77-GGG/CyberArm/mechanical/打印/README_打印前必读.md

# RevC 打印文件

2026-09-14 状态更新：当前先进行上位机/模拟控制器测试，测试通过并完成打印准备审查后再使用打印件。模型尚可修改，本目录是现有 RevC 的候选资产；若几何更新，必须换成对应的新版本 STL，不能直接沿用旧件。进入制作阶段后仍先接口试装，再整机打印。

整理日期：2026-09-08。适用：拓竹 P1S、PLA Basic。此目录是当前 RevC STL 的分类副本，没有修改模型、孔径或缩放；没有混入旧版、舵机、原厂舵盘或金属五金模型。

## 三个文件夹怎么用

| 文件夹 | 内容 | 用法 |
|---|---|---|
| `01_所有完整打印件` | 12 种完整零件，整套需要 16 件 | 完整件总清单；文件名已标出数量 |
| `02_先打印的接口试装片` | S01–S06 共 6 个局部接口试片 | 先验证实物舵盘孔距、检修孔、螺丝和螺母叠厚；不是整机零件 |
| `03_不单独打印试片的零件` | 7 种没有专用舵盘接口试片的完整件 | 从 01 中单独分类的副本；打印完整件后仍需检查装配 |

**不要把三个目录全部导入并一起打印：03 与 01 部分重复。** 01 是整套零件的唯一计数依据；文件名“打印 4 件”表示切片软件里要设置 4 个实例，不是 STL 已经包含 4 个。试片另外计数，不计入整机 16 件。

03 的含义仅是“不额外打印独立接口试片”，不是“无需试装”或“已经验证能用”。尤其底座、小臂的舵机安装位，以及夹爪销轴和连杆配合，仍需用实物完整试装。

## 完整件数量与分类

| 编号 | 零件 | 每台数量 | 对应独立试片 |
|---|---|---:|---|
| 01 | 底座壳 Base | 1 | 无；需检查舵机安装耳、支承和底座固定 |
| 02 | 支脚 Pata_de_Soporte | 4 | 无；需检查底座连接及接地 |
| 03 | 回转盘与肩部支架 Waist | 1 | S01 |
| 04 | 大臂 Arm_01 | 1 | S02、S03 |
| 05 | 小臂 Arm_02_v3 | 1 | 无；需检查舵机安装位和腕部避让 |
| 06 | 腕部支架 Arm_03 | 1 | S04 |
| 07 | 夹爪底板 Gripper_base | 1 | S05 |
| 08 | 从动齿轮连杆 gear1 | 1 | 无；需检查啮合和销轴配合 |
| 09 | 夹爪短连杆 grip_link_1 | 2 | 无；需检查两侧销轴配合 |
| 10 | 左夹爪 Gripper_1 | 1 | 无；需检查销轴及夹爪联动 |
| 11 | 主动齿轮连杆 gear2 | 1 | S06 |
| 12 | 右夹爪 Gripper_1_1 | 1 | 无；需检查销轴及夹爪联动 |

试片通过后再打印对应完整零件；试片不能代替整件，也不能验证相邻固定支架、舵机全部安装空间或强度。

## 先打印哪些试片

| 试片 | 接口 | 要使用的实物舵盘 |
|---|---|---|
| S01 | 底座回转 | MG996R 圆盘，选孔中心距 14 mm |
| S02 | 肩关节 | MG996R 圆盘，选孔中心距 14 mm |
| S03 | 肘关节 | MG996R 圆盘，选孔中心距 14 mm |
| S04 | 腕旋转 | MG90S 双臂，选孔中心距 12 mm |
| S05 | 腕俯仰 | MG90S 十字的长臂，选孔中心距 12 mm |
| S06 | 夹爪驱动 | MG90S 单臂，同侧距轴心 6 / 11 mm 两孔，孔距 5 mm |

每个试片先打印 1 件。S02、S03 的接口设计相同，可以先试其中一个，两个文件均保留用于对应位置核对。孔距来自当前模型，仍须和你的实物舵盘比对，不代表已完成实测。

本方案舵盘与打印件使用 M2 通栓、垫片和螺母连接，原厂中心短螺丝只用于舵盘锁紧。原厂舵盘的选定孔需在确认孔距后离机加工至 Ø2.2；打印件对应通孔为 Ø2.4。不能强拉螺丝对孔，也不要打印舵盘花键来替代原厂件。完整方法见 [RevC 连接与试装说明](E:/CyberArm/mechanical/arduino_reference_revC/ASSEMBLY_RevC_zh.md) 和 [连接图册](E:/CyberArm/mechanical/arduino_reference_revC/connections.html)。

## 切片与未完成事项

- STL 按毫米导出；导入 Bambu Studio 时保持 100% 尺寸。支脚、连杆复制数量按清单设置。不要整体缩放来修正孔径。
- 所有单件包围盒均小于 167 mm，但本目录尚未做多件排板、支撑优化或生成 3MF / G-code；壁数、填充和摆放方向需要切片时确认。
- 大臂 Arm_01 沿用源模型的主臂和小钩附件两个相交网格壳。它们原样保留；检查切片层预览是否形成连续实体，不要误删附件或忽略重叠壳问题。
- 当前是接口试装版，所有完整件的 `final_print_release` 仍为 `false`。底座固定、关节支承、全行程干涉、实际重量和持续承载尚未完成实物验证；不要把这里的分类当成整机打印放行。
- 先完成接口验证和完整件干装，再按 [结构、载荷与电流复核](E:/CyberArm/mechanical/arduino_reference_revC/audit_20260907/结构载荷与电流复核_20260907.md) 处理支承/固定问题并测试。当前未确认额定夹取质量。

`打印数量清单.csv` 可用表格软件打开；`文件来源与校验.json` 记录原始位置、分类副本、数量、尺寸和 SHA256。此次只复制和分类，不改变原 RevC 文件及 Blender 装配。
