77-GGG/CyberArm/mechanical/arduino_reference_revC/audit_20260907/结构载荷与电流复核_20260907.md

# RevC 结构、夹取质量与电流复核

日期：2026-09-07。对象：`Arduino_Replica_RevC_Connections.blend` 中的 `Arduino_Original_Replica` 装配场景。

用户已确认：PLA Basic，所有舵机均为 5 V 供电。电源额定安培数、打印切片重量、实物舵机批次性能尚未提供。

## 结论

**当前版本不具备“全行程、可持续夹取某个最大质量”的定版依据，不能把 100 g 写成额定载荷。**

- 主要限制是肩关节自重力矩、腕俯仰 MG90S、底座抗倾覆和关节支承；不能靠加粗大臂或增大供电电流解决全部问题。
- 原结构没有外置底座止推/径向轴承，也没有完成肩部双侧支承。舵机输出轴、塑料舵盘和安装耳承担了转矩以外的负荷，厂商未给出这里需要的外部弯矩/轴向载荷额定值。
- 支脚只有可靠锁紧、共同着地才扩大支承范围。无可靠支脚支承时，较大伸展姿态可能空载倾覆。
- **6 台舵机的电源选型暂按 10.5 A 峰值预算，建议舵机独立使用稳压 5 V / 15 A（75 W）电源。** 这是工程预算，不是本批实物已经测出的最大电流，不是允许持续堵转。主控、视觉板等用电另算。
- 尚未确定可认证的最大夹取质量。固定底座、确认装配和限位后，只能先做无载及 5 g、10 g 的短时低速验证；这些是试验台阶，不是额定载荷。

本次只做读取、计算与报告，没有修改装配、STL、既有说明书或固件，也没有保存/覆盖 Blender 窗口中未保存的状态。

## 1. 核算依据和边界

### 几何与质量

使用现有 16 个打印件实例：12 种零件，其中支脚 4 个、短连杆 2 个。以闭合三角网格四面体积分计算实体体积和质心，不用包围盒体积代替实体体积。

PLA Basic 密度取 1.24 g/cm³，来源于 [Bambu Lab 技术数据表](https://store.bblcdn.com/s7/default/b189de92249a4b9ebed28b8ea1f080f0/Bambu_PLA_Basic_Technical_Data_Sheet.pdf)。

| 质量项 | 本次代理值 |
|---|---:|
| 所有打印件按几何实体完全填满 | 460.5 g |
| MG996R ×3，55 g/个 | 165.0 g |
| MG90S ×3，13.4 g/个 | 40.2 g |
| 已建金属螺钉、螺母、垫圈和夹爪销轴，按钢密度 | 16.0 g |
| 六片原厂塑料舵盘质量占位 | 6.3 g |
| 未建模的安装五金及末端线缆余量 | 28.0 g |
| 合计，不含负载、控制板、相机、额外配重 | 716.0 g |

舵机质量和力矩来源：[TowerPro MG996R](https://towerpro.com.tw/product/mg996r/)、[TowerPro MG90S](https://towerpro.com.tw/product/mg90s-3/)。舵机内部质心用壳体内近似点；金属件材质、线材余量和舵盘质量均未实称。

**460.5 g 不是切片预测重量。** 同时计算打印塑料为实心质量 75%、50% 的敏感性工况。这里的 75%、50% 是“实际零件重量/几何实心重量”，不是切片填充率；壁厚、顶底层、打印方向和内部壳体都会改变这个比例。

减轻大臂、小臂通常减少舵机负担；只减轻底座却会减小抗倾覆余量。因此不能把全实心质量情形当成所有失效模式的最坏情况。

### 力矩方法

本机为 5 V；采用厂商 4.8 V 的力矩作为保守参考，不把 6 V 的性能套用到 5 V：

- MG996R：堵转 9.4 kgf·cm = 0.9218 N·m。
- MG90S：堵转 1.8 kgf·cm = 0.1765 N·m。

各关节静力矩按 `Σ 关节轴方向 · [(质心位置−轴心) × 重力]` 计算；逐个分配对应下游零件、舵机、五金和线材，不把所有电机错误地加到腕部。

负载作用点取夹爪末端的对称参考位置。实际物体重心若更远、偏侧或夹持位置不同，应重新计算。

表中的“50% 堵转筛选”表示暂留约 2 倍静态力矩余量，**是工程筛选假设，不是厂商连续转矩额定值**。厂商没有提供本工况的连续负载/占空比/温升曲线，故不能据此宣布可以长期保持或快速运动。另计算 30% 堵转情形时，所列三种质量工况的肩部都没有剩余载荷预算。

## 2. 最大夹取质量：只能给条件计算，不能给实物额定值

保存姿态夹点距底座回转轴约 265 mm。另取近水平伸展的几何参考姿态，夹点约 334 mm，大臂两关节轴距 120 mm。

334 mm 工况是运动学参考；它超过现有部分预览角度，**尚未验证实际舵机角度、全机碰撞、线缆和硬限位，不可照抄到舵机控制程序**。这不是已经确认的最大安全臂展。

### 肩关节自重静力矩

| 打印件质量假设 | 整机质量代理 | 保存姿态，无物体 | 近水平伸展，无物体 |
|---|---:|---:|---:|
| 实心质量的 100% | 716 g | 0.4166 N·m | 0.5453 N·m |
| 实心质量的 75% | 601 g | 0.3574 N·m | 0.4680 N·m |
| 实心质量的 50% | 486 g | 0.2982 N·m | 0.3908 N·m |

MG996R 的 50% 堵转筛选预算仅为 0.4609 N·m。因此在较重的两种伸展工况下，仅自重就耗尽了这一预算。最重工况空载约占参考堵转力矩 59%；加 50 g 后肩部约需 0.716 N·m，加 100 g 后约需 0.886 N·m，已经接近堵转参考值。

### 仅按关节力矩的附加负载筛选

下表取肩、肘、腕旋转、腕俯仰四项限制中的最小值；**还未把真实夹持摩擦、打印强度、倾覆或动态加速度认证计入**。

| 打印件质量假设 | 265 mm 保存姿态 | 334 mm 近水平参考姿态 |
|---|---:|---:|
| 实心质量的 100% | 约 16 g | 0 g 余量 |
| 实心质量的 75% | 约 38 g | 0 g 余量 |
| 实心质量的 50% | 约 60 g | 约 21 g |

“0 g 余量”表示连空载都未满足选定的 2 倍静态力矩余量，**不是说舵机完全抬不起来**。

腕俯仰也不可忽略：较重的近水平工况，在该筛选标准下约剩 45 g 的负载预算。即使给肩部加助力，也不能自动把全机额定载荷提高到几百克。

现有预览角度内另外抽查 405 个姿态，发现肩部空载力矩最高约 0.50 N·m，也超过了 0.4609 N·m 的筛选预算。该抽样不是连续全空间最大值或无碰撞验证。

### 夹爪本身能否抓住

采用已保存的四连杆运动关系，按末端代表点的开合位移求虚功关系 `T = N × d(开口)/d(舵机角度)`。在夹爪偏转 −8° 到 +8° 的样本中，按半堵转转矩得到每侧理想法向力约 2.5～4.5 N。

举例：若摩擦系数仅 0.2、机构效率暂取 0.6，则抗滑质量估算约 62～111 g。**这两个参数都是假设，物体材质、接触法线、打印纹理、夹持位置、机构自重功和磨损没有实测，不能据此承诺夹爪额定载荷。** 光滑物体、偏心物体可能更早滑落。加防滑软垫可改善摩擦，但不会提升肩部舵机转矩。

## 3. 抗倾覆与结构稳定性

### 接地支承

底座外径约 130 mm，四脚接地凸包包络约 195 × 195 mm。模型中五个底面基本共面；实物桌面平整度、翘曲、脚垫厚度、支脚紧固和滑动均未验证。

以四脚牢固连接、共面着地、静止、不滑动为条件：

| 打印件质量假设 | 265 mm 姿态，理论刚好倾覆负载 | 334 mm 工况，理论刚好倾覆负载 | 334 mm，保留 1.5 倍抗倾覆力矩余量后的筛选负载 |
|---|---:|---:|---:|
| 100% | 约 191 g | 约 80 g | 约 20 g |
| 75% | 约 157 g | 约 63 g | 约 14 g |
| 50% | 约 122 g | 约 46 g | 约 7 g |

这些是倾覆分析，不是夹取能力。即使机械臂能抬起物体，也可能先翻倒。只减轻底座和腰部、不减轻远端的工况更差：示例计算空载就不满足 1.5 倍抗倾覆余量。

若四脚不提供有效支承，只依赖 130 mm 底座接触范围，近水平参考姿态的自重质心已越过支承边界。**优先采用可靠桌面夹持/螺栓固定，而不是再把底座外形做大。** 本次未设计或验证夹具。

橡皮筋/弹簧装在机械臂自身两个挂点之间，是内部助力：它能减轻肩部驱动力矩，但不改变整机给定姿态的重心，不能代替固定底座来防翻。

### 必须处理或验证的局部结构

1. **底座回转支承。** 最低旋转打印表面与底座最高表面的全局高度差约 0.60 mm（局部垫台影响最低点）。没有可认定为承载止推面或外置轴承的建模结构。不能把悬空外壳当作支承，更不能直接强拧中心螺丝拉到相互摩擦。应另设计匹配的止推/径向支承，并保留转动间隙。
2. **肩、肘输出端的偏载。** 舵盘传转矩不等于舵机轴可以无限承担悬臂弯矩。需要复核对侧支点/双侧支承和轴套；仅凭 MG996R 的堵转转矩无法验证外部轴负荷。轴承选型尚无明确安装尺寸，不建议先购买某一型号再硬塞。
3. **舵盘扩孔连接。** 两孔相隔 14 mm 的 MG996R 接口，若只按螺栓孔壁传力、忽略夹紧摩擦，在 0.5 N·m 时每孔约承受 35.7 N；Ø2.2、厚 2.3 mm 舵盘的名义孔壁承压约 7.1 MPa，接近参考堵转时约 13 MPa。这尚未包括相邻孔削弱、应力集中、塑料蠕变、单侧弯曲与锁紧预载。通常不能只校核金属 M2 螺钉而忽略薄塑料舵盘。
4. **夹爪活动销轴。** 当前约 Ø3.5 孔配 Ø3 的示意销，直径间隙约 0.5 mm。多处串联后会有晃动；活动处不能把普通螺母直接拧死夹住连杆。销轴、隔套、垫圈、轴向限位和防松仍需要定版。
5. **大臂挂钩网格。** Arm_01 的主臂与小挂钩是两个独立闭合壳，检测到 96 对三角面相交：不是悬空附件，但也不是已布尔合并的一体拓扑。打印前应检查切片是否合为连续材料、挂钩根部有效截面和层纹方向。不要直接给这个小钩挂强拉簧。
6. **打印方向和热稳定性。** 主臂/小臂抽查截面的名义实心弯曲应力在 0.5 N·m 参考弯矩下约 0.16～0.37 MPa，但这不覆盖关节根部、螺孔、扭转、局部屈曲、填充及层间开裂，不能作为整机强度合格结论。PLA Basic 技术表的热变形温度约 54～57℃（依载荷条件）；舵机附近不能忽视长期温升和夹紧蠕变。

## 4. 最大电流与电源

### 不同版本资料不能混作实测值

| 型号 | 当前可核对的资料 | 本次暂用选型峰值预算 |
|---|---|---:|
| MG996R ×3 | TowerPro 官网列堵转电流 1.4 A，未在该行标测试电压；另有标为 Tower-Pro 的流传数据表列 2.5 A @6 V | 2.5 A/台 ×3 = 7.5 A |
| MG90S ×3 | TowerPro 官网没有堵转电流；其他厂商同名型号资料给出约 0.75 A @4.8 V、0.86～0.9 A @6 V，不等于你的批次 | 1.0 A/台 ×3 = 3.0 A |
| 六舵机合计 | 5 V 下真实同时启动/堵转峰值仍需测量 | **10.5 A，52.5 W** |

来源：[TowerPro MG996R 官网](https://towerpro.com.tw/product/mg996r/)、[标为 Tower-Pro 的 MG996R 数据表副本](https://www.allaboutcircuits.com/uploads/articles/MG996R_Tower-Pro.pdf)、[Sky Star MG90S 厂商数据表副本](https://www.tinytronics.nl/product_files/000263_Data_Sheet_of_MG90S_Analog_Servo_Motor.pdf)、[MATRIX 自有 MG90S 产品说明](https://www.matrixrobotics.com/product/electrical-components/servo/matrix-micro-servo-with-metal-gear-box)。

2.5 A 是用较高参考值给 5 V 供电留余量，并非宣称该电机在 5 V 恰好堵转 2.5 A；1 A 同样是设计占位。型号相同不保证内部电机和控制电路相同，以上预算不能包住所有仿制批次的极值。**真正最大电流必须结合实物、电压、线损、峰值采样方式确认。** 正常运动/保持电流也不能仅从 CAD 精确求出。

六舵机 10.5 A 预算留 25% 余量为 13.125 A，故选型建议取 **稳压 5 V / 15 A**。这表示电源可提供的能力，不会强迫舵机持续吸收 15 A。

- 此建议仅用于舵机电源域。若 ESP32、K230D、摄像头、显示屏共用同一 5 V 电源，应把它们的实测峰值加上后再留余量，不能宣称 15 A 必然覆盖整套系统。
- 大电流通过合适的独立配电母线、连接器和保护件，不经过开发板 5 V 小引脚、普通杜邦线/面包板的公共电源通道。控制板与舵机采用合适的星形共地。
- 不能默认任意 PCA9685 转接板的端子和铜箔可通过 10.5 A 总电流；芯片负责 PWM，不代表转接板供电路径具备该额定电流。
- 电源/配电需要按导线与连接器能力配置限流、支路保护和可切断舵机电源的急停。PCA9685 的 OE 只关闭 PWM，不能代替物理断开电源。
- 不靠长时间卡死舵机测“最大电流”。先逐台受控、低速、小载荷测启动峰值、保持电流、舵机端电压，再验证多轴同时启动压降。出现卡死、发热、抖动、异响、变形或电压明显下跌立即卸载断电。试验时下方放软托盘、手离开夹点；断电后机械臂可能下落。

项目旧总体设计文档仍有“五路 MG90S”的电源配置描述，与当前“三路 MG996R + 三路 MG90S”不同，不能沿用旧负载预算。本次只是复核，没有擅自改写总体方案或固件。

## 5. 下一步放行条件

1. 先完成桌面固定、底座独立支承及关节防晃方案；确认安装耳、夹爪活动销轴和支脚的完整五金。
2. 用 P1S / PLA Basic 的实际壁数、顶底层、填充和打印方向切片，记录每个零件扣除支撑后的质量，替换本报告的实心比例假设。关键挂钩和连接件检查切片连续性，接口先做试片。
3. 用实物检查舵盘孔位、厚度、花键、中心锁紧螺丝和原厂安装螺丝；没有实测尺寸不能保证每批次通配。
4. 逐轴确定无碰撞机械行程和 PWM 限位；打印前后的零件联动预览不等于电气限位标定。
5. 固定底座，先空载低速短时试动，再按当时力矩余量做 5 g、10 g 阶梯试验。记录姿态、作用距离、持续时间、温升、端电压、峰值电流和末端下垂；没有余量的姿态不加重。
6. 只有上述数据合格后，才能定义“最大质量 + 工作范围 + 速度/加速度 + 连续保持时间”的联合指标。现阶段不能给出单一、可靠的全范围最大夹取质量。

## 计算记录

- `baseline_geometry.json`：各实例体积、质心、质量分配、轴心、支承凸包、网格指纹。
- `static_load_screen.json`：两类姿态和不同重量假设的静力矩、负载余量、倾覆计算。
- `preview_pose_sweep.json`：405 个预览姿态抽样，未做碰撞放行。
- `kinematic_crosscheck.json`：独立矩阵前向计算与 Blender 驱动器交叉比对，通过，最大矩阵分量误差约 2.2e−5。
- `beam_sections.json`：局部截面几何积分，不是 FEA。
- `hook_attachment_check.json`：挂钩与主臂独立壳相交检查。
- `gripper_virtual_work.json`：夹爪代表点虚功估算，不是实测夹紧力或接触仿真。
- 重算脚本：`E:/CyberArm/mechanical/revC_stability_audit.py`，仅在后台载入模型后运行，不保存 `.blend`。

**未完成：实物装配、真实切片质量、连续温升/负载、结构 FEA、全范围连续碰撞、打印疲劳、刚度/寿命、动态倾覆、配电实物验证。**
