77-GGG/CyberArm/slides/CyberArm_展示逐页内容方案.md

# CyberArm 展示逐页内容方案

## 总体安排

- 主版本共 9 页，适合约 7 分钟的现场介绍。
- 视觉识别本轮不展开，只说明系统预留了输入接口。
- 第 6 页集中解释正运动学、逆运动学和求解加速过程。
- 第 7 页把上位机联动与逐关节标定放在同一条链路中说明。
- 删除原方案中的串口长报文调试案例、完成度表和下一步页面。
- 最后一页直接说明机械结构、舵机和开环控制的局限。

版本口径：`CyberArm_RevL_Final.blend` 是当前最终机械 CAD；现有上位机的 `simulator/assets/revc/robot.json` 仍标记为 RevC。若演示前尚未重新导出 RevL 的关节、TCP 与碰撞资产，幻灯片应把渲染图称为“RevL 最终机械方案”，把上位机画面称为“当前控制模型”，不要宣称两者参数已经完全同步。

## 已生成的模型素材

- `renders/CyberArm_RevL_front.png`：整机正面四分之三视角，适合封面或结构说明。
- `renders/CyberArm_RevL_side.png`：舵机侧视角，适合执行器说明和局限性页面。
- `renders/CyberArm_RevL_rear.png`：后侧结构视角，适合标注 J1 至 J5 的关节链。
- 两张图片由 `mechanical/CyberArm_RevL_Final.blend` 的现有相机、材质和灯光渲染得到。

---

## 第 1 页｜封面

### 页面标题

**CyberArm**

### 副标题

桌面机械臂的建模、规划与实机控制

### 页面文字

清华大学电子系第 29 届硬件设计大赛  
马 +7 队｜祁果、许宇旋｜2026.09

### 画面建议

- 使用 `renders/CyberArm_RevL_front.png` 作为右侧主视觉。
- 标题放在左上或上方留白区，只保留项目名、副标题和队伍信息。
- 不放目录和功能列表。

### 讲述重点

CyberArm 是一套围绕桌面机械臂建立的软硬件系统，覆盖机械结构、运动学求解、三维仿真、逐轴标定和 ESP32-S3 实机执行。

---

## 第 2 页｜项目目标与当前样机

### 页面标题

项目目标与当前样机

### 页面主句

在接通实物之前验证动作，在接通实物之后完成安全标定和同步控制。

### 页面文字

**机械本体**

- 五个运动关节和一路夹爪
- 3 × MG996R，3 × MG90S
- RevL 3D 打印结构

**控制系统**

- ESP32-S3 负责轨迹执行与状态管理
- PCA9685 统一输出六路 PWM
- CyberArm Studio 负责模型、规划与调试

### 画面建议

- 右侧使用 `pics/0b8ecd9638317f569a953c7d0b11c092.jpg`，保留实体机械臂、控制板和电脑同框的部分。
- 左侧只保留主句和两组短说明。
- 照片旁用小字标出“实体样机”“上位机仿真”“ESP32-S3 + PCA9685”。

### 讲述重点

项目重点是把模型中的关节姿态可靠地传递到实体机械臂，并让每一步都能够检查、标定和停止。视觉能力后续沿用同一套规划与执行接口。

---

## 第 3 页｜机械结构与方案演化

### 页面标题

机械结构与方案演化

### 页面主句

承载、装配和调试需求推动机械臂从开题构型演化到 RevL。

### 页面文字

| 开题阶段 | 当前 RevL |
|---|---|
| 四个运动关节和一路夹爪 | 五个运动关节和一路夹爪 |
| 五路 MG90S | 3 路 MG996R 与 3 路 MG90S |
| 简化串联夹爪 | 两片式夹爪与连杆机构 |
| 先实现多种交互模式 | 先完成运动、标定与安全链路 |

### 结构说明

- J1：底座回转
- J2：肩关节俯仰
- J3：肘关节俯仰
- J4：腕部旋转
- J5：腕部俯仰
- G：夹爪开合

### 画面建议

- 使用 `renders/CyberArm_RevL_rear.png` 作为大图。
- 在图上直接标出 J1 至 J5 与 G，不额外画六个说明卡片。
- 开题与 RevL 的对比表缩小放在左侧。

### 讲述重点

肩、肘和底座改用 MG996R，提高承载余量。腕部与夹爪继续使用较轻的 MG90S，降低远端质量。RevL 保留五轴拓扑，不追求任意六维末端姿态。

---

## 第 4 页｜硬件与电气连接

### 页面标题

硬件与电气连接

### 页面主句

控制、PWM 和舵机供电分层连接，舵机大电流不经过 ESP32-S3 的稳压链路。

### 页面中的连接图

```text
CyberArm Studio
        USB CDC / JSONL
ESP32-S3 DevKitC-1
        I²C：GPIO8 / GPIO9，400 kHz
PCA9685：地址 0x40，50 Hz
        PWM0 至 PWM5
J1    J2    J3    J4    J5    G
```

### 图旁标注

- PCA9685 的 VCC 接 3.3 V 逻辑电源
- 舵机 V+ 使用独立约 5 V 电源
- ESP32-S3、PCA9685 和舵机电源共地
- J1 至 G 对应 PWM0 至 PWM5
- 接线定义统一保存在 `config/wiring.json`

### 画面建议

- 右侧放连接图，重点画清电源域和信号方向。
- 左下放控制板与接线近照。如果今晚补拍一张照片，优先拍 ESP32-S3、PCA9685、电源和共地连接。

### 讲述重点

USB 既承担上位机通信，也用于固件调试。PCA9685 只产生控制脉冲，舵机由独立电源供电。JSON 接线文件在编译前检查非法 GPIO、重复通道和映射错误。

---

## 第 5 页｜代码结构与控制链路

### 页面标题

软件与固件结构

### 页面主句

上位机完成模型求解和路径检查，固件完成确定性的轨迹执行与 PWM 输出。

### 页面内容

```text
React + Three.js 前端
三维显示、手动控制、自动运行、标定界面

Python 本机服务
运动学、路径规划、碰撞检查、串口桥接

USB CDC JSONL
命令、状态、心跳、标定数据

ESP32-S3 固件
CommandProtocol
MotionController
ServoSubsystem
PCA9685Servo
```

### 页面小注

- 控制周期 20 ms
- 五次曲线插补
- 1.5 s 运动看门狗
- 单轴调试使用独立租约

### 画面建议

- 用一条纵向数据链表现四层结构。
- 右下角放真实目录名：`frontend`、`backend/cyberarm`、`CyberArmFirmware`、`PCA9685Servo`。
- 不放大段源代码。

### 讲述重点

前端不直接写 PWM。所有控制请求先进入 Python 服务，经过限位、求解和路径检查后再发给固件。ESP32-S3 仍会检查状态、租约、目标范围和看门狗。

---

## 第 6 页｜正逆运动学与求解加速

### 页面标题

运动学求解与性能优化

### 页面主句

系统使用变换矩阵连乘计算正运动学，以解析雅可比和热启动阻尼高斯-牛顿计算逆运动学。

### 一、正运动学

定义五个运动关节角为

\[
\boldsymbol q = [q_1,q_2,q_3,q_4,q_5]^T .
\]

从 Blender 模型中提取每个关节的固定局部变换 \(A_i\)。各关节绕自身局部 \(z\) 轴旋转，因此末端齐次变换为

\[
T_{0E}(\boldsymbol q)
= \left(\prod_{i=1}^{5} A_i R_z(q_i)\right)A_{\mathrm{palm}}A_{\mathrm{TCP}} .
\]

末端位置和工具方向分别为

\[
\boldsymbol p(\boldsymbol q)=T_{0E}[0:3,3],
\qquad
\boldsymbol d(\boldsymbol q)=R_{0E}\boldsymbol e_z .
\]

夹爪角 \(q_6\) 只驱动齿轮与四连杆闭链，不参与 TCP 位姿计算。

### 二、逆运动学

给定目标位置 \(\boldsymbol p^*\) 和可选工具方向 \(\boldsymbol d^*\)，求解残差

\[
\boldsymbol r(\boldsymbol q)=
\begin{bmatrix}
w_p\bigl(\boldsymbol p(\boldsymbol q)-\boldsymbol p^*\bigr)\\
\boldsymbol d(\boldsymbol q)-\boldsymbol d^*
\end{bmatrix} .
\]

程序取 \(w_p=1000\)，使 1 mm 的位置误差与约 1 rad 的方向误差具有相近代价。只控制位置时去掉第二项。设第 \(i\) 个关节在基座坐标系中的轴线方向和原点为 \(\boldsymbol a_i,\boldsymbol o_i\)，解析雅可比为

\[
J_{p,i}=w_p\,\boldsymbol a_i\times
\bigl(\boldsymbol p-\boldsymbol o_i\bigr),
\qquad
J_{d,i}=\boldsymbol a_i\times\boldsymbol d .
\]

每次迭代求解

\[
\left(J^TJ+\lambda sI\right)\Delta\boldsymbol q=J^T\boldsymbol r,
\qquad
\boldsymbol q_{k+1}=\operatorname{clip}
\left(\boldsymbol q_k-\eta\Delta\boldsymbol q,\boldsymbol q_{\min},\boldsymbol q_{\max}\right),
\]

其中 \(\lambda\) 为阻尼，\(\eta\) 通过回溯搜索确定。求解从当前姿态热启动；热启动失败时，再使用零位和固定随机种子进入信任域最小二乘求解。

### 三、算法改进过程

| 初始实现 | 优化后 |
|---|---|
| 解析雅可比误用了局部 x 轴 | 改为真实旋转轴，即局部 z 轴 |
| 每个关节分别计算叉乘 | 五个关节一次向量化计算 |
| 残差与雅可比重复执行 FK | 缓存同一次计算结果 |
| 所有目标直接进入通用信任域 | 近距离目标先走热启动阻尼高斯-牛顿 |
| 路径逐点调用正运动学 | 对整条路径批量计算变换矩阵 |

### 页面保留的性能数字

- 近点移动 10 mm：79 ms 降至约 1 ms
- 末端上移 30 mm：8 ms 降至不足 1 ms
- 关节 30° 完整预览：3.599 s 降至 0.178 s

### 画面建议

- 左侧放正运动学变换链和一个带关节轴标注的机械臂线框图。
- 右侧放逆解迭代公式与三组性能数字。
- 页面正文只保留最关键的四个公式。算法改进表可移入演讲者备注，或放入附录，避免页面过密。

### 讲述重点

最初算法并非求错，而是雅可比方向错误后只能依靠通用求解器和有限差分缓慢收敛。修正关节轴、复用一次正运动学结果并增加当前姿态热启动后，连续拖动末端能够接近实时响应。判定阈值和碰撞标准没有因提速而放宽。

---

## 第 7 页｜上位机联动与逐关节标定

### 页面标题

上位机联动与关节标定

### 页面主句

仿真关节角通过实测映射转换为舵机脉宽，使模型与实体尽量保持一致。

### 页面左侧：上位机联动

**手动控制**

- 关节滑块和末端拖动实时更新仿真姿态
- 手动模式默认显示当前姿态，路径预览默认关闭
- 自动模式在执行前展示 MoveJ 或 MoveL 路径

**状态同步**

- 上位机发送目标角、分段时间和插值方式
- ESP32-S3 回报连接、使能、运动状态和故障
- 停止、断连和看门狗超时会使旧动作失效

### 页面右侧：怎样得到每个关节的角度映射

普通三线 PWM 舵机没有角度回读，因此采用人工测量标定：

1. 支撑连杆或拆开传动，只连接一个待测关节。
2. 从保守脉宽窗口开始，以 ±1 或 ±5 个 PCA9685 计数缓慢点动。
3. 对照 CAD 零姿态安装舵盘，用量角器或电子角度仪测量真实转角。
4. 在正负方向记录 3 至 7 组“角度、脉宽”测量点。
5. 设置实测覆盖范围和工作限位，保存到 ESP32 NVS 并读回验证。

对于相邻测量点 \((q_k,u_k)\) 与 \((q_{k+1},u_{k+1})\)，目标角到脉宽采用分段线性映射：

\[
u(q)=u_k+
\frac{q-q_k}{q_{k+1}-q_k}
\left(u_{k+1}-u_k\right),
\quad q\in[q_k,q_{k+1}] .
\]

### 页面必须说明

上位机显示的是指令角。机械臂运动后没有传感器返回真实角度，标定只能改善开环映射，不能形成位置闭环。

### 画面建议

- 使用完整上位机截图作为右侧或背景主视觉。
- 截图旁放一条“目标角、标定映射、PWM 脉宽、舵机动作”的短链路。
- 标定界面只截取一个关节的测量点和限位区域，不要让弹窗遮住整张界面。

### 讲述重点

逐轴标定解决三个问题：舵盘安装零位、不同舵机的方向差异、脉宽与机械角度的非理想对应。当前方法依赖人工测量，所以只能说“指令角经过实测映射”，不能说系统实时知道关节真实角度。

---

## 第 8 页｜功能展示

### 页面标题

现场演示

### 页面只保留四步

1. 启动 CyberArm Studio，展示当前控制模型和实时姿态
2. 调节关节或末端目标，展示实时逆运动学与边界反馈
3. 连接 ESP32-S3，小角度驱动已标定关节，观察仿真与实体联动
4. 触发停止或断开连接，确认输出状态和旧动作失效

### 可补充展示

- 不可达目标保持当前姿态并显示原因
- 自动模式显示路径预览、暂停、继续和停止
- 单轴标定界面显示角度测量点、工作限位和设备版本

### 备用方案

如果现场不适合继续驱动实物，使用提前录制的视频证明联动，现场改为纯仿真展示逆运动学、路径预览和碰撞拒绝。

### 画面建议

- 本页作为演示背景，只放四步流程和一张实体与上位机同框的照片。
- 不在演示时临时扩大关节限位或脉宽范围。

### 讲述重点

演示顺序先软件、后连接、再小角度实机动作，最后主动展示停止行为。这样能够同时证明功能链路和安全逻辑。

---

## 第 9 页｜当前局限

### 页面标题

机械臂的当前局限

### 页面主句

当前样机适合验证控制链路和交互方式，结构刚度、执行器性能与角度反馈仍限制实际精度。

### 页面内容

**3D 打印结构**

- PLA 构件的强度和刚度有限，长时间受力可能产生蠕变
- 打印误差、孔轴配合和装配间隙会改变理论关节中心
- 底座、肩部和夹爪在负载下可能发生弹性变形

**舵机性能**

- MG996R 与 MG90S 存在齿隙、死区和批次差异
- 低速或小角度动作容易出现抖动
- 多舵机同时启动会带来电流冲击和电源压降
- 标称扭矩不能直接代表连续负载能力

**角度与状态感知**

- 三线 PWM 舵机没有位置回读
- 上位机只能知道指令角，无法精确得知负载下的真实角度
- 系统不能直接检测堵转、丢步、齿轮滑动或外力推动
- 开环控制限制了重复定位精度和碰撞保护能力

**模型与实物差异**

- 碰撞模型不包含线缆摆动、打印件变形和未登记障碍
- 数学可达不等于实物在当前负载下能够稳定到达

### 对应改进方向

增加关节编码器或改用支持位置回读的总线舵机；加强关键承力件与轴承支撑；测量负载、回差、温升和重复定位误差后重新收缩工作范围。

### 画面建议

- 使用 `renders/CyberArm_RevL_side.png` 作为全页主图。
- 用细线直接指向肩关节、长臂、腕部舵机和夹爪，分别标出“结构变形”“齿隙与抖动”“无位置反馈”“远端负载”。
- 页面不需要再加结束语或下一步时间表。

### 讲述重点

这页主动区分“算法模型中的角度”和“实体真实角度”。当前系统能够准确记录发送了什么指令，但不能证明舵机在负载下精确到达该角度。机械结构和执行器升级后，现有上位机、运动学和协议仍可继续使用。

---

## 建议附录

附录不进入 7 分钟主线，只用于回答评委问题。

### A1｜解析雅可比推导

- 关节轴 \(\boldsymbol a_i=R_{0i}\boldsymbol e_z\)
- 关节原点 \(\boldsymbol o_i=T_{0i}[0:3,3]\)
- 位置微分 \(\partial\boldsymbol p/\partial q_i=\boldsymbol a_i\times(\boldsymbol p-\boldsymbol o_i)\)
- 工具方向微分 \(\partial\boldsymbol d/\partial q_i=\boldsymbol a_i\times\boldsymbol d\)

### A2｜轨迹与插值

固件使用五次时间缩放

\[
s(\tau)=10\tau^3-15\tau^4+6\tau^5,
\quad \tau=t/T,
\]

使轨迹首尾速度和加速度为零。关节轨迹为

\[
\boldsymbol q(t)=\boldsymbol q_0+s(t/T)
(\boldsymbol q_1-\boldsymbol q_0).
\]

### A3｜标定与有效范围

每个关节的最终有效范围取以下范围的交集：

\[
Q_{\mathrm{effective}}
=Q_{\mathrm{model}}
\cap Q_{\mathrm{measured}}
\cap Q_{\mathrm{working}} .
\]

### A4｜性能对比

| 场景 | 优化前 | 优化后 |
|---|---:|---:|
| 近点 IK 10 mm | 79 ms | 约 1 ms |
| 上移 30 mm IK | 8 ms | 不足 1 ms |
| 关节 30° 完整预览 | 3.599 s | 0.178 s |
| 夹爪 20° 完整预览 | 1.520 s | 0.137 s |
| MoveL 上移 100 mm | 1.626 s | 0.196 s |

---

## 现场讲述节奏

| 页码 | 建议时间 |
|---:|---:|
| 1 | 15 秒 |
| 2 | 35 秒 |
| 3 | 40 秒 |
| 4 | 40 秒 |
| 5 | 40 秒 |
| 6 | 80 秒 |
| 7 | 65 秒 |
| 8 | 90 秒 |
| 9 | 35 秒 |

合计约 7 分钟。第 6 页只口头解释“变换连乘、解析雅可比、热启动”三个层次，不逐项推导全部公式。

---

## 内容依据

- `mechanical/CyberArm_RevL_Final.blend`
- `docs/上位机预览性能优化_20260914.md`
- `docs/CyberArm_设计文档.md`
- `docs/技术决策与问题记录.md`
- `docs/上位机界面与实机调试_20260917.md`
- `docs/单轴调试操作手册_20260918.md`
- `simulator/backend/cyberarm/planner.py`
- `simulator/core/core.cpp`
- `config/wiring.json`
- `lib/CyberArmFirmware/src/CalibrationCore.h`
