77-GGG/CyberArm/slides/CyberArm_deck/main.tex

\documentclass[aspectratio=169,10pt]{beamer}
\usepackage{../beamer_template/beamerthemeCaseStudy}
\usepackage{amsmath,bm,array}
\usetikzlibrary{positioning,arrows.meta}

\graphicspath{{../renders/}{../pics/}{../../desktop/test-results/}}

\newcommand{\Lead}[1]{%
  {\fontsize{8.8}{11.0}\selectfont\color{CaseText}#1}%
}
\newcommand{\Body}[1]{%
  {\fontsize{7.1}{9.3}\selectfont\color{CaseText}#1}%
}
\newcommand{\Small}[1]{%
  {\fontsize{5.8}{7.4}\selectfont\color{CaseText}#1}%
}
\newcommand{\TinyGray}[1]{%
  {\fontsize{5.0}{6.4}\selectfont\color{CaseGray}#1}%
}
\newcommand{\RedLabel}[1]{%
  {\fontsize{6.0}{7.2}\selectfont\bfseries\color{CaseRed}#1}%
}
\newcommand{\Metric}[2]{%
  {\fontsize{10.5}{12.0}\selectfont\color{CaseGray}#1}\hspace{0.12cm}%
  {\fontsize{10.5}{12.0}\selectfont\color{CaseRed}\bfseries #2}%
}
\newcommand{\Num}[1]{%
  \tikz[baseline=-0.55ex]\node[circle,fill=CaseRed,text=white,inner sep=1.7pt,
    font=\fontsize{5.5}{6.0}\selectfont\bfseries]{#1};%
}

\begin{document}

% -----------------------------------------------------------------------------
% 01 COVER
% -----------------------------------------------------------------------------
\begin{frame}[plain]
  \CasePlace{0.82cm}{0.70cm}{%
    \begin{minipage}{5.2cm}
      {\fontsize{23}{25}\selectfont\color{CaseRed}CyberArm\par}
    \end{minipage}}
  \CaseImage{6.25cm}{1.05cm}{9.35cm}{CyberArm_RevL_front.png}
  \CasePlace{0.86cm}{6.75cm}{%
    \begin{minipage}{4.7cm}
      {\fontsize{7.0}{8.8}\selectfont
       清华大学电子系第 29 届硬件设计大赛\par
       \vspace{0.15cm}
       马 +7 队\par
       祁果 \quad 许宇旋\par
       \vspace{0.12cm}
       2026.09}
    \end{minipage}}
\end{frame}

% -----------------------------------------------------------------------------
% 02 GOAL AND PROTOTYPE
% -----------------------------------------------------------------------------
\begin{caseframe}{项目目标与当前样机}{CyberArm}{ Hardware Prototype}
  \CasePlace{0.55cm}{1.22cm}{%
    \begin{minipage}{4.55cm}
      \Lead{在接通实物之前验证动作，接通实物之后完成安全标定与同步控制。}
      \vspace{0.48cm}

      \RedLabel{机械本体}\par
      \vspace{0.08cm}
      \Body{五个运动关节与一路夹爪\par
      3 × MG996R，3 × MG90S\par
      3D 打印结构}

      \vspace{0.42cm}
      \RedLabel{控制系统}\par
      \vspace{0.08cm}
      \Body{ESP32-S3 管理状态与轨迹执行\par
      PCA9685 统一输出六路 PWM\par
      CyberArm Studio 负责模型与规划}
    \end{minipage}}
  \CaseImage{5.62cm}{1.28cm}{9.80cm}{0b8ecd9638317f569a953c7d0b11c092.jpg}
  \CaseKeyword{0.55cm}{7.55cm}{SIMULATION / CALIBRATION / CONTROL}
\end{caseframe}

% -----------------------------------------------------------------------------
% 03 MECHANICAL EVOLUTION
% -----------------------------------------------------------------------------
\begin{caseframe}{机械结构与方案演化}{CyberArm}{ Five-axis + Gripper}
  \CasePlace{0.85cm}{1.45cm}{%
    \begin{minipage}{14.2cm}
      \Lead{根据承载、装配与调试需求，逐步完善关节配置与机械结构。}
    \end{minipage}}
  \CasePlace{0.85cm}{2.65cm}{%
    \begin{minipage}{9.0cm}
      \setlength{\tabcolsep}{0pt}
      \begin{tabular}{@{}p{3.8cm}p{5.2cm}@{}}
      \RedLabel{开题阶段} & \RedLabel{当前方案} \\[0.55cm]
      \Lead{四关节 + 夹爪} & \Lead{五关节 + 夹爪} \\[0.60cm]
      \Body{五路 MG90S} & \Body{3 × MG996R + 3 × MG90S} \\[0.60cm]
      \Body{简化夹爪} & \Body{两片式夹爪与连杆机构} \\[0.60cm]
      \Body{功能优先} & \Body{运动、标定与安全链路优先} \\
      \end{tabular}
    \end{minipage}}
  \CasePlace{11.15cm}{2.65cm}{%
    \begin{minipage}{4.0cm}
      \RedLabel{关节定义}\par
      \vspace{0.55cm}
      \Body{J1\quad 底座回转\par\vspace{0.30cm}
      J2\quad 肩俯仰\par\vspace{0.30cm}
      J3\quad 肘俯仰\par\vspace{0.30cm}
      J4\quad 腕旋转\par\vspace{0.30cm}
      J5\quad 腕俯仰\par\vspace{0.30cm}
      G\quad 夹爪开合}
    \end{minipage}}
\end{caseframe}

% -----------------------------------------------------------------------------
% 04 HARDWARE
% -----------------------------------------------------------------------------
\begin{caseframe}{硬件与电气连接}{ESP32-S3}{ + PCA9685}
  \CasePlace{0.58cm}{1.24cm}{%
    \begin{minipage}{4.55cm}
      \Lead{逻辑电源与舵机电源分离，六路 PWM 由同一控制链产生。}
      \vspace{0.48cm}
      \RedLabel{供电原则}\par
      \vspace{0.08cm}
      \Body{PCA9685 VCC 接 3.3 V\par
      舵机 V+ 使用独立约 5 V 电源\par
      ESP32-S3、驱动板与舵机电源共地}

      \vspace{0.40cm}
      \RedLabel{配置入口}\par
      \vspace{0.08cm}
      \Body{J1 至 G 对应 PWM0 至 PWM5\par
      \texttt{config/wiring.json} 统一记录接线\par
      编译前检查重复通道与非法配置}
    \end{minipage}}

  \CasePlace{5.65cm}{1.34cm}{%
    \begin{tikzpicture}[x=1cm,y=1cm]
      \draw[CaseLightGray,line width=0.45pt] (0,0) -- (9.45,0);
      \node[anchor=west] at (0,5.65) {\fontsize{8.5}{10}\selectfont\bfseries CyberArm Studio};
      \node[anchor=east,text=CaseGray] at (9.4,5.65) {\fontsize{5.8}{7}\selectfont PC};
      \draw[CaseRed,line width=1.1pt] (0,5.24) -- (9.45,5.24);
      \node[anchor=west,text=CaseRed] at (0,4.88) {\fontsize{6.2}{7}\selectfont USB CDC / JSONL};

      \node[anchor=west] at (0,4.12) {\fontsize{8.5}{10}\selectfont\bfseries ESP32-S3 DevKitC-1};
      \node[anchor=east,text=CaseGray] at (9.4,4.12) {\fontsize{5.8}{7}\selectfont 状态、轨迹、看门狗};
      \draw[CaseLightGray,line width=0.45pt] (0,3.72) -- (9.45,3.72);
      \node[anchor=west,text=CaseRed] at (0,3.34) {\fontsize{6.2}{7}\selectfont I\textsuperscript{2}C · GPIO8 / GPIO9 · 400 kHz};

      \node[anchor=west] at (0,2.58) {\fontsize{8.5}{10}\selectfont\bfseries PCA9685};
      \node[anchor=east,text=CaseGray] at (9.4,2.58) {\fontsize{5.8}{7}\selectfont 0x40 · 50 Hz};
      \draw[CaseLightGray,line width=0.45pt] (0,2.16) -- (9.45,2.16);

      \foreach \x/\name in {0/J1,1.65/J2,3.30/J3,4.95/J4,6.60/J5,8.25/G}{
        \draw[CaseRed,line width=0.65pt] (\x+0.43,1.80) -- (\x+0.43,1.34);
        \node[anchor=north] at (\x+0.43,1.24) {\fontsize{7.2}{8}\selectfont\bfseries \name};
      }
      \node[anchor=west,text=CaseGray] at (0,0.52) {\fontsize{5.6}{7}\selectfont MG996R × 3};
      \node[anchor=east,text=CaseGray] at (9.4,0.52) {\fontsize{5.6}{7}\selectfont MG90S × 3};
    \end{tikzpicture}}
\end{caseframe}

% -----------------------------------------------------------------------------
% 05 SOFTWARE
% -----------------------------------------------------------------------------
\begin{caseframe}{软件与固件结构}{CyberArm Studio}{ Control Stack}
  \CasePlace{0.58cm}{1.28cm}{%
    \begin{minipage}{5.15cm}
      \Lead{上位机负责求解与检查，固件负责确定性的轨迹执行。}
      \vspace{0.48cm}

      \RedLabel{React + Three.js}\par
      \Body{三维显示、手动控制、自动运行、标定界面}
      \vspace{0.28cm}

      \RedLabel{Python 本机服务}\par
      \Body{运动学、路径规划、碰撞检查、串口桥接}
      \vspace{0.28cm}

      \RedLabel{USB CDC JSONL}\par
      \Body{命令、状态、心跳与标定数据}
      \vspace{0.28cm}

      \RedLabel{ESP32-S3 固件}\par
      \Body{协议解析、轨迹执行、舵机输出}
    \end{minipage}}

  \CasePlace{6.25cm}{1.42cm}{%
    \begin{tikzpicture}[x=1cm,y=1cm]
      \draw[CaseLightGray,line width=0.7pt] (0.62,0.55) -- (0.62,5.95);
      \foreach \y/\n/\title/\desc in {
        5.85/1/交互/关节滑块与末端目标,
        4.52/2/规划/IK、限位与整段碰撞检查,
        3.19/3/传输/计划版本、目标角与分段时间,
        1.86/4/执行/20 ms 控制周期与五次插补,
        0.53/5/输出/角度映射为六路 PWM}{
        \node[anchor=center,circle,fill=CaseRed,text=white,inner sep=2.0pt,
          font=\fontsize{5.8}{6}\selectfont\bfseries] at (0.62,\y) {\n};
        \node[anchor=west] at (1.10,\y+0.13) {\fontsize{7.6}{8.5}\selectfont\bfseries \title};
        \node[anchor=west,text=CaseGray] at (1.10,\y-0.22) {\fontsize{5.8}{7}\selectfont \desc};
      }
    \end{tikzpicture}}
  \CaseKeyword{6.25cm}{7.73cm}{ONE CONTROL PATH}
\end{caseframe}

% -----------------------------------------------------------------------------
% 06 KINEMATICS
% -----------------------------------------------------------------------------
\begin{caseframe}{运动学求解与性能优化}{FK / IK}{ Analytic Jacobian}
  \CasePlace{0.52cm}{1.17cm}{%
    \begin{minipage}{7.55cm}
      \RedLabel{正运动学}\par
      \vspace{0.06cm}
      \Small{每个关节绕自身局部 $z$ 轴旋转。固定局部变换 $A_i$ 来自机械模型。}
      \vspace{0.10cm}
      {\fontsize{7.6}{9.4}\selectfont
      \[
      T_{0E}(\bm q)=\left(\prod_{i=1}^{5}A_iR_z(q_i)\right)
      A_{\mathrm{palm}}A_{\mathrm{TCP}}
      \]}
      \vspace{-0.14cm}
      {\fontsize{6.8}{8.6}\selectfont
      \[
      \bm p(\bm q)=T_{0E}[0\!:\!3,3],\qquad
      \bm d(\bm q)=R_{0E}\bm e_z
      \]}

      \vspace{0.12cm}
      \RedLabel{解析雅可比}\par
      \vspace{0.06cm}
      \Small{关节轴与原点记为 $\bm a_i,\bm o_i$，目标为 $\bm p^*,\bm d^*$。}
      \vspace{0.04cm}
      {\fontsize{6.7}{8.5}\selectfont
      \[
      \bm r=\begin{bmatrix}1000(\bm p-\bm p^*)\\ \bm d-\bm d^*\end{bmatrix},
      \quad
      J_{p,i}=1000\,\bm a_i\!\times\!(\bm p-\bm o_i),
      \quad
      J_{d,i}=\bm a_i\!\times\!\bm d
      \]}

      \vspace{0.08cm}
      \RedLabel{热启动阻尼高斯-牛顿}\par
      \vspace{0.02cm}
      {\fontsize{6.6}{8.4}\selectfont
      \[
      (J^TJ+\lambda sI)\Delta\bm q=J^T\bm r,
      \qquad
      \bm q_{k+1}=\operatorname{clip}(\bm q_k-\eta\Delta\bm q)
      \]}
      \vspace{-0.12cm}
      \TinyGray{从当前姿态热启动；失败时再进入多种子信任域最小二乘。}
    \end{minipage}}

  \CasePlace{8.56cm}{1.20cm}{%
    \begin{minipage}{6.72cm}
      \Lead{求解从“通用迭代为主”变为“近点快速修正为主”。}
      \vspace{0.38cm}

      \Num{1}\hspace{0.12cm}\Body{雅可比轴从错误的局部 $x$ 轴改为真实的局部 $z$ 轴}\par
      \vspace{0.25cm}
      \Num{2}\hspace{0.12cm}\Body{五个关节一次计算叉乘，并复用同一次 FK}\par
      \vspace{0.25cm}
      \Num{3}\hspace{0.12cm}\Body{当前姿态热启动，冷种子才调用通用信任域}\par
      \vspace{0.25cm}
      \Num{4}\hspace{0.12cm}\Body{整条路径批量计算正运动学}\par

      \vspace{0.46cm}
      \RedLabel{实测耗时}\par
      \vspace{0.16cm}
      \Metric{79 ms}{1 ms}\quad\Small{近点 IK 10 mm}\par
      \vspace{0.18cm}
      \Metric{8 ms}{< 1 ms}\quad\Small{末端上移 30 mm}\par
      \vspace{0.18cm}
      \Metric{3.599 s}{0.178 s}\quad\Small{关节 30° 完整预览}
    \end{minipage}}
\end{caseframe}

% -----------------------------------------------------------------------------
% 07 CALIBRATION AND LINKAGE
% -----------------------------------------------------------------------------
\begin{caseframe}{上位机联动与关节标定}{CyberArm Studio}{ Commanded vs Measured}
  \CasePlace{0.55cm}{1.20cm}{%
    \begin{minipage}{5.05cm}
      \Lead{仿真关节角经实测映射转换为舵机脉宽。}
      \vspace{0.34cm}

      \Num{1}\hspace{0.11cm}\Body{支撑连杆，只接入一个待测关节}\par
      \vspace{0.22cm}
      \Num{2}\hspace{0.11cm}\Body{从 1400--1600 $\mu$s 窄窗口开始点动}\par
      \vspace{0.22cm}
      \Num{3}\hspace{0.11cm}\Body{对照 CAD 零位，用外部量具读取真实角度}\par
      \vspace{0.22cm}
      \Num{4}\hspace{0.11cm}\Body{正负方向记录 3--7 组角度与脉宽}\par
      \vspace{0.22cm}
      \Num{5}\hspace{0.11cm}\Body{保存至 ESP32 NVS，并读回验证}\par

      \vspace{0.38cm}
      \RedLabel{分段线性映射}\par
      \vspace{-0.05cm}
      {\fontsize{6.3}{8.0}\selectfont
      \[
      u(q)=u_k+\frac{q-q_k}{q_{k+1}-q_k}(u_{k+1}-u_k)
      \]}
      \vspace{-0.18cm}
      \TinyGray{上位机显示指令角。三线 PWM 舵机没有位置回读，标定不会形成闭环。}
    \end{minipage}}

  \CaseImage{6.05cm}{1.24cm}{9.36cm}{calibration-zero-reference.png}
  \CaseKeyword{6.05cm}{7.88cm}{TARGET ANGLE / MAPPING / PWM}
\end{caseframe}

% -----------------------------------------------------------------------------
% 08 DEMO
% -----------------------------------------------------------------------------
\begin{frame}[plain]
  \begin{tikzpicture}[remember picture,overlay]
    \node[anchor=center,inner sep=0pt,text=CaseText]
      at (current page.center) {\fontsize{25}{30}\selectfont 现场演示};
  \end{tikzpicture}
\end{frame}

% -----------------------------------------------------------------------------
% 09 LIMITATIONS
% -----------------------------------------------------------------------------
\begin{caseframe}{机械臂的当前局限}{CyberArm}{ Open-loop Prototype}
  \CasePlace{0.85cm}{1.45cm}{%
    \begin{minipage}{14.2cm}
      \Lead{结构刚度、舵机性能和角度反馈共同限制实际精度。}
    \end{minipage}}
  \CasePlace{0.85cm}{3.10cm}{%
    \begin{minipage}{4.25cm}
      \RaggedRight
      \RedLabel{3D 打印结构}\par
      \vspace{0.35cm}
      \Lead{PLA 强度与刚度有限}\par
      \vspace{0.35cm}
      \Body{打印误差、孔轴间隙和负载变形会改变理论关节中心。}
    \end{minipage}}
  \CasePlace{5.90cm}{3.10cm}{%
    \begin{minipage}{4.25cm}
      \RaggedRight
      \RedLabel{舵机性能}\par
      \vspace{0.35cm}
      \Lead{小角度低速动作容易抖动}\par
      \vspace{0.35cm}
      \Body{MG996R 与 MG90S 存在齿隙、死区和批次差异，影响动作稳定性。}
    \end{minipage}}
  \CasePlace{10.95cm}{3.10cm}{%
    \begin{minipage}{4.25cm}
      \RaggedRight
      \RedLabel{角度感知}\par
      \vspace{0.35cm}
      \Lead{无法精确得知当前真实角度}\par
      \vspace{0.35cm}
      \Body{三线 PWM 舵机没有位置回读。系统只知道指令角，无法测得负载下的实际偏差。}
    \end{minipage}}
\end{caseframe}

% -----------------------------------------------------------------------------
% 10 OPEN SOURCE
% -----------------------------------------------------------------------------
\begin{caseframe}{项目开源情况}{CyberArm}{ GitHub Repository}
  \CasePlace{0.85cm}{1.45cm}{%
    \begin{minipage}{14.2cm}
      {\fontsize{18}{22}\selectfont\color{CaseRed}
       \href{https://github.com/77-GGG/CyberArm}{github.com/77-GGG/CyberArm}\par}
      \vspace{0.35cm}
      \Lead{项目仓库已公开，代码与已上传的设计资料可在线查看和下载。}
    \end{minipage}}
  \CasePlace{0.85cm}{3.25cm}{%
    \begin{minipage}{6.35cm}
      \RedLabel{上位机与运动学}\par
      \vspace{0.20cm}
      \Body{桌面控制界面、三维仿真、正逆运动学求解、路径规划与碰撞检查。}
      \vspace{0.75cm}\par
      \RedLabel{机械设计资料}\par
      \vspace{0.20cm}
      \Body{仓库内已上传的机械模型、STL 打印文件、装配说明与结构分析资料。}
    \end{minipage}}
  \CasePlace{8.65cm}{3.25cm}{%
    \begin{minipage}{6.35cm}
      \RedLabel{嵌入式固件}\par
      \vspace{0.20cm}
      \Body{ESP32-S3 固件、PCA9685 舵机驱动、通信协议、轨迹执行与接线配置。}
      \vspace{0.75cm}\par
      \RedLabel{开发与展示文档}\par
      \vspace{0.20cm}
      \Body{开发记录、标定与调试说明、性能优化记录，以及项目展示幻灯片。}
    \end{minipage}}
\end{caseframe}

\end{document}
