77-GGG/CyberArm/slides/硬赛/机械臂开源参考项目整理.md

# 机械臂开源参考项目整理

> 检索日期：2026-08-13
> 用途：为硬件设计大赛机械臂机械结构设计提供参考

## 一、立创开源硬件平台（OSHWHub）

| 项目 | 结构 / 执行器 | 主控 | 亮点 | 链接 |
|---|---|---|---|---|
| VR体感机械臂 | 3D 打印三轴 + 夹爪（MG996R + MG90S） | ESP32 | VR 手柄体感控制、逆运动学、串口舵机控制；舵机方案入门首选 | https://oshwhub.com/tamakokirto/vr-somatosensory-robotic-arm |
| 3D打印机械臂 | 铝型材 + 3D 打印件 + 同步带 + 步进电机，6 轴，末端负载约 2.4 kg | ESP32-S3 | 手机示教、Blockly 图形化编程、联网监控；大负载参考 | https://oshwhub.com/qinzr/robot |
| ESP32 32路舵机机器人驱动板 | 最多 32 路 PWM 舵机，5–12V | ESP32 | 电压监测、MPU6050、彩屏、按键；适合做机械臂舵机驱动板底板 | https://oshwhub.com/allen-liu/esp32-ji-xie-xie32-lu-duo-ji-qu-dong-ban |
| 四足履带机器人 | 总线舵机 + 直流电机 | ESP32-WROVER-E | 四足、履带与机械臂融合；参考 ESP32 多执行器协同控制 | https://oshwhub.com/imumu/si-zu-lv-dai-ji-qi-ren |
| BROBOT 步进电机平衡车（驭风版） | 平衡车 + MG90S 手臂舵机 | ESP32 | 摔倒后靠舵机手臂辅助起身；与"自平衡车体 + 机械臂"高度相关 | https://oshwhub.com/satun/yu-feng-PICOping-heng-ju-C3U_Min |

## 二、GitHub

| 项目 | 结构 / 执行器 | 主控 | 亮点 | 链接 |
|---|---|---|---|---|
| Master Robotic Arm using ESP32 | 3D 打印，舵机 | ESP32 | 提供 Fusion 360/3D 打印文件 + 运动学示例，最适合学习和改结构 | https://github.com/noshluk2/13-Master-Robotic-Arm-using-ESP32-with-Kinematics-from-scratch-main |
| RoArm-M2（Waveshare） | 4 DOF（3+1），高扭矩串行总线舵机，碳纤维/铝合金 + 部分 3D 打印 | ESP32 | 开源固件、Python/Web 控制、方案成熟，可买套件拆解参考 | https://github.com/waveshareteam/roarm_m2 |
| RoArm ROS2 Workspace | 配合 RoArm 使用 | ESP32 | ROS 2 + MoveIt 2、逆运动学、pick-and-place 示例 | https://github.com/waveshareteam/roarm_ws |
| AM-ARM200 | 全 3D 打印 6+1 DOF，Feetech 串行总线舵机 | 兼容 LeRobot | 开源低成本双臂/单臂方案，结构件文件齐全 | https://github.com/liyiteng/AM-ARM |

## 三、与咱们项目相关的选型建议

咱们项目背景：ESP32-S3 双轮自平衡机器人（FOC 无刷轮、IMU、摄像头、2S 锂电池）。

1. **最贴近的参考**：BROBOT 驭风版（自平衡车体 + 舵机手臂）——机械臂装在自平衡车体上时，重心抬高会直接影响平衡控制，值得先看它怎么做重量和重心分配。
2. **舵机 vs 步进电机**：
   - 桌面级轻负载（夹取小物件、演示动作）：MG996R/MG90S 舵机 + 3D 打印最省事，参考 VR体感机械臂 / noshluk2；
   - 较大负载/精度：同步带 + 步进电机 + 编码器，参考立创 3D打印机械臂。
3. **电源注意**：舵机需要独立供电（5–6V），不能从 ESP32 的 3.3V/5V 引脚直接取电；若沿用 2S 锂电池，需要单独做降压或 DC-DC 电源树。
4. **控制板**：如果做多自由度，可参考 32 路舵机驱动板的设计，或直接用 PCA9685 扩展 PWM 通道。

## 四、可以继续深挖的方向

- 在 OSHWHub 用关键词 `3D打印机械臂`、`桌面机械臂`、`MG996R`、`SCARA` 继续检索
- 在 GitHub 搜 `robot arm 3d print`、`servo arm ESP32`、`SCARA ESP32`、`6DOF arm` 等
- 考虑关节形式：垂直关节（类似人手臂）、SCARA（平面拾取）、并联 Delta（高速轻载）
