77-GGG/CyberArm/mechanical/arduino_reference_revC/connections.html

CYBERARM · REV C · 2026 / 09 / 07

# 让舵盘真正连接 机械臂零件

六处传动接口，十二套 M2 螺栓、垫片与螺母。中心原厂短螺丝负责锁住舵盘，周边两颗螺栓负责夹紧打印件。

保留参考外形与无 Logo 表面；实际通孔、沉孔和背面避让均已修改到打印网格中。

Blender 装配文件完整装配说明先打印试装片整件 STL

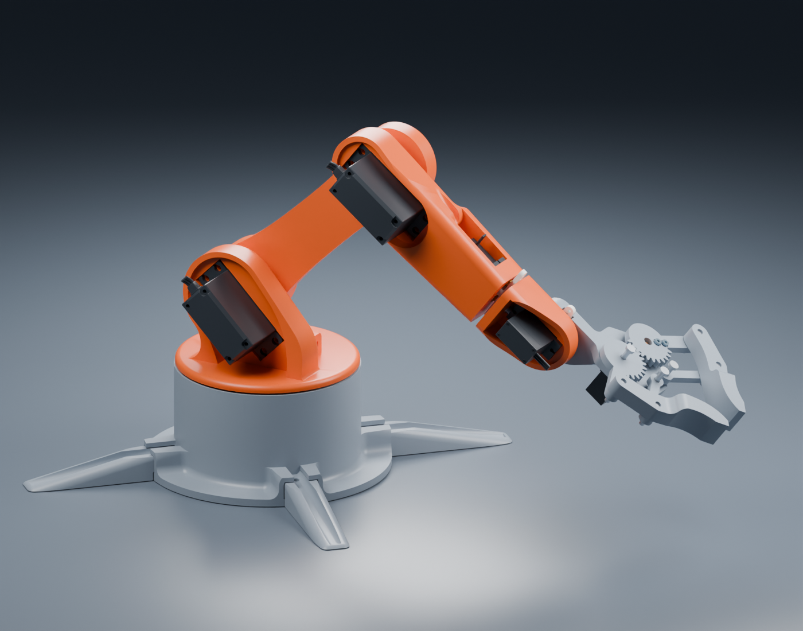
[picture p1: mechanical/arduino_reference_revC/RevC_assembly.png]
RevC 机械臂装配渲染


先试装，不直接整臂投产。本版是下载 CAD 尺寸基础上的接口试装版。必须将原厂舵盘选中的两孔离机扩至 Ø2.2；打印件孔为 Ø2.4。MG90S 橙色中心螺丝只是包络占位，不能据此采购 M2×5 替代原厂螺丝。

螺栓头 → 垫片 → 打印件 → 原厂舵盘 → 螺母
另一条独立连接：原厂中心短螺丝 → 舵盘中心 → 舵机输出轴螺纹

## 六处连接 · 尺寸对照

位置 | 舵盘 / 选孔 | 连接零件 | 每处螺栓 | 外侧沉孔 | 中心检修孔
S01 底座 | MG996R 圆盘 · 14 孔距 | Waist | 2 × M2×10 | 无 | Ø7.7
S02 肩 | MG996R 圆盘 · 14 孔距 | Arm_01 肩端 | 2 × M2×10 | Ø4.8 × 深 1 | Ø7.7
S03 肘 | MG996R 圆盘 · 14 孔距 | Arm_01 肘端 | 2 × M2×10 | Ø4.8 × 深 1 | Ø7.7
S04 腕旋转 | MG90S 双臂 · 12 孔距 | Arm_03 | 2 × M2×10 | 无 | Ø5.2
S05 腕俯仰 | MG90S 十字长臂 · 12 孔距 | Gripper_base | 2 × M2×10 | 无 | Ø5.2
S06 夹爪 | MG90S 单臂 · 轴心半径 6、11 | gear2 | 2 × M2×8 | Ø4.8 × 深 1 | Ø5.0

单位 mm。全部传动通孔 Ø2.4；每处两片 ID2.2 / OD4.5 / 厚0.3 小垫片和两颗对边4 / 厚1.6 的 M2 螺母。沉孔为局部让位，不是全埋头。

## 展开图如何阅读

顶部中心短螺丝原厂中心锁紧件。穿过大检修孔，只压住舵盘。MG90S 橙色表示尺寸待实物确认。

两侧长螺栓 + 银色垫片由打印件外侧穿入。下方金色六角件表示螺母，颜色不是采购材质要求。

打印件局部 + 白色舵盘图中打印件截取了实际接口便于看孔，并非新增圆形整臂零件。虚线仅表示同轴装配关系。

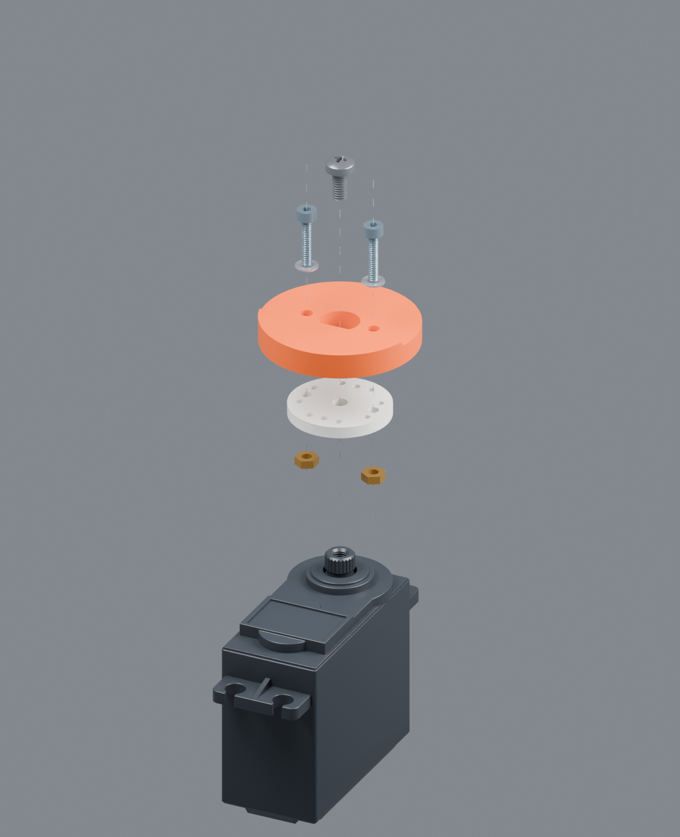
[picture p2: mechanical/arduino_reference_revC/Connection_S01_exploded.png]
S01 底座回转舵盘连接展开图


S01 · BASE YAW

### MG996R 圆盘 → Waist

2 × M2×10；14 孔距；Ø7.7 中心通道。增加 0.5 高一体承压垫台。

标称螺栓尾端超出螺母 1.3。

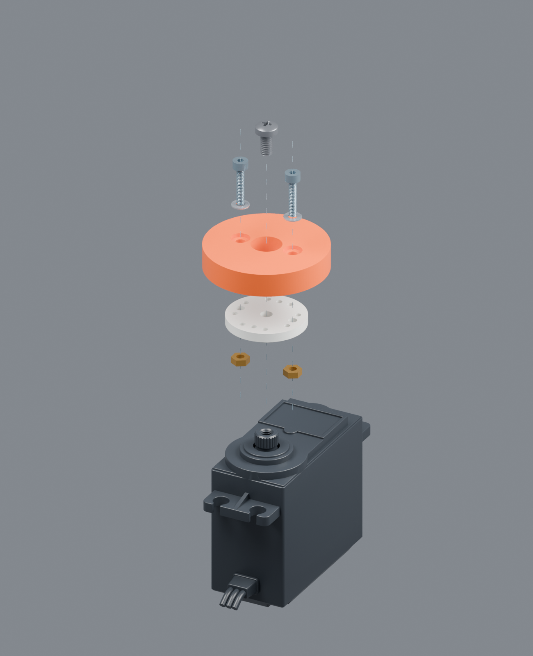
[picture p3: mechanical/arduino_reference_revC/Connection_S02_exploded.png]
S02 肩关节舵盘连接展开图


S02 · SHOULDER

### MG996R 圆盘 → Arm_01 肩端

2 × M2×10；14 孔距；Ø4.8 × 深1 沉孔。增加 0.2 高一体承压垫台。

标称螺栓尾端超出螺母 0.6。

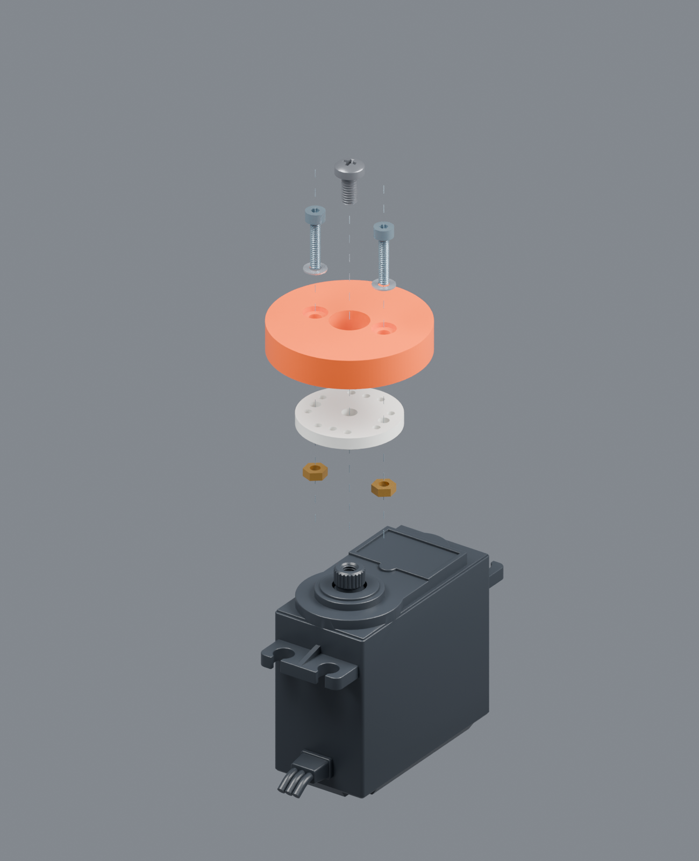
[picture p4: mechanical/arduino_reference_revC/Connection_S03_exploded.png]
S03 肘关节舵盘连接展开图


S03 · ELBOW

### MG996R 圆盘 → Arm_01 肘端

与肩端相同的螺栓、孔距和沉孔规格，接口位于同一大臂的另一端。

中心 M3×6 来自提供的 CAD，实物仍使用原厂件确认。

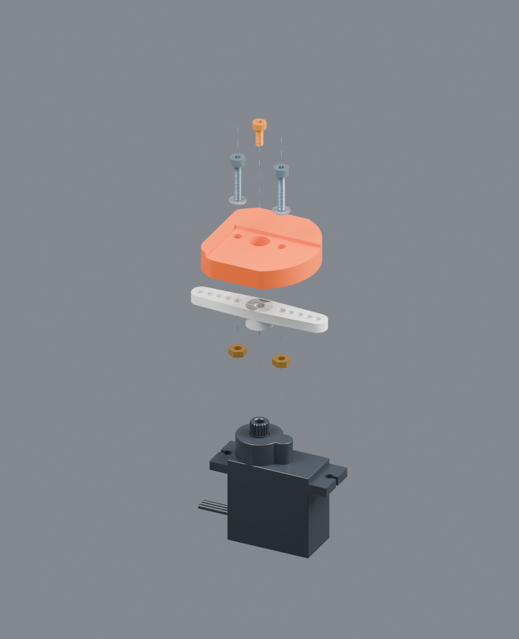
[picture p5: mechanical/arduino_reference_revC/Connection_S04_exploded.png]
S04 腕旋转双臂舵盘展开图


S04 · WRIST ROLL

### MG90S 双臂 → Arm_03

2 × M2×10；两侧半径6的小孔扩至 Ø2.2。邻接固定支架中心开口扩大至 Ø17.4。

MG90S 中心螺丝是待确认包络，继续用实物原厂短螺丝。

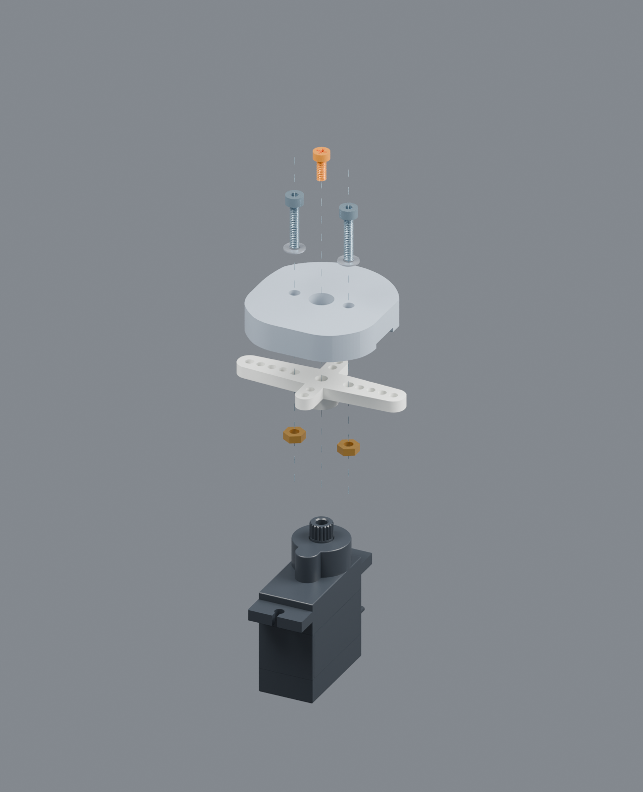
[picture p6: mechanical/arduino_reference_revC/Connection_S05_exploded.png]
S05 腕俯仰十字舵盘展开图


S05 · WRIST PITCH

### MG90S 十字 → Gripper_base

改用十字长臂上的 12 孔距两孔。短臂保留，但不使用旧版 10.2 孔距连接。

短臂孔过近，螺母会碰中心凸台；长臂位置也必须先离机试装。

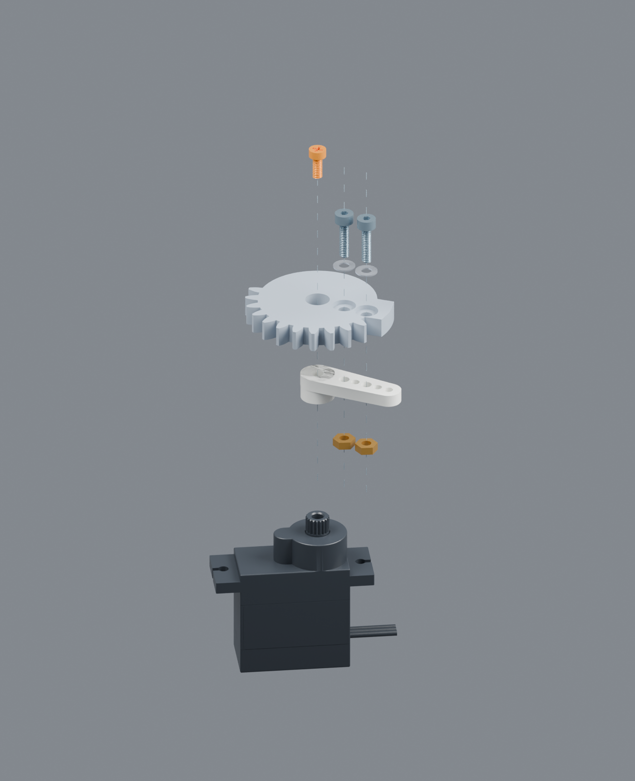
[picture p7: mechanical/arduino_reference_revC/Connection_S06_exploded.png]
S06 夹爪单臂舵盘与驱动齿轮展开图


S06 · GRIPPER DRIVE

### MG90S 单臂 → gear2

2 × M2×8；同侧轴心半径6和11。固定夹爪座已做局部弧形螺母/尾端避让。

夹爪预览 ±8°，不是已认证的实物安全行程。

## 先做这四件事

1. 按对应编号打印试装片，100% 尺寸，使用与实际耗材一致的材料预设。
2. 比对实物舵盘孔距、厚度、花键与中心短螺丝，匹配后才离机扩两个小孔。
3. 在舵盘离开舵机时，预装打印件、两套 M2 螺栓/垫片/螺母。
4. 套入已回中的舵机花键，再从大检修孔装原厂中心短螺丝；检查尾端、螺母、壳体间隙。

螺母与中心凸台的 CAD 保守余量约 0.21–0.29，空间很紧。不要用中心螺丝硬拉花键，不要凭模型拧到底。试装片只验证接口，不验证整臂强度。

已检查：12 个整件 + 6 个试装片 STL 封闭性；6 处接口通孔/沉孔；新增传动五金静态相交与 236 个局部旋转姿态。

尚未完成：实物尺寸与螺纹确认、全范围整机碰撞、负载/疲劳测试、整机轴承与全部五金定型。当前不新增外置轴承。请先阅读 完整装配说明与限制。
