77-GGG/CyberArm/docs/技术决策与问题记录.md

# CyberArm 技术决策与问题记录

更新：2026-09-14｜关联设计版本：2.0。

当前阶段调整：用户要求先不处理视觉，仅完成整个上位机模拟软件架构和实施计划，过目后再开始。已形成 [架构与实施计划 1.0 审阅稿](上位机模拟软件架构与实施计划.md)。方案审阅未结束，本轮不进入 P0、不安装新依赖、不编写应用或修改模型；此范围约定覆盖此前包含视觉的近期实施描述，长期扩展仍保留。

“决策已确认”表示路线选择已解决，不表示代码或机械测试完成；“已验证”必须附测试记录。后续追加日期、处理结果与证据，不把待测项目写成已完成。

## 已解决的路线决策

| ID | 问题 | 当前处理 | 依据/影响 |
|---|---|---|---|
| D01 | 结构与舵机 | RevC、MG996R×3 + MG90S×3，五关节加夹爪 | 用户确认，主/视觉文档覆盖旧配置 |
| D02 | 任意末端姿态 | 接受五轴限制，显示条件范围并校验路径 | 用户确认，不补虚拟轴绕过限制 |
| D03 | 制作顺序 | 上位机及模拟控制器验证后进入打印准备 | 用户确认，实物误差以后测量 |
| D04 | 模型修改 | 可为运动学、干涉、支承、布线和视觉安装修改 | 用户授权，改几何建立新版本并重新验证 |
| D05 | 上位机主线 | Three.js + Python 服务，RoboDK 可选 | 采用上一轮建议作为当前工程基线，尚未实现 |
| D06 | DummyStudio 复用 | 已取得的是发布包，不作为源码底座 | 作者 README/软件目录核验 |
| D07 | 丰富操作方式 | MotionIntent 统一入口，规划检查与 MCU 租约 | 本轮设计，预留脚本/手柄/示教器/视觉/手势等 |
| D08 | 固件起点 | PlatformIO/Arduino，模拟核心、通信、SEQ 和停止 | 本轮方案，不要求用户自行写固件 |
| D09 | IK 分工 | 首期 PC 规划、MCU 基础约束和轨迹，脱机以后移植 | 统一总设计与视觉设计，避免职责冲突 |
| D10 | 反馈显示 | 分开目标角/指令角，实测角为空 | 现有链路无角度回读，ACK 不等于实物到位 |
| D11 | 视觉安装 | 默认外置固定相机，预留腕上版本 | 工程默认，可在模型阶段调整，减轻腕部负荷 |
| D12 | 旧文档 | 覆盖主设计、视觉设计和主 PDF，新增固件及本台账 | 用户要求；首次核验保留为注明状态的历史 |

## 当前证据和完成状态

| 项目 | 状态 | 证据 |
|---|---|---|
| RevC 关节/夹爪层级 | 已存在，仍需新系统对照 | Blender、revB_motion.py、装配说明 |
| 单姿态 FK 对照 | 历史记录通过 | audit_20260907/kinematic_crosscheck.json，非本轮重跑 |
| PWM 与实机同步 | 软件已实现，待实物验证 | lib/PCA9685Servo、lib/CyberArmFirmware、上位机 USB CDC 桥接及逐轴校准 |
| 主固件 | 软件已实现，实物待验证 | src/main.cpp、lib/CyberArmFirmware；PlatformIO 编译通过，尚未烧录设备 |
| 上位机、SDK、命令控制台、实机桥接 | 软件已实现，实物待验证 | simulator、desktop、lib/CyberArmFirmware；[控制台与通信接口](控制台与通信接口_20260915.md)、[实机同步控制](实机同步控制_20260916.md) |
| 设计同步、固件思路、问题台账 | 本轮文档完成 | 本目录总设计/视觉 2.0，固件方案 |
| RevC GLB、空间计算、碰撞测试 | 仿真版已实现，实物验证未执行 | simulator/assets/revc、simulator/tests；模型与实物误差仍需后续验证 |
| 打印、整机标定、负载与视觉 | 未执行 | 用户尚未打印 |
| 规划内核预览性能 | 本轮实测并优化，余量再压缩 | [上位机预览性能优化_20260914.md](上位机预览性能优化_20260914.md)；pytest 6 项通过、接受段密集复测零漏检；scipy 惰性导入后首次预览 784→248 ms（网页）/ 792 至 986 ms（桌面） |

## 待解决和待验证问题

| ID | 问题 | 处理办法 | 关闭条件/阶段 |
|---|---|---|---|
| T01 | 轴心、零位、TCP 尚未统一成参数 | 从总装导出，建立方向样本，独立定义 TCP | 多个单轴/组合姿态与 Blender 一致，S0 |
| T02 | 五轴姿态约束尚未计算 | 位置优先/带约束 IK、雅可比秩和奇异区分析 | 可行/无解/求解失败与残差报告，S1 |
| T03 | 边界并非固定空间盒 | 条件空间、扫掠检查、制动余量和禁入区 | 终点合法但路径非法等反例拒绝，S1/S2 |
| T04 | 夹爪闭链不能只导出动画 | 移植连续分支求解，检查奇异点/干涉 | 开度区间对照与碰撞记录，S0/S1 |
| T05 | 负载、支承、倾覆未定版 | 按新几何核算，优先固定/支承与必要减重 | S3 设计筛查、S4 实物记录分别完成 |
| T06 | 模型无碰撞不代表实物无碰撞 | 测回差、装配误差、挠度，收缩范围 | 误差包络/实物限位，S4/S5 |
| T07 | 断电后姿态未知，回中会突动 | 默认失能，工装/人工参考与逐轴标定 | 启动/复位实物测试，S4 |
| T08 | OE 非刹车，无位置/电流/温度反馈 | 停止流程、供电/支承，按需加传感器 | 原理图及停止测试，S3/S4 |
| T09 | 实际 ESP 板型、USB 口与引脚不明 | 板卡阶段读取型号/照片/原理图，固化映射 | USB、电平、波形测试，硬件接入前 |
| T10 | 控制源抢占和重连重放 | 租约、boot_id、去重、STOP 独立通道 | 切换、超时、重启故障注入，S2 |
| T11 | 跨板时钟不能直接比较 | 偏差/误差界、boot_id、观测关联 | 偏差/重启/延迟用例正确拒绝，视觉接入前 |
| T12 | PWM 量化与舵机迟滞影响平滑 | 模拟扰动，实测脉宽/响应，调整限制 | 假设与实测分开记录，S2/S4 |
| T13 | 改模型/场景导致旧动作失效 | 版本绑定，取消旧预览/队列并重验 | 工具/模型/场景变更测试，S1/S2 |
| T14 | 视觉安装尺寸与标定未定 | 暂用可调外置支架，定义坐标和视锥 | 软件视野覆盖、实物标定分别完成 |
| T15 | RoboDK 五轴适配未确认 | 主线后独立实验，不阻塞自研软件 | FK/IK/Driver 适配记录 |

这些问题当前不要求用户立即决定。板型/接线和实物参数到对应阶段再收集，软件可先用明确标识的模拟配置推进。

## 本轮变更与后续记录方式

2026-09-14：覆盖总设计与视觉设计；增加条件可达、整条路径/制动边界、统一控制入口及先仿真后打印流程；补充固件模块、命令语义、无反馈显示、启动未知姿态、视觉时钟和租约；新增固件方案与本文件。未改动模型几何、STL、控制代码，未烧录设备。

2026-09-14（性能）：按用户反馈定位并修复规划内核的两处慢点——路径检查的保守 pad（夹爪方向被放大 15 倍，导致窄相碰撞查询按大 ceiling 计费）与 IK 的解析雅可比取错关节轴；新增热启动通道和夹爪逐网格实测扫掠半径，检查改为先分段。判据未放松，接受段密集复测零漏检，记录见 [上位机预览性能优化_20260914.md](上位机预览性能优化_20260914.md)。未改动模型几何、限位、速度上限、前端与 C++ 核心。

2026-09-14（性能落地到两端）：确认算法只有 planner.py 一份，网页端开发态经 HTTP 直接调用因而自动生效，前端 dist 因源码未变无需重建（三处 index.html 与 JS 的 SHA-256 一致）。Electron 端重新冻结后端并把新 cyberarm-backend.exe（当时 SHA-256 A5B8323E…B2A0，后于 2026-09-15 再次冻结为 2856759D…FB77）同步到 desktop/build/frozen、desktop/stage/backend 与 desktop/dist/win-unpacked/resources/runtime/backend。新增启动期预热：每个规划进程的首次任务要付约 1 秒的 import 与碰撞数据解压，现改为 lifespan 内向池里投两个 warm_worker 任务。可达采样向量化后 95.6 ms 降到 33.4 ms，点数与坐标不变。细节见 [上位机预览性能优化_20260914.md](上位机预览性能优化_20260914.md) 第 13 节。

2026-09-15（首次预览的余量）：把那份一次性成本拆开，发现 planner 在模块级 import scipy.optimize，单这一项就要 653 至 677 ms（整份 import planner 为 641 ms，两者量级相同即该项是主因），而它只在冷种子分支（远离工作空间的目标）才用得到。改为 planner.least_squares_solver() 函数内惰性导入后，导入 planner 降到 127 ms：网页端窗口刚显示就点预览从 784 ms 降到 248 至 446 ms，稳态 61 至 128 ms。warm_worker() 另把求解器加载放到后台线程，让它在窗口打开期间完成；打包脚本显式声明 --hidden-import scipy.optimize，避免函数内导入被字节码扫描漏掉。plan_job 的预览 15 点也改为批量正运动学（与旧循环最大差 5.551e-14 mm）。冻结产物重建并同步三处，新 cyberarm-backend.exe SHA-256 2856759D…FB77，桌面版首次预览 792 至 986 ms、随后 49 至 82 ms。未改动碰撞判据、限位、速度上限、模型几何、前端与 C++ 核心；细节见 [上位机预览性能优化_20260914.md](上位机预览性能优化_20260914.md) 第 13 节。

后续关闭问题记录：问题 ID、模型/固件版本、输入、预期/实际结果、原始日志路径和残余限制。设计决策已写入不等于关闭相关 T 项。

2026-09-15（控制台）：增加 19 个统一命令、桌面控制台、CLI 与 SDK 传输接口。命令复用仿真限位、碰撞、规划和执行校验；补充规划归属、客户端释放、规划中退出取消及带规划 ID 的执行结果，区分完成/暂停/停止。当前 HTTP request_id 仅关联响应，硬件 boot_id、去重、串口、标定和真实反馈尚未实现，T09/T10 等硬件问题继续保留。详见 [控制台与通信接口](控制台与通信接口_20260915.md)。

2026-09-16（实机同步软件）：增加 USB CDC JSONL v1、pyserial 后端桥接、8 个 `hw*` 命令、六路校准和单轴中位界面；ESP32-S3 固件接入 PCA9685，缓存规划段并以 20 ms 五次曲线插补，支持同步启动、暂停/停止和 1.5 秒心跳看门狗。连接默认失能，六路未校准不允许整臂使能。PlatformIO、Python、C++、前端和 Windows 打包测试通过；T07/T08/T09 仍需实体板卡和逐轴负载验证，T10 的会话去重仍未实现。详见 [实机同步控制](实机同步控制_20260916.md)。

2026-09-17（界面重构与实机调试工作台，0.7.0）：删除与手动控制重叠的示教模式，模式收敛为“手动控制 / 自动运行”，姿态记录留在手动模式；顶栏改为“项目 / 模式 / 工作区 / 调试 / 设置 / 帮助”单层菜单，原第二横栏功能全部归入菜单。新增“调试 → 实机调试”五步工作台（连接与安全、回中与限位、运动测试、通信、视觉）和“调试 → 运动学诊断”。命令控制台保持可拖动、可拉伸的浮动小窗，960×720 下与机械臂视图同时可用。180° 三线 PWM 舵机没有位置回读，界面把“指令角”与“实测角”分列，“回中”定义为输出已标定的中位脉宽；该限制与逐轴标定流程写入 [上位机界面与实机调试手册](上位机界面与实机调试_20260917.md)。前端生产构建、C++ CTest、开发版与打包版各 8 项桌面测试通过；实体板卡、舵机负载与角度精度仍需按 [软硬件联调计划](软硬件联调计划_20260916.md) 实测，T07/T08/T09 未关闭。

2026-09-17（固件使能斜坡，0.2.0）：`arm` 原先把目标姿态一次性写进六路 PWM，实体从“无输出”状态被直接拉到目标脉宽。现改为在上一次指令姿态接通输出，再用 600 ms 五次曲线斜坡走到目标（FirmwareConfig.h 的 `kArmRampMs`）。上位机 `hwarm` 发送的是当前仿真姿态，因此正常流程下起点与终点相同、不产生运动，只有仿真在失能期间被移动或重置时才真正走这段斜坡。同时修掉手动与斜坡插值中 `now - manualStartedMs_` 的无符号回绕：某次控制周期被 I2C 或串口拖到 20 ms 以上时该差值会变成极大值，导致当拍先跳到目标再跳回起点，对舵机是一次瞬时冲击。协议、命令集与主机侧均未改动，Python 桥接测试与假串口用例无需修改；固件版本升到 0.2.0，界面“通信”页可直接确认烧录版本。PlatformIO 编译通过，RAM 37,880 B、Flash 307,593 B。斜坡的实际时长与起止速度仍需在台架用空载舵机确认。

2026-09-17（单轴标定工作台与 JSON 接线，0.8.0）：固件升到 0.3.0，增加独立单轴调试租约（1200 ms 未续约即关闭该通道，普通后台心跳不能续期）、未标定轴可测、3～7 点单调角度映射、ARMING 过渡与其他命令互斥，以及执行真实 C++ 的主机测试。旧 `hwcal/hwcenter` 明确拒绝，原 min/center/max 不再被冒充为实测角度。上位机把“回中与限位”改为四步工作台，支持单路计数点动、人工读数记录、草稿与导出、保存后读回核对；标定按设备、模型和接线摘要绑定，电脑备份与设备不一致时以设备为准。接线配置集中到 [config/wiring.json](../config/wiring.json)，PlatformIO 编译前校验并生成 WiringConfig.h，非法或重复通道直接终止编译，固件在状态中回报实际接线与摘要。整机规划与固件检查改用模型范围、实机工作范围与映射覆盖范围的交集，缩小工作限位不缩放角度比例，robot.json 不被改写。已验证：PlatformIO 编译（RAM 38,688 B、Flash 316,817 B）、前端生产构建、Python 40 项（含真实 C++ 编译执行）、Electron 单轴与手动界面流程。未烧录实体板卡、未做负载与角度精度实测，T07/T08/T09 仍未关闭。
2026-09-17（0.8.0 发布）：提交 effc5c0 推送 `main` 并创建标签 `v0.8.0` 后，Windows Release 工作流在 4 分 30 秒内完成安装包构建、更新器测试、打包版冒烟测试和资产上传，Release “CyberArm Studio 0.8.0” 可下载安装器、blockmap 与 `latest.yml`。本次未做交互式跨版本升级验收，也未在实体板卡上验证固件。
2026-09-18（五步标定流程与可调模型软限位，0.9.0）：把“回中与限位”从单页堆叠改成“准备输出 → 确定零位 → 采集角度 → 限位与保存 → 验证角度”五步。每步只显示当前任务：未记录零位不能进入采样，采样缺零位或异号点、工作限位超出实测覆盖、未关闭输出、未勾选人工实测确认都会给出原因并阻止下一步。验证记录绑定实际发送过的目标角与设备标定版本，改目标、暂停或关闭输出后必须重新试转，旧版本记录只留在详情里。“用设备值替换草稿”显式覆盖草稿并提示先导出，切轴和换设备会恢复对应草稿。

模型软限位由编译常量改为设备参数。固件 0.4.0 把每轴一个 `JointLimits` blob 存入 NVS，绑定模型与接线摘要，`save_limits` 在失能且输出关闭时写入并读回核对；新增 `capabilities.editable_limits`、`model_limits_deg`、`limits_revisions`，`arm`/`target`/`prepare`/`segment` 与状态回报都改用设备值，[FirmwareConfig.h](../lib/CyberArmFirmware/src/FirmwareConfig.h) 的 ±30°/±8° 降级为未配置时的默认值。上位机在工作台底部提供逐轴编辑，保存前校验 −180° ≤ 下限 < 0° < 上限 ≤ 180°、版本一致和当前仿真姿态落在新范围内；夹爪额外检查连杆闭环在整段区间都有解，因此 G 可以保存 ±15° 但拒绝 ±90°。连接期间仿真、逆解、规划、控制台和关节滑条统一使用设备回报的模型范围，缩放后的实测工作范围仍照旧取交集，未使能时也使用设备值，断开后回到打包默认值。

“确定零位”新增只读三维参考：显示模型全零姿态与本轴 +5° 姿态，并用不遮挡的正向箭头标出旋转轴，除 J4 外各轴局部 Z 轴近似基座 +Z 或 +Y。它只做运动学计算，不改变仿真姿态、不发串口命令，测试断言两次查看前后 `q_deg` 与输出状态不变。零位含义、工作限位与模型软限位的区别、找到行程边界的操作顺序写入 [单轴调试操作手册](单轴调试操作手册_20260918.md)。

已验证：PlatformIO 编译（RAM 39,048 B、Flash 318,701 B）、Windows 安装器构建与打包版冒烟测试、前端生产构建、Python 42 项（含真实 C++ 执行的主机固件测试与 `save_limits` 重启恢复）、Electron 单轴与手动界面流程（开发版与打包版）。未烧录实体板卡，PWM 波形、通道映射、负载、回差与角度精度仍未实测；模型软限位扩大后必须按实际机械结构重新确认，不能视为已验证行程。
2026-09-18（0.9.0 发布）：提交 3435390 推送 `main` 并创建标签 `v0.9.0` 后，Windows Release 工作流完成安装包构建、更新器测试、打包版冒烟测试与资产上传，Release “CyberArm Studio 0.9.0” 含 `CyberArm-Studio-Setup-0.9.0-x64.exe`（184,716,359 B）、对应 `.blockmap` 与 `latest.yml`。本地 `desktop/dist/win-unpacked` 同步重建为 0.9.0。本次仍未做交互式跨版本升级验收；界面修改软限位需要先烧录固件 0.4.0。

2026-09-18（调试中断开与心跳加固，上位机）：单轴调试期间出现过几次“ESP32-S3 失联”，与 USB 事件日志中的 `abortGated`、后端 `系统时钟停顿` 同刻。放宽主机侧容错：连续一次心跳超时不再立刻断开，改为重试一次；单轴调试租约存在时把后台心跳从 400 ms 降到 1000 ms，避免与 300 ms 的续约会话争抢串口；标定草稿与备份的读写（含 `fsync`）移出事件循环线程；`heartbeat` 与 `test_renew` 改用精简运行状态回包（实测 2179 B → 278 B），完整设备配置仍在握手与参数变更响应中回报。固件的 1.2 秒调试租约与 1.5 秒运动看门狗未放宽。

2026-09-18（保存标定必定超时，固件 0.4.2）：现象是在单轴工作台点击“确认保存到 ESP32 并读回”后上位机报 `save_mapping 响应超时` 并断开，而模型软限位可以正常保存。定位过程：主机用真实固件代码加 ASan/UBSan 复现同一请求，逻辑完全正常，说明问题在 ESP32 侧；变长请求实测在 243 B 与 283 B 之间出现分界，正好是 HWCDC 接收队列的默认 256 B。`CommandProtocol` 的输入行缓冲是 2048 B，但 USB CDC 的接收队列只有 256 B，中断在队列满时直接丢弃剩余字节：`save_mapping` 请求约 320 B，尾部的 `]}` 与换行被丢掉，行既不完整也不结束，`deserializeJson` 失败后固件按设计静默返回，半截数据还留在行缓冲里把后续命令一起带坏，因此表现为“掉线”而不是“报错”。`save_limits` 约 200 B，所以一直正常。修复：固件 0.4.2 在 `Serial.begin()` 之前调用 `Serial.setRxBufferSize(4096)`，把队列提到协议上限之上；命令集、协议版本与限位/标定格式均未改动。已验证：PlatformIO 编译（RAM 39,048 B、Flash 318,925 B）、Python 43 项，其中主机固件测试新增把 `save_mapping` 真正发给 `CommandProtocol` 的用例，覆盖此前完全没人走过的嵌套数组解析路径；实机 0.4.2 上 363/526/963/1564 B 请求均在 11 ms 内回包，J1 标定以 46 ms 保存成功（revision 0 → 1），经 esptool 硬复位后六个点的映射与 `model_limits_deg` 仍完整读回。其他轴、负载、回差与角度精度仍未实测。

2026-09-18（0.9.0 macOS 发布）：提交 d44bf85 把心跳容错、固件 0.4.2 接收队列修复与当日文档合并推送到 `main`，本地与远程 `main` 同步到同一提交（此前本地 `main` 落后三个提交，已快进）。桌面工程随后用本机 Apple Development 证书构建 macOS arm64 产物并上传 Release “CyberArm Studio 0.9.0”：`CyberArm-Studio-0.9.0-arm64.dmg`（200,407,579 B）、`CyberArm-Studio-0.9.0-arm64.zip`（200,846,668 B）、zip 的 blockmap 与 `latest-mac.yml`。已挂载 DMG 做启动冒烟测试：窗口打开、内置后端就绪并返回 `/api/state` 的 READY 状态，`codesign --verify --deep --strict` 通过，退出后无残留进程。该包未做 Developer ID 签名与公证，公开分发时 Gatekeeper 仍要求用户确认，未签名状态下的 macOS 自动更新也不保证无人值守；本次未做 macOS 交互式跨版本升级验收。发布说明已补 macOS 产物、SHA-256 与 Gatekeeper 处理方式。
