77-GGG/CyberArm/docs/末端实时试摆_20260915.md

# 末端实时试摆 0.2.0

## 备份与分支

- 旧版上位机源码提交：`c9d2371`，已推送到 `origin/release/windows-packaging`。
- 旧版备份标签：`backup/pre-live-tcp-20260915`，已推送。
- 新版开发分支：`feature/live-tcp-reachability`。
- 旧程序保留在 `desktop/dist/win-unpacked/CyberArm Studio.exe`。
- 新程序输出到 `desktop/dist/live-tcp/win-unpacked/CyberArm Studio.exe`。
- 工作区内机械设计、第三方工具及编辑器配置不属于本次软件备份和修改范围。

需要恢复旧软件源码时，可以从备份标签创建独立工作树；不要直接重置当前含机械设计改动的工作区：

```powershell
git worktree add ../CyberArm-before-live-tcp backup/pre-live-tcp-20260915
```

## 操作

默认打开“末端”页。拖动工具中心点处的 X/Y/Z 箭头或平面手柄，机械臂模型在拖动过程中根据逆运动学连续调整。也可输入毫米坐标。

默认只约束位置；勾选“约束工具 Z 轴方向”后，额外约束工具指向。模型只有五个运动关节，夹爪开合是独立机构，不能保证任意完整六维位姿。关节页仍可编辑五个关节和夹爪。

- 找到满足位置、方向、限位和姿态间隙要求的解：更新试摆模型与 J1–J5 数值。
- 无解、超时或候选姿态存在干涉：保持最后有效试摆姿态，目标坐标仍保留用户输入；显示目标偏差和原因。
- 解算期间：显示“求解中”，不把上一目标的成功状态用于新目标。
- 靠近限位：显示对应关节提示。
- “取当前值”：回到执行状态的 TCP 和关节，并清除旧试摆种子。
- “预览路径”：从执行状态规划到选定目标；此时实体模型表示起点，半透明模型表示终点。
- “执行”：仅执行已验证且仍有效的计划。

普通末端目标保存选定的关节解，路径规划重新校验其正运动学、限位和整条路径，避免规划器悄悄切换为另一种终点姿态。MoveL 仍沿直线重新求解中间姿态，因此其终点关节解可能与位置试摆不同，需查看路径预览。

## 实现与约束

`POST /api/reachability` 是只读试摆接口，不修改控制器关节、执行状态或动作计划。复用原有 FK、IK 和模型碰撞检查，服务器限制同一时刻最多一个试摆任务。请求携带执行序号和场景版本，变化后拒绝过期结果。

前端使用一个在途请求和一个可替换的待处理目标。连续拖动时可以展示同一场景内稍早目标的有效姿态以保持跟随，但只有与最新目标完全一致的响应可以将该目标标记为可达。松手后丢弃未完成的旧拖动反馈，进行更充分的求解。

拖动求解预算为 35 ms，松手为 250 ms；这是 IK 计算预算，不包括排队、首次模型加载和碰撞检查。繁忙机器可能耗尽预算，显示“未找到有效解”并保留姿态；这不构成数学上绝对不可达的证明。接近限位提示阈值为 2°，位置和方向接受阈值沿用 0.5 mm / 0.5°。

本版保留模型原有临时限位与间隙检查。未添加任意六维姿态旋转、自动换构型按钮或实机跟随。

另修复零距离 MoveL：当前位置就是目标时，生成经过检查的保持段，避免误报“动作序列为空”。

## 验证

- 前端 TypeScript 检查及 Vite 构建。
- Python：12 项测试，包含连续目标、夹爪独立性、碰撞、限位、求解预算、只读 API、过期场景、选定终点校验与零距离 MoveL。
- Electron：3 项端到端测试，包含实际鼠标拖动坐标轴并在松手前检查关节变化、无解保留、延迟响应、预览执行、导入导出、暂停停止与进程清理。
- 开发运行与打包后的 Windows EXE 均已验证。生命周期测试在重复启动前显式等待初次末端求解完成；打包版交互和功能回归通过，补充等待后的生命周期测试通过。
- C++ 核心 CTest：1 项通过。
- 旧版 EXE、app.asar、后端 EXE、前端入口四个文件在新版构建前后 SHA-256 一致；本地核对记录位于 `desktop/dist/pre-live-tcp-backup.json`。

```powershell
$env:PYTHONPATH = 'E:/CyberArm/simulator/backend'
simulator/.venv/Scripts/python.exe -m pytest simulator/tests -q
cd desktop
npm test
npm run build:tcp
$env:CYBERARM_TEST_EXECUTABLE = (Resolve-Path 'dist/live-tcp/win-unpacked/CyberArm Studio.exe').Path
npm test
```

构建与测试产物不提交 Git。运行程序必须保留完整的 `win-unpacked` 目录。
