77-GGG/CyberArm/slides/硬赛/硬件设计大赛整理.md

# 清华大学第 29 届硬件设计大赛整理

> 整理日期：2026-07-22  
> 适用范围：硬件设计大赛相关事项  
> 说明：大作业仅作为课程背景和技术参考，不作为本文主线。带“暂定”的安排应以网络学堂、课程群或选手群的后续通知为准。

## 一、现在最需要关注的事项

| 事项 | 时间 | 当前状态 | 需要完成的内容 |
|---|---|---|---|
| 比赛报名与组队 | 2026-06-28 23:59 前 | 已截止 | 每队不超过 3 人，通过微信群内腾讯文档报名 |
| 开题报告提交 | 2026-07-26 截止 | 即将截止 | 通过网络学堂提交；助教预计一周内批改反馈并线上交流 |
| 项目初审 | 暂定秋季学期开学前两周 | 待通知 | 介绍创新点、实现方案、应用场景并进行现场展示 |
| 民生赛道终审 | 暂定秋季学期第二周 | 待通知 | 线下答辩 |
| 主赛道决赛晚会与终审 | 暂定秋季学期第三周 | 待通知 | 现场汇报、实物演示、技术答辩和评委问答 |
| 课程报告 | 暂定秋季学期第四周截止 | 待通知 | 简介比赛作品，并说明个人贡献 |

## 二、比赛基本信息

- 比赛名称：清华大学第 29 届硬件设计大赛
- 主办单位：清华大学电子工程系实验教学中心
- 承办单位：清华大学电子工程系学生科学与技术协会硬件部
- 项目类型：嵌入式系统作品
- 组队人数：每队不超过 3 人
- 比赛定位：展示创意与技术，考察工程实现、动手实践、团队协作和跨学科综合能力

### 与课程和大作业的关系

本赛事与《电子系统专题设计与制作》课程采用“赛课结合”模式，但比赛项目和大作业不是同一件事：

- 大作业占课程成绩 70%，属于指定题目的个人作品；
- 硬件设计大赛占课程成绩 30%，其中初审结果占 25%，决赛结果占 5%；
- 大作业提供的 ESP32、硬件接口、传感器、运动控制、PCB 和软件架构知识，可以作为比赛项目的技术基础；
- 比赛应围绕团队自选或民生场景题目形成独立的项目目标、创新点与展示方案。

## 三、赛道设置

### 1. 主赛道

- 可自由选择嵌入式系统作品的主题、功能和实现方式；
- 初审后，根据评分与项目情况确定决赛入选名单；
- 决赛在决赛晚会现场进行项目汇报和实物成果演示。

### 2. 民生赛道

- 可从志愿组给定的题目中选题，也可面向具体民生场景自拟题目；
- 项目需要经过初审评委审核；
- 报名民生赛道且初审审核通过的队伍，按照排名和报名人数择优进入民生赛道终审；
- 未通过民生赛道初审审核的队伍，正常并入主赛道参赛；
- 两个赛道统一参加项目初审。

### 3. 赛道选择对项目设计的影响

| 对比项 | 主赛道 | 民生赛道 |
|---|---|---|
| 选题自由度 | 高，可自由确定主题 | 需针对给定或自拟的具体民生场景 |
| 初审重点 | 创新实用性、难度、完成度、展示效果 | 同样参加统一初审，并接受民生赛道适配性判断 |
| 终审额外重点 | 现场综合表现 | 命题项目看完成度、成本控制和展示效果；自拟项目还看应用前景与核心价值 |

## 四、比赛流程

```text
报名与组队
    ↓
开题报告提交与助教反馈
    ↓
项目研发、原型调试与展示准备
    ↓
统一初审答辩
    ├── 主赛道决赛名单
    ├── 民生赛道终审名单
    └── 部分未晋级优秀项目可获优胜奖
    ↓
提交全套原始开发资料
    ↓
民生赛道终审 / 主赛道决赛
    ↓
课程报告与个人贡献说明
```

### 1. 项目初审

- 时间：暂定秋季学期开学前两周；
- 形式：按报名人数设置多个分会场，线下答辩；
- 内容：介绍项目创新点、实现方案、应用场景等；
- 过程：全程录像；
- 结果：预计在初审结束后三日内公布主赛道决赛名单和民生赛道终审名单；
- 未晋级的部分优秀项目仍可能获得优胜奖。

#### 初审评分维度

每个分项按 5 分制评分：

| 维度 | 权重 | 建议展示证据 |
|---|---:|---|
| 创新性与实用性 | 30% | 真实痛点、现有方案不足、核心创新点、目标用户或应用场景 |
| 实现难度 | 20% | 硬件复杂度、算法难点、通信与控制难点、结构设计或系统集成难点 |
| 完成度 | 30% | 可稳定运行的实物、功能闭环、异常处理、测试结果、长期运行情况 |
| 展示效果 | 20% | 清晰叙事、可视化反馈、可靠现场演示、备用演示方案 |

原文件给出的初审计算式为：

```text
初审成绩 = 1.2 × 创新实用性
         + 0.8 × 实现难度
         + 1.2 × 完成度
         + 0.8 × 展示效果
```

评分经全体评委平均和归一后计入课程成绩，初审部分满分 25 分。评委还会判断项目是否适合民生赛道；该判断是进入民生赛道终审的必要但不充分条件。

### 2. 决赛与终审

#### 成绩构成

| 部分 | 占比 | 评定方式 |
|---|---:|---|
| 技术分 | 50% | 助教团队根据源文件和技术答辩表现综合评定 |
| 答辩分 | 50% | 终审现场评委评分 |

#### 每队答辩流程

总时长 13 分钟：

1. 现场展示：7 分钟；
2. 技术答辩：3 分钟；
3. 评委问答：3 分钟。

#### 两个赛道的终审要求

- 民生赛道命题项目：重点考察对给定命题的完成度、成本控制和最终展示效果；
- 民生赛道自拟项目：除上述内容外，额外考察应用前景与核心价值；
- 主赛道：在决赛晚会现场进行项目汇报和实地成果演示，由评委根据综合表现即时评分并确定奖项。

## 五、奖项设置

### 1. 各赛道奖项

| 赛道 | 特等奖 | 一等奖 | 二等奖 | 三等奖 |
|---|---:|---:|---:|---:|
| 民生赛道 | 1 | 1 | 2 | 若干 |
| 主赛道 | 1 | 2 | 4 | 8 |

此外，未进入终审或决赛名单的部分优秀项目也可能获得优胜奖。

### 2. 奖项对应报销额度

| 最终奖项 | 每队报销额度 |
|---|---:|
| 特等奖 | 3000 元 |
| 一等奖 | 2000 元 |
| 二等奖 | 1500 元 |
| 三等奖 | 1000 元 |
| 优胜奖 | 500 元 |
| 未获奖 | 300 元 |

如有特殊需求，可提交购置申请，说明必要性和可行性；是否获得额外支持取决于整体预算。

## 六、材料与答辩准备

### 1. 开题阶段

原文件只明确了开题报告的提交时间和反馈方式，没有给出固定模板。建议至少准备以下内容：

- 项目名称与一句话定义；
- 目标用户、使用场景和待解决问题；
- 核心功能与创新点；
- 总体软硬件架构；
- 关键器件、算法和通信方案；
- 团队分工；
- 技术风险与备选方案；
- 研发里程碑；
- 预算与拟申领/采购器件；
- 预期成果和现场展示方式。

> 本节清单是根据比赛评分维度整理的建议，不是主办方发布的强制模板。

### 2. 初审阶段

建议准备：

- 一份围绕“问题 - 方案 - 创新 - 实现 - 效果”的短答辩材料；
- 能稳定运行的实物原型；
- 核心功能现场演示；
- 系统框图、原理图、关键代码或算法说明；
- 实验数据、测试结果或对照验证；
- 演示失败时可用的录屏或视频备份；
- 开源项目、第三方库和参考方案的引用说明。

### 3. 决赛阶段

晋级队伍必须提交全套原始开发资料，包括但不限于：

- 源代码；
- 建模图纸；
- PCB 原理图；
- 其他能够证明技术真实性和项目开发过程的原始材料。

建议一并整理：

- BOM 与成本表；
- PCB 工程文件和 Gerber；
- 结构设计源文件；
- 接线图、接口表和数据手册依据；
- 调试日志、版本记录、测试视频；
- 团队成员贡献记录；
- 第三方代码、模型和素材的许可证及引用说明。

## 七、器件与赛事资源

### 1. 每名选手可领取的基础选手包

| 器件 | 数量 |
|---|---:|
| ESP32 开发板 | 1 |
| 三色 LED | 1 |
| OLED 屏 | 1 |
| USB 转 TTL | 1 |
| 杜邦线（公公/公母/母母，40P） | 3 |
| 400 孔面包板 | 2 |
| 舵机 | 2 |
| 按钮 | 5 |
| 电位器 | 1 |
| 无源蜂鸣器 | 1 |
| 12P 排针 | 4 |
| 光敏传感器 | 1 |
| 电工胶布 | 1 |

### 2. 可按需申领的扩展模块

每名选手最多领取两个扩展模块，具体领取方式以网络学堂和选手群通知为准。

| 扩展模块 | 赛事准备总量 |
|---|---:|
| 直流电机套装 | 100 |
| RC522 IC 卡感应器 | 50 |
| TFT 彩屏 | 50 |
| MPU6050 陀螺仪 | 50 |
| 红外发射器及接收器 | 50 |
| 超声传感器 | 50 |
| WS2812 灯带 | 50 |
| DHT11 温湿度传感器 | 50 |

项目中的数据手册目录已经包含 ESP32-S3、OLED、舵机、L298N、MPU6050、RC522、TFT、WS2812B、DHT11、HC-SR04 等器件资料，可直接用于器件选型、接口设计和答辩依据。

### 3. 套件更换

- 通过指定腾讯文档提前预约；
- 仅支持在小学期前三周和后两周线下领取；
- 不在北京时如需更换，可自行购买后申请报销；这类更换套件报销不计入个人报销额度；
- 发现器件异常时应先排查虚焊，再判断元件是否损坏。

## 八、报销规则

- 必须提供发票，仅凭发票报销；
- 一般使用增值税普通发票；
- 纸质发票须妥善保存，比赛结束后统一上交；
- 电子发票须保存原始 PDF，比赛结束后统一上交；
- 发票内容必须与作品制作直接相关且合理；餐饮和生活用品不能报销；
- 制作必需的工具和零件，在满足其他要求时可以报销；
- 不接受内容模糊或无关的发票，例如只写“电子元器件”；
- 单张 1000 元以上，或连号发票合计超过 1000 元，不予报销；
- 不确定是否可报销时，应在购买前咨询助教王易科；
- 购买前应向商家确认可以开具符合要求的发票。

### 开票信息

- 抬头：清华大学
- 纳税人识别号：12100000400000624D

如商家只能开具增值税专用发票，须提前联系助教王易科获取单位地址、电话、开户行及账号等信息。

## 九、学术诚信与安全要求

### 学术诚信

- 禁止抄袭、剽窃或使用不正当手段获取成绩；
- 可以查阅资料，也可以融合、改进开源项目；
- 引用开源项目时，必须在初审和最终报告中指出引用部分，并在答辩中明确说明；
- 团队应能清楚解释作品的整体框架、实现细节、创新点和调试过程；
- 可以合理使用 AI 工具提高效率，但不能依赖 AI 完成自己无法理解或解释的工作。

### 安全要求

- 遵守实验室安全操作规程；
- 涉及电气设备、焊接、运动机构和大电流负载时，采取必要防护措施；
- 在通电前检查短路、反接、电压和电流能力；
- 现场展示应准备急停、限位或断电措施，避免伤害人员和设备。

## 十、联系方式与信息渠道

- 助教组邮箱：hu-yh24@mails.tsinghua.edu.cn（胡云淏）
- 财务报销咨询：王易科
- 共性问题和非隐私问题：优先在课程群中提问
- 最新赛程、名单和扩展模块领取方式：关注网络学堂、课程群和选手群

## 十一、项目执行检查表

### 选题与开题

- [ ] 明确参加主赛道还是民生赛道
- [ ] 用一句话定义项目解决的问题
- [ ] 明确目标用户和使用场景
- [ ] 提炼 1-3 个可验证的创新点
- [ ] 完成软硬件架构和关键器件选型
- [ ] 明确团队分工、进度和预算
- [ ] 在 7 月 26 日前提交开题报告

### 原型开发

- [ ] 先验证高风险模块
- [ ] 建立代码仓库并保留版本记录
- [ ] 保存原理图、PCB、结构设计和测试数据
- [ ] 建立 BOM 和采购记录
- [ ] 对关键功能进行稳定性和异常测试
- [ ] 明确第三方代码、库、模型和素材的来源及许可证

### 初审准备

- [ ] 答辩同时覆盖创新、难度、完成度和展示效果
- [ ] 实物演示能够在限定时间内稳定完成
- [ ] 准备演示视频或录屏作为备用
- [ ] 能解释核心电路、算法、通信和调试过程
- [ ] 明确每位成员的贡献
- [ ] 主动说明所有开源或第三方引用

### 决赛准备

- [ ] 整理全套原始开发资料
- [ ] 将 7 分钟展示反复计时演练
- [ ] 准备 3 分钟技术答辩的高频问题
- [ ] 准备 3 分钟评委问答的简洁回答
- [ ] 对实物进行连续运行和运输后复测
- [ ] 检查发票、原始电子 PDF 和报销材料

## 十二、资料来源

本文主要根据以下项目内文件整理：

1. [《课程与赛事说明(2).pdf》](文档/比赛相关文档/课程与赛事说明(2).pdf) - 比赛章程、赛程、评分、奖项、套件和报销规则的主要依据；
2. [《大作业方案.pdf》](文档/比赛相关文档/大作业方案.pdf) - 仅用于理解课程背景和可复用技术方向；
3. [《大作业评分标准.pdf》](文档/比赛相关文档/大作业评分标准.pdf) - 仅作为工程文档、架构说明和调试记录的参考；
4. [《帮助文档1.pdf》](文档/比赛相关文档/帮助文档1.pdf) - 可参考其需求分析、软硬件架构、状态机和流程图方法；
5. `文档/数据手册/` - 比赛项目器件选型与技术论证资料。

> 若本文与后续官方通知不一致，以主办方在网络学堂、课程群或选手群发布的最新通知为准。
