77-GGG/CyberArm/slides/硬赛/开题报告提交稿/chapters/preface.tex

% ============================================================
\phantomsection
\section*{前言}
\addcontentsline{toc}{section}{前言}

各位老师及助教好，我是本篇开题报告的作者祁果。我是建筑学院大二的本科生，专业和电子信息工程没有任何关系。报名参加本次硬件设计大赛，纯粹是出于兴趣与爱好。由于之前做过一些基于OpenCV、YOLO的视觉识别项目，也玩过一些ESP32的开发板（不过仅限于连接一些现成的模块），所以想尝试把视觉识别和机械臂结合起来，做一个可以在桌面上进行简单交互的机械臂。

在做这篇开题报告的时候，我广泛地阅读了各种相关的资料，参考了很多开源项目，查阅了大量的ESP32、舵机、摄像头等硬件的资料，也使用AI进行了辅助设计。由于本人是非专业出身，很多内容可能不够严谨，甚至有些地方可能存在错误。希望各位老师和助教在评审的时候多多指正。
