77-GGG/CyberArm/slides/beamer_template/demo.pdf

# CaseStudy Layout

# Architecture / Museum Studies

### Studio / Course 2026 School of Architecture Prof. Your Name TA: Your Name

202609

### 案例标题 / Case Title

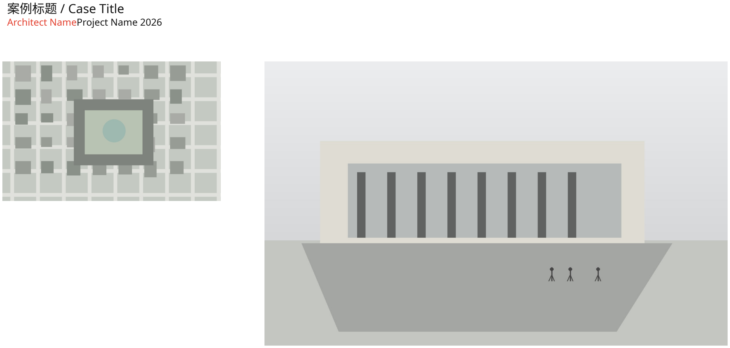
[picture p17: page 2]

Architect NameProject Name 2026

### 平面与空间 / Plan + Space

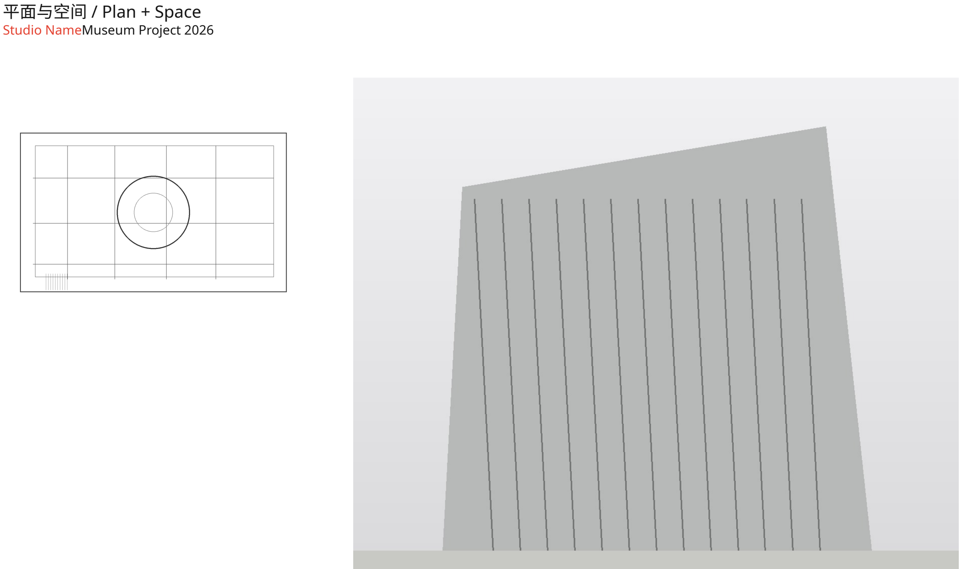
[picture p18: page 3]

Studio NameMuseum Project 2026

### 剖面与路径 / Section + Circulation

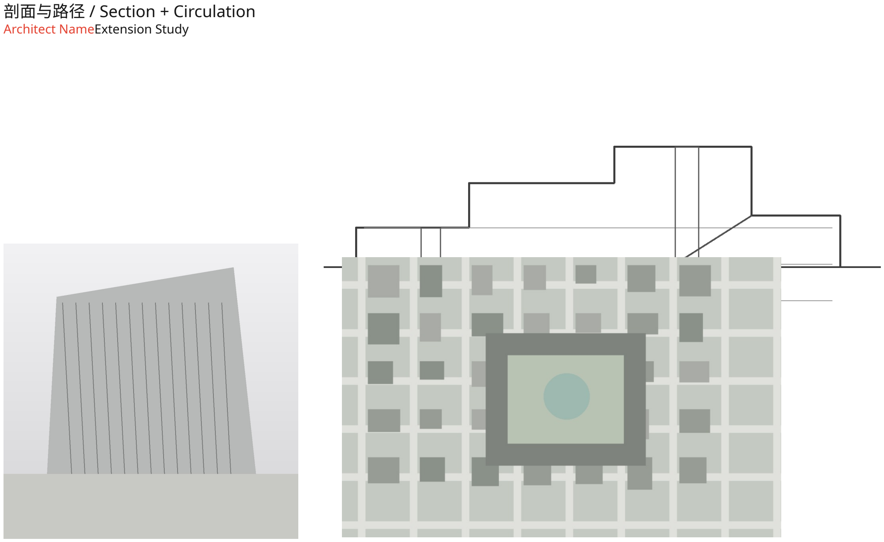
[picture p19: page 4]

Architect NameExtension Study

### 城市关系 / Urban Context

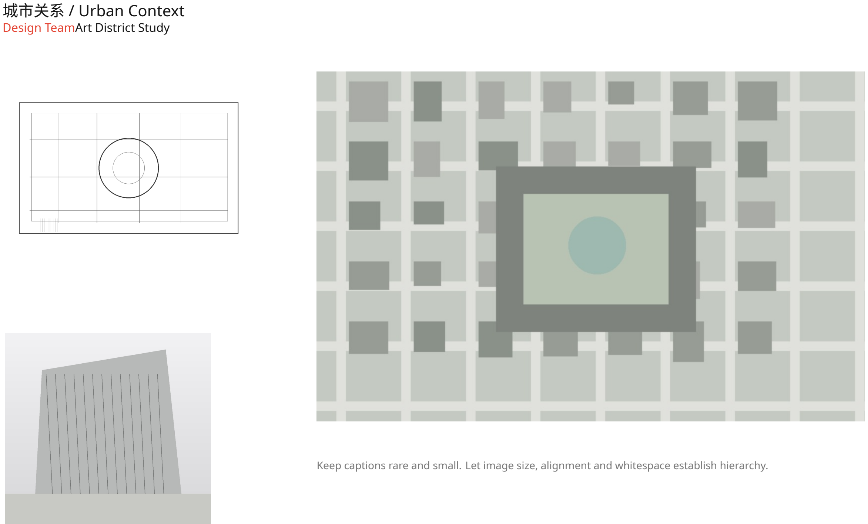
[picture p20: page 5]

Design TeamArt District Study

Keep captions rare and small. Let image size, alignment and whitespace establish hierarchy.

### 分析页 / Analytical Note

Case StudySpatial Strategy

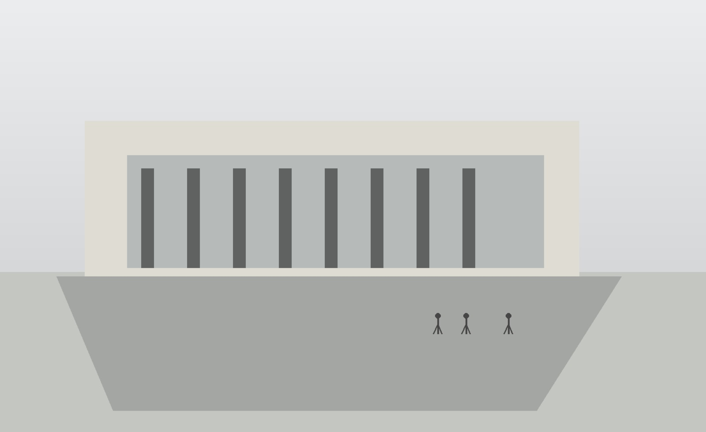
[picture p21: figure]

01 / Main idea
Keep the statement short. The source deck relies on visual evidence rather than dense explanatory text.

02 / Graphic rule

Use one dominant visual and one secondary drawing or photograph. Avoid boxes, shadows and decorative bands.

WHITE SPACE / ALIGNMENT / SCALE

# END

## Replace the placeholders with your own project images and draw-

ings.
