77-GGG/CyberArm/slides/beamer_template/assets/aerial.jpg

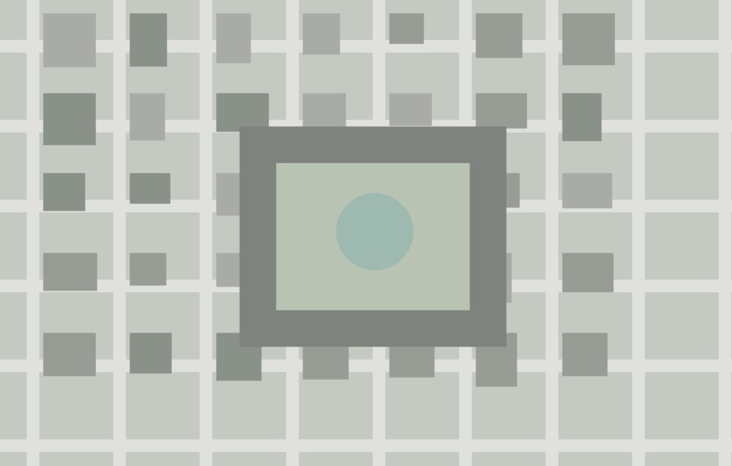
slides/beamer_template/assets/aerial.jpg
