77-GGG/CyberArm/slides/beamer_template/assets/facade.jpg

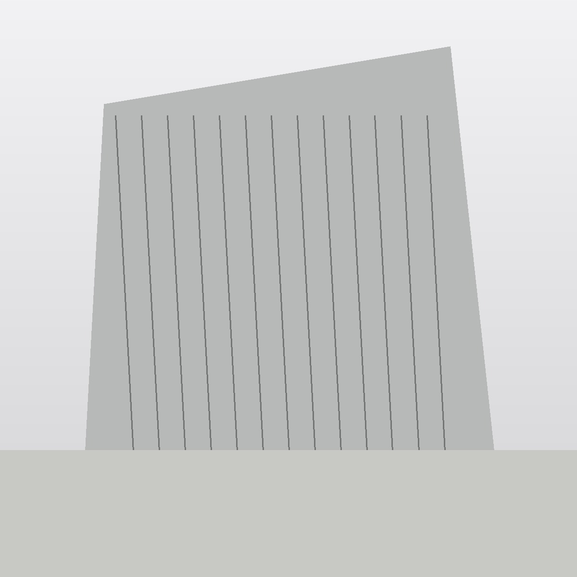
slides/beamer_template/assets/facade.jpg
