77-GGG/CyberArm/slides/beamer_template/assets/plan.png

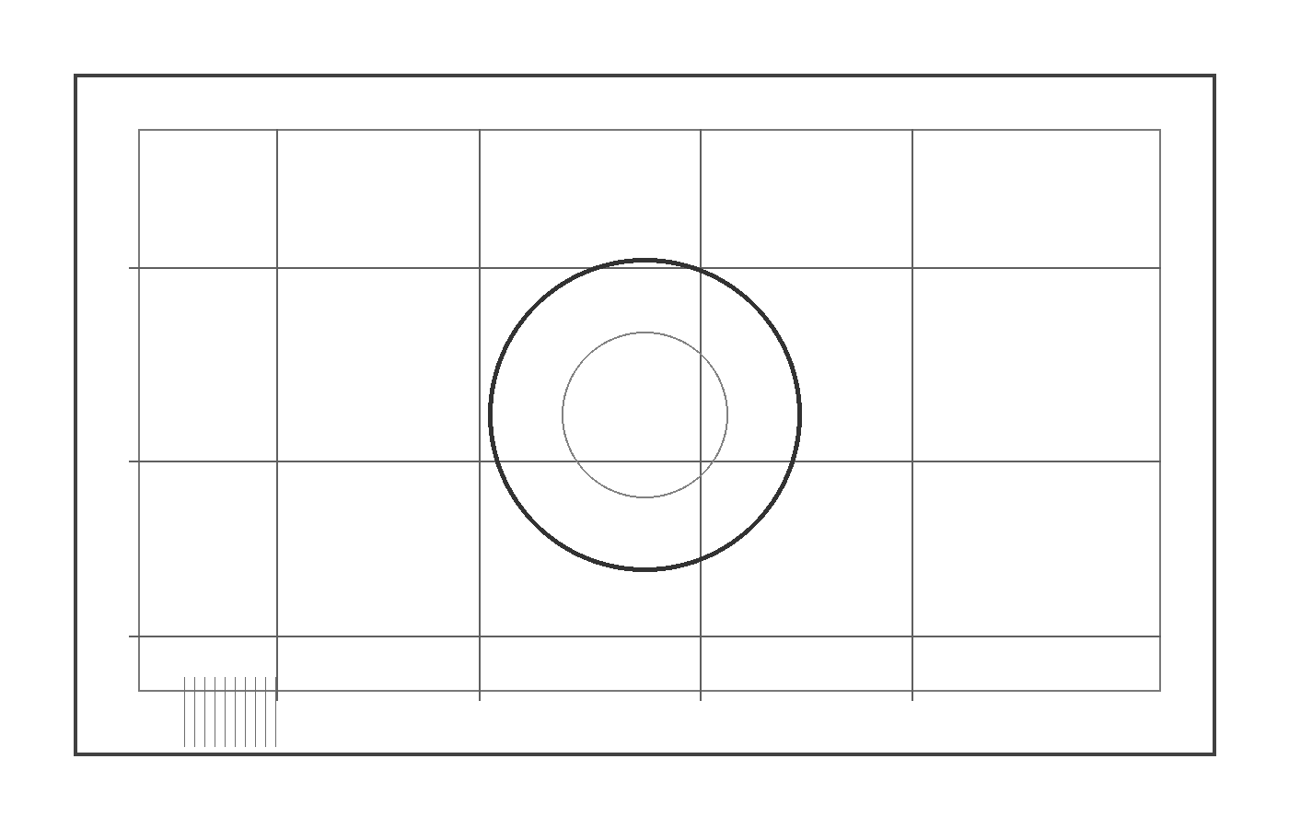
slides/beamer_template/assets/plan.png
