77-GGG/CyberArm/slides/beamer_template/assets/section.png

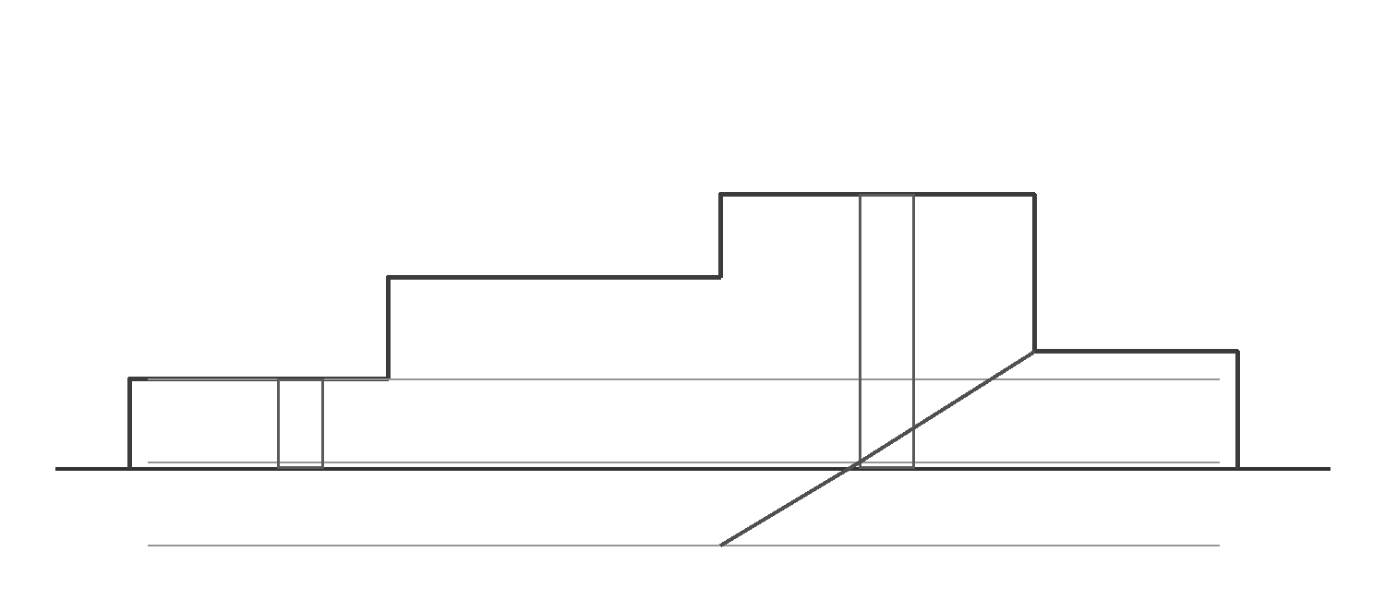
slides/beamer_template/assets/section.png
