77-GGG/CyberArm/slides/renders/CyberArm_RevL_rear.png

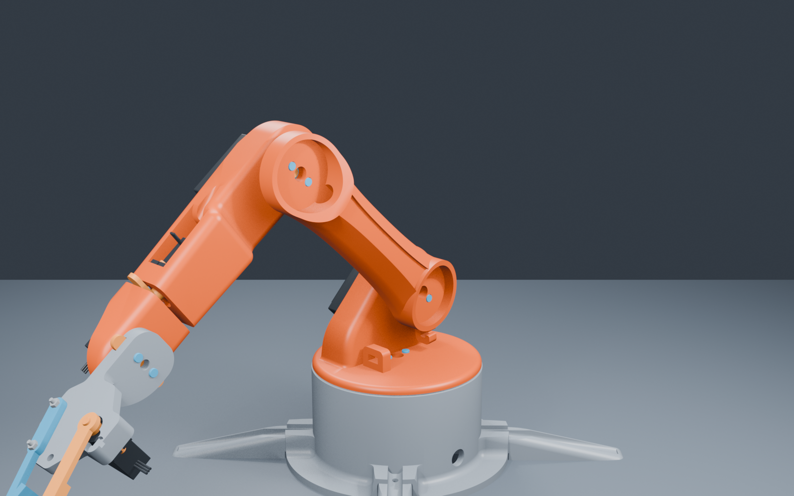
slides/renders/CyberArm_RevL_rear.png
