77-GGG/CyberArm/slides/renders/CyberArm_RevL_side.png

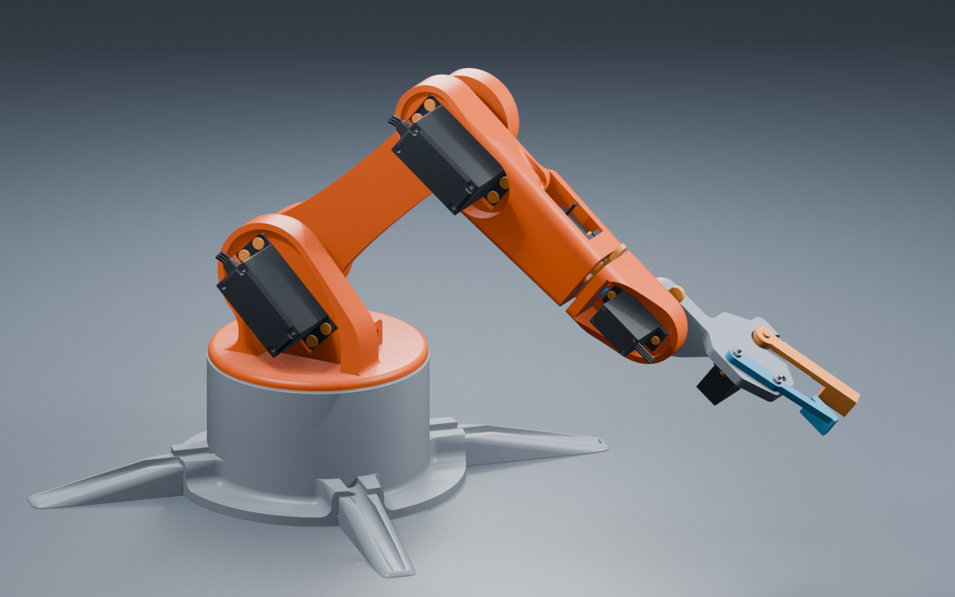
slides/renders/CyberArm_RevL_side.png
