77-GGG/CyberArm/slides/renders/CyberArm_RevL_structure.png

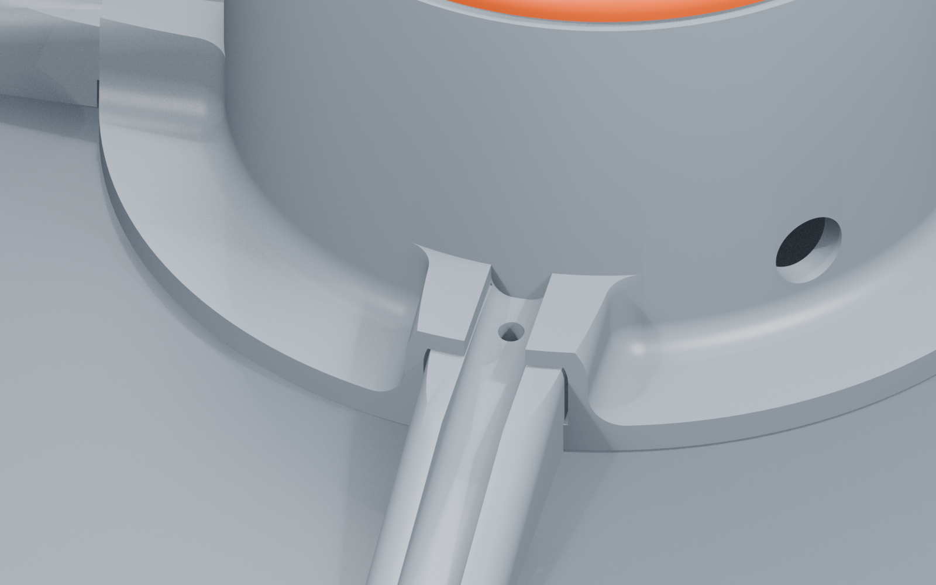
slides/renders/CyberArm_RevL_structure.png
