77-GGG/CyberArm/mechanical/arduino_reference_revC/PRINT_FIRST_RevC_mm/S02_actual_interface_trial_mm.stl

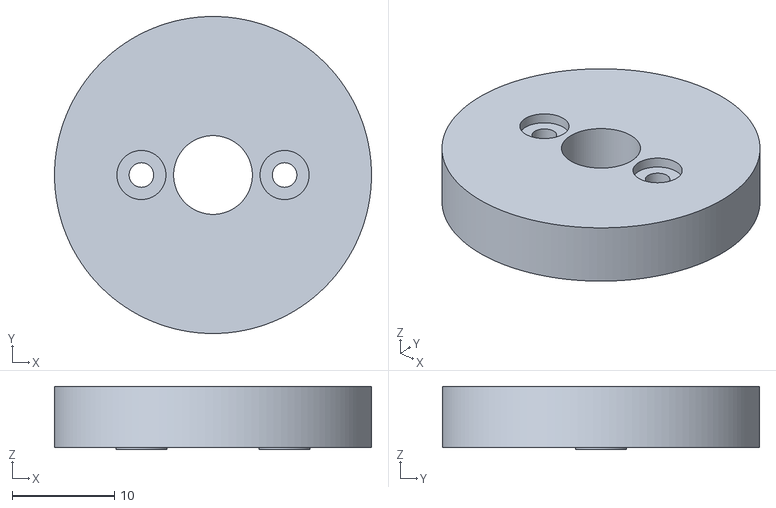
[picture p29: CAD file, 2026-09-08]
mechanical/arduino_reference_revC/PRINT_FIRST_RevC_mm/S02_actual_interface_trial_mm.stl
31.0 x 31.0 x 6.20
