77-GGG/CyberArm/mechanical/arduino_reference_revC/STL_RevC_mm/Base_RevC_mm.stl

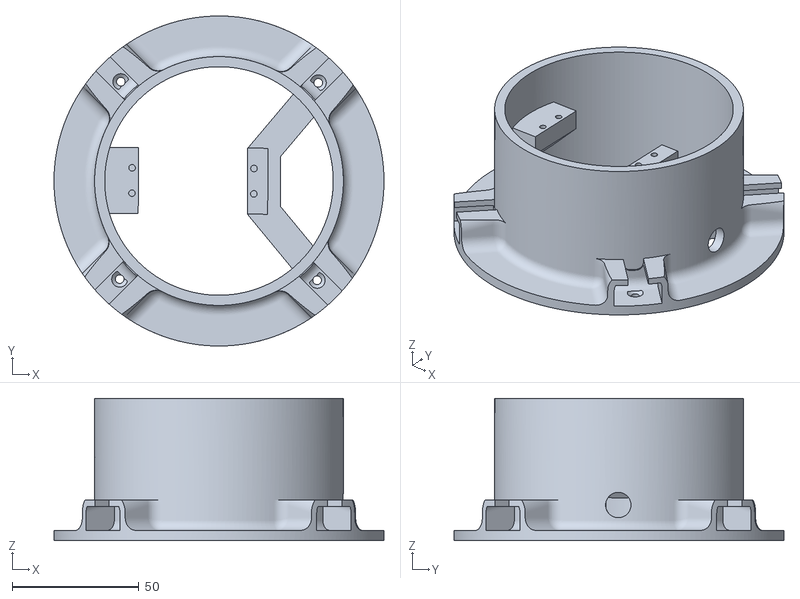
[picture p30: CAD file, 2026-09-08]
mechanical/arduino_reference_revC/STL_RevC_mm/Base_RevC_mm.stl
130.0 x 130.0 x 56.0
