77-GGG/CyberArm/mechanical/打印/01_所有完整打印件/02_支脚_打印4件__Pata_de_Soporte_RevC_mm.stl

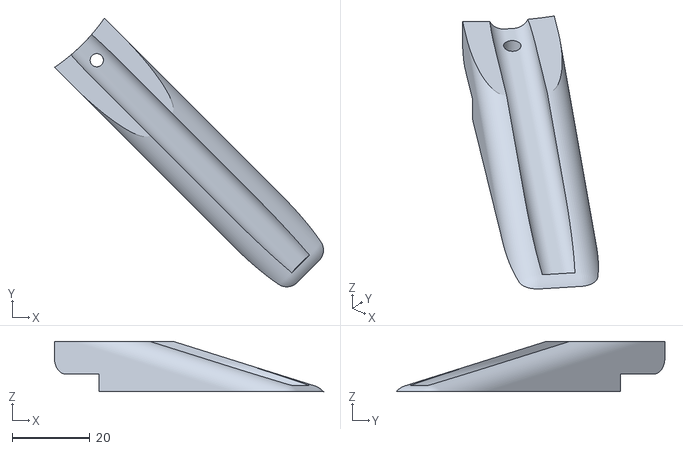
[picture p31: CAD file, 2026-09-08]
mechanical/打印/01_所有完整打印件/02_支脚_打印4件__Pata_de_Soporte_RevC_mm.stl
69.1 x 69.0 x 12.9
