77-GGG/CyberArm/mechanical/arduino_reference_revC/PRINT_FIRST_RevC_mm/S05_actual_interface_trial_mm.stl

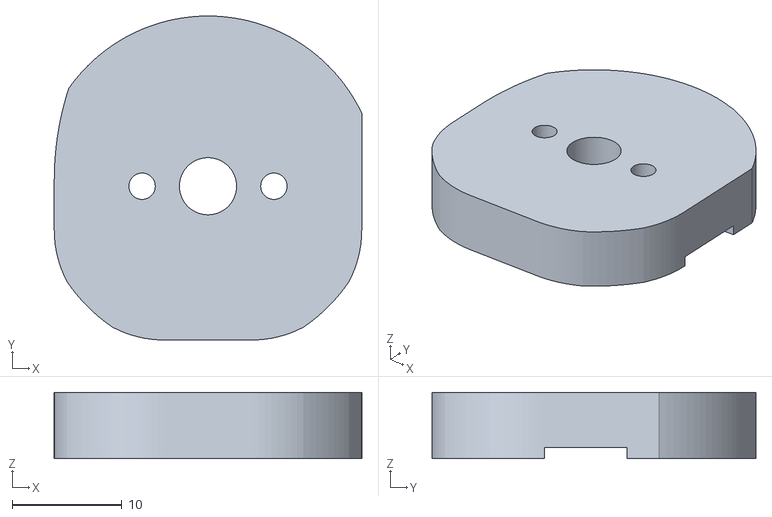
[picture p32: CAD file, 2026-09-08]
mechanical/arduino_reference_revC/PRINT_FIRST_RevC_mm/S05_actual_interface_trial_mm.stl
28.0 x 29.5 x 6.03
