77-GGG/CyberArm/mechanical/arduino_reference_revC/STL_RevC_mm/Gripper_base_RevC_mm.stl

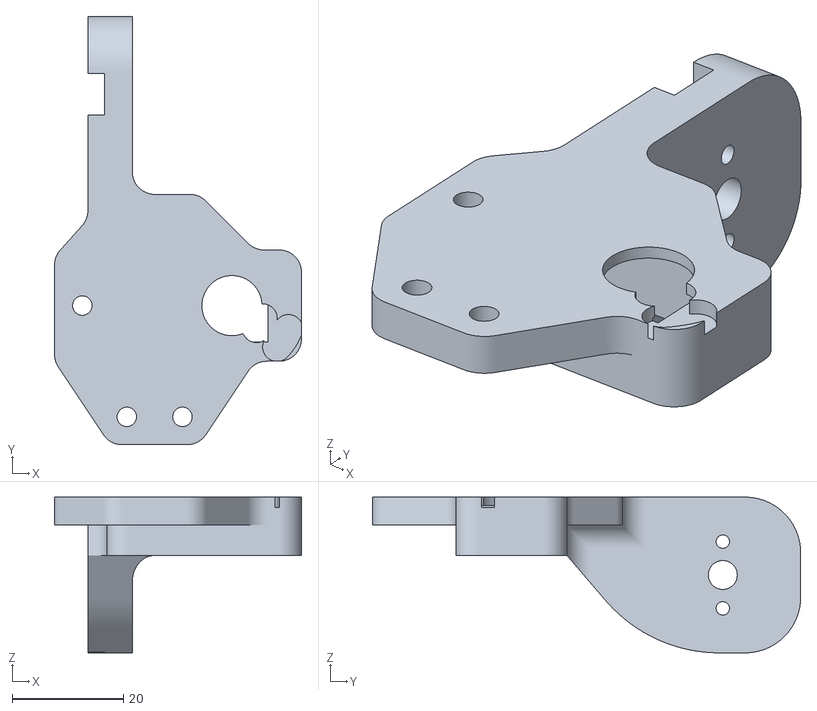
[picture p33: CAD file, 2026-09-08]
mechanical/arduino_reference_revC/STL_RevC_mm/Gripper_base_RevC_mm.stl
44.4 x 77.0 x 28.0
