77-GGG/CyberArm/mechanical/打印/01_所有完整打印件/03_回转盘与肩部支架_打印1件__Waist_RevC_mm.stl

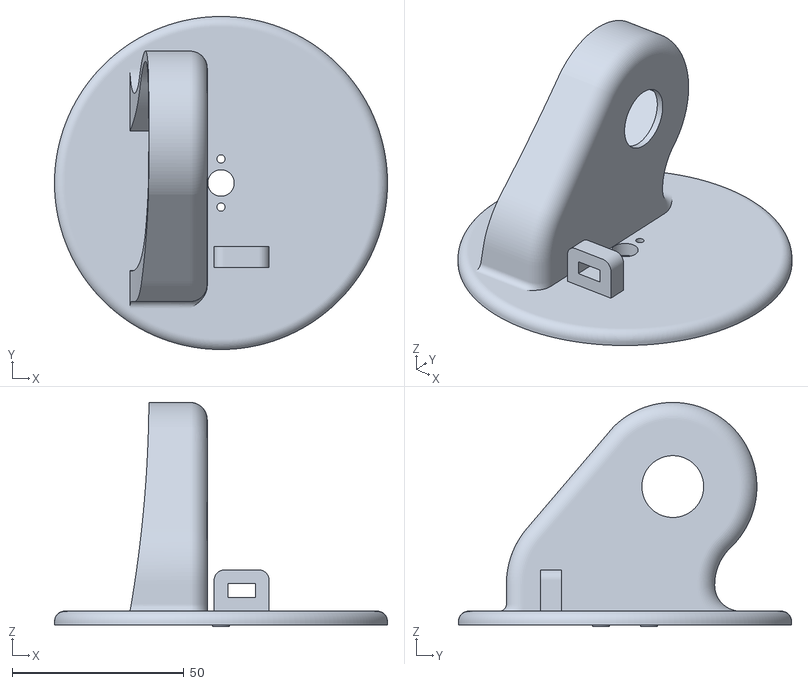
[picture p34: CAD file, 2026-09-08]
mechanical/打印/01_所有完整打印件/03_回转盘与肩部支架_打印1件__Waist_RevC_mm.stl
97.0 x 97.0 x 65.3
