77-GGG/CyberArm/mechanical/打印/02_先打印的接口试装片/S06_夹爪驱动_MG90S单臂_试装1件_mm.stl

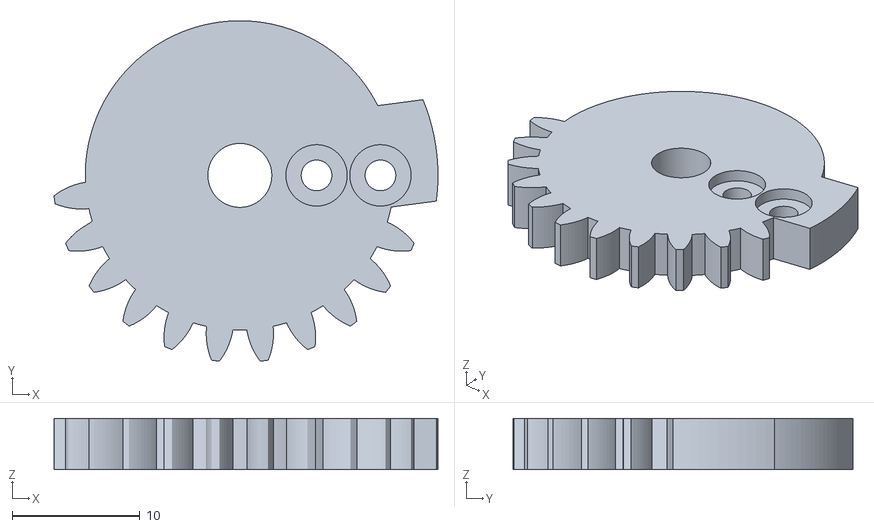
[picture p35: CAD file, 2026-09-08]
mechanical/打印/02_先打印的接口试装片/S06_夹爪驱动_MG90S单臂_试装1件_mm.stl
30.0 x 26.6 x 4.00
