77-GGG/CyberArm/mechanical/arduino_reference_revC/STL_RevC_mm/Arm_01_RevC_mm.stl

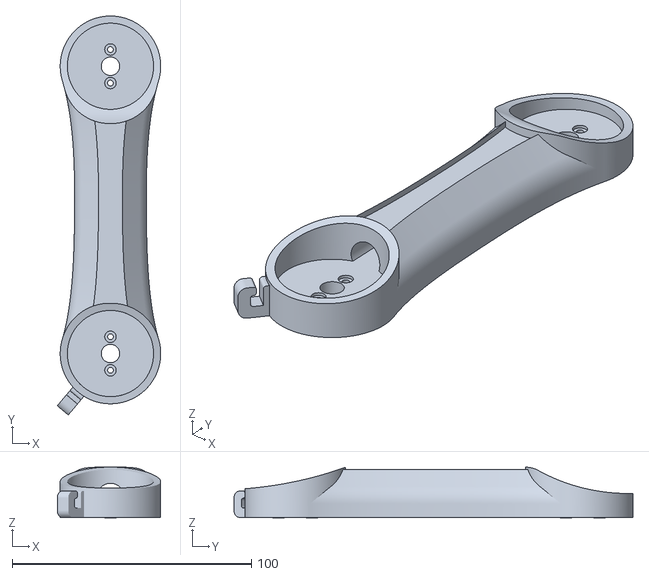
[picture p36: CAD file, 2026-09-08]
mechanical/arduino_reference_revC/STL_RevC_mm/Arm_01_RevC_mm.stl
43.2 x 166.7 x 21.2
