77-GGG/CyberArm/mechanical/打印/01_所有完整打印件/05_小臂_打印1件__Arm_02_v3_RevC_mm.stl

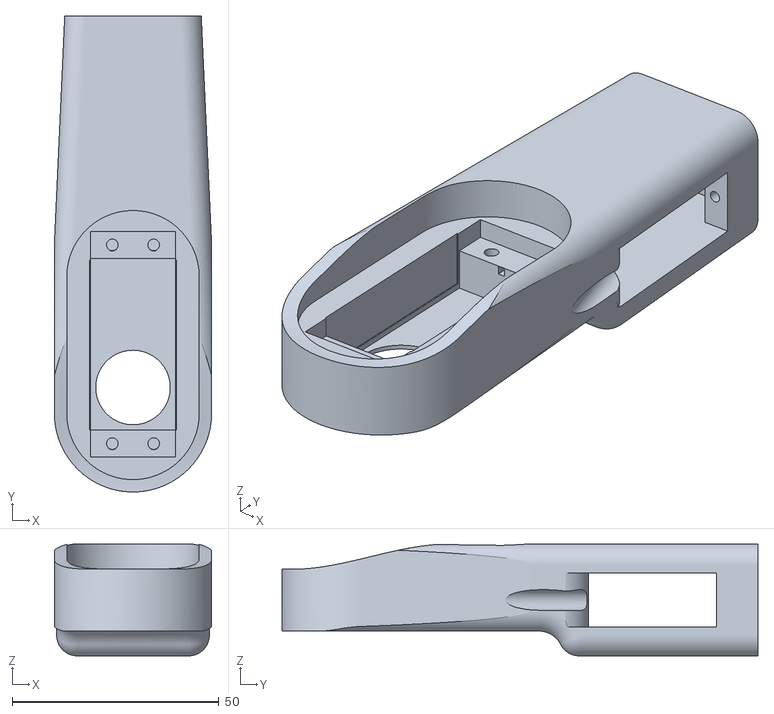
[picture p37: CAD file, 2026-09-08]
mechanical/打印/01_所有完整打印件/05_小臂_打印1件__Arm_02_v3_RevC_mm.stl
38.0 x 115.0 x 27.0
