77-GGG/CyberArm/mechanical/打印/03_不单独打印试片的零件/12_右夹爪_打印1件__Gripper_1_1_RevC_mm.stl

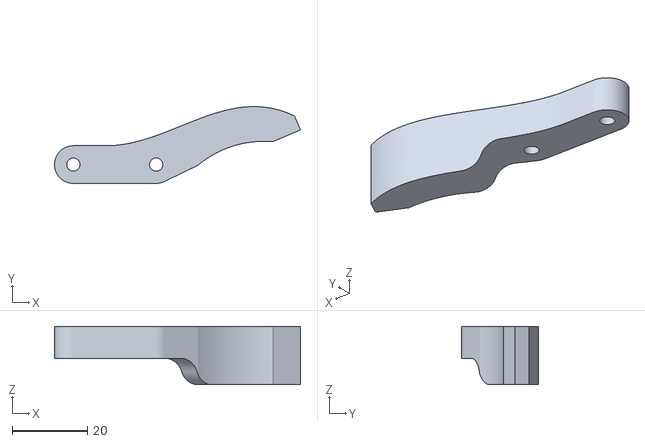
[picture p38: CAD file, 2026-09-08]
mechanical/打印/03_不单独打印试片的零件/12_右夹爪_打印1件__Gripper_1_1_RevC_mm.stl
65.3 x 20.4 x 15.5
