77-GGG/CyberArm/mechanical/arduino_reference_revC/PRINT_FIRST_RevC_mm/S01_actual_interface_trial_mm.stl

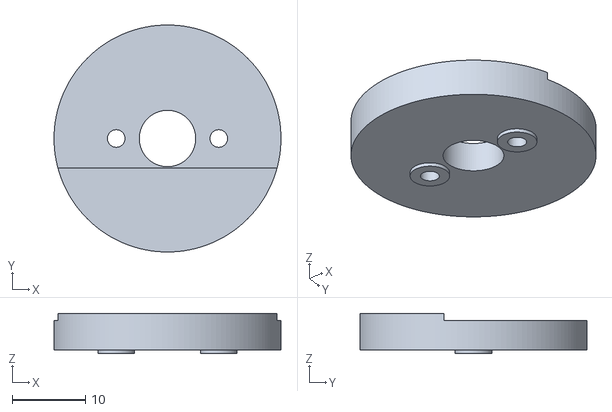
[picture p39: CAD file, 2026-09-08]
mechanical/arduino_reference_revC/PRINT_FIRST_RevC_mm/S01_actual_interface_trial_mm.stl
31.0 x 31.0 x 5.50
