77-GGG/CyberArm/mechanical/打印/01_所有完整打印件/09_夹爪短连杆_打印2件__grip_link_1_RevC_mm.stl

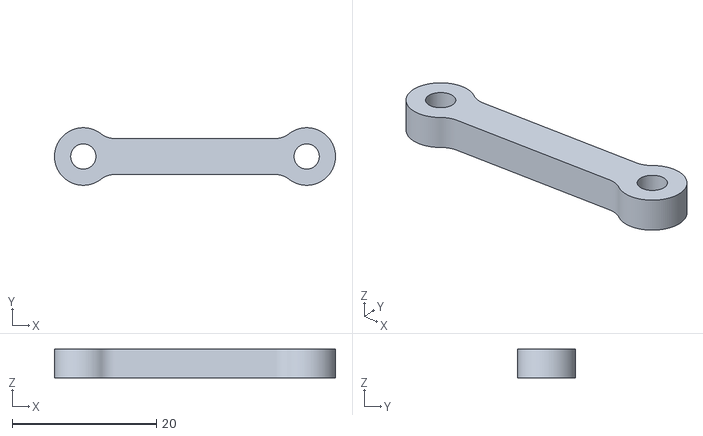
[picture p40: CAD file, 2026-09-08]
mechanical/打印/01_所有完整打印件/09_夹爪短连杆_打印2件__grip_link_1_RevC_mm.stl
39.0 x 8.00 x 4.00
