77-GGG/CyberArm/mechanical/打印/03_不单独打印试片的零件/08_从动齿轮连杆_打印1件__gear1_RevC_mm.stl

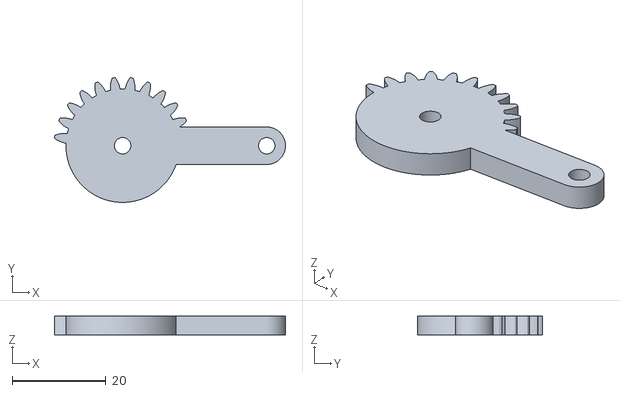
[picture p41: CAD file, 2026-09-08]
mechanical/打印/03_不单独打印试片的零件/08_从动齿轮连杆_打印1件__gear1_RevC_mm.stl
49.3 x 26.6 x 4.00
