77-GGG/CyberArm/mechanical/arduino_reference_revC/PRINT_FIRST_RevC_mm/S04_actual_interface_trial_mm.stl

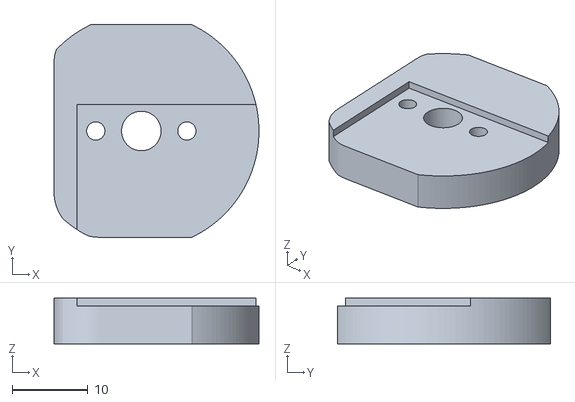
[picture p42: CAD file, 2026-09-08]
mechanical/arduino_reference_revC/PRINT_FIRST_RevC_mm/S04_actual_interface_trial_mm.stl
27.0 x 28.0 x 6.00
