77-GGG/CyberArm/mechanical/arduino_reference_revC/STL_RevC_mm/Arm_03_RevC_mm.stl

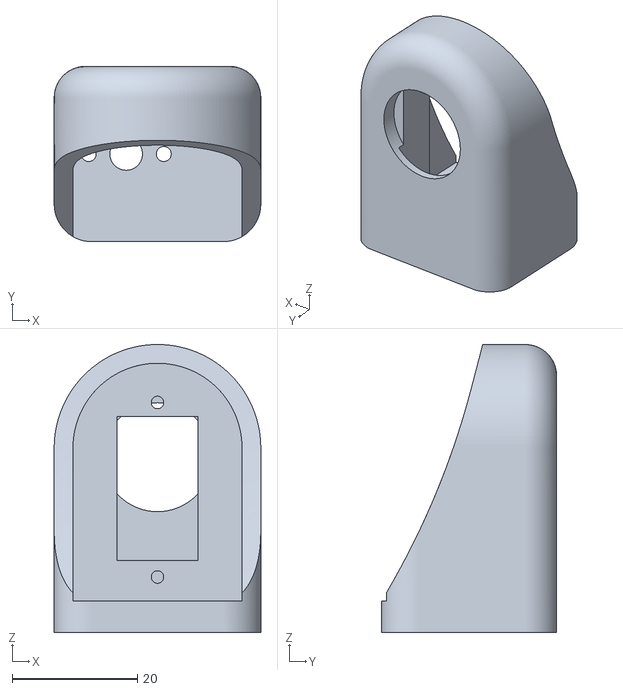
[picture p43: CAD file, 2026-09-08]
mechanical/arduino_reference_revC/STL_RevC_mm/Arm_03_RevC_mm.stl
33.0 x 28.0 x 46.0
