77-GGG/CyberArm/(list of files, cad)

Other CAD files:
mechanical/打印/02_先打印的接口试装片/S03_肘关节_MG996R圆盘_试装1件_mm.stl
mechanical/arduino_reference_revC/STL_RevC_mm/Gripper_1_RevC_mm.stl
mechanical/arduino_reference_revC/PRINT_FIRST_RevC_mm/S03_actual_interface_trial_mm.stl
mechanical/打印/03_不单独打印试片的零件/10_左夹爪_打印1件__Gripper_1_RevC_mm.stl
mechanical/打印/01_所有完整打印件/10_左夹爪_打印1件__Gripper_1_RevC_mm.stl
mechanical/arduino_reference_revC/STL_RevC_mm/gear2_RevC_mm.stl
mechanical/打印/01_所有完整打印件/11_主动齿轮连杆_打印1件__gear2_RevC_mm.stl
