77-GGG/CyberArm/mechanical/arduino_reference_revC/ASSEMBLY_RevC_zh.md

# RevC｜舵机—舵盘—打印件连接说明

更新：2026-09-07。单位：mm。状态：**接口试装版，尚未经过实物装配、整机运动范围与承载测试**。

本版保留参考机械臂外形、已去除的底座/小臂 Logo 和 RevB 联动控制。重新做了 6 处舵盘连接：真实通孔、局部沉孔、12 套传动螺栓/垫片/螺母、6 颗中心锁紧螺丝，以及腕部固定支架上的螺母避让。原下载文件和 RevB 文件不变。

## 1. 两类连接不要混淆

**舵机与舵盘：** 原厂舵盘的内花键套在舵机输出轴上，花键传递转矩；原厂中心短螺丝穿过舵盘中心，拧入输出轴，防止舵盘轴向脱落。它不负责把打印零件夹紧。打印件中心的大孔是螺丝/螺丝刀检修通道，不是轴孔，也不是螺母孔。

**舵盘与打印件：** 每处使用两颗 M2 贯穿螺栓。由外向舵机一侧的顺序为：

`M2 螺栓头 → 小垫片 → 打印件 → 原厂舵盘 → M2 螺母`

舵盘直接参与传动，打印件由螺栓夹持在舵盘上；没有胶粘连接，也不依赖打印花键。S01–S03 的打印接触面增加了局部一体承压垫台，填补 CAD 中原有的轴向间隙。

**你提供的 MG90S 照片：** 红圈中的短螺丝按原厂中心锁紧件使用；两颗长尖头螺丝按安装耳固定件使用，不混作上述 M2 传动螺栓。照片没有比例尺，不能确认具体螺纹、头下长度或拧入深度。

## 2. 六处接口尺寸

以下“孔距”指孔中心距，不是舵盘总长；螺栓长度从头下算。全部打印件传动通孔为 **Ø2.4**，对应舵盘选中孔须加工至 **Ø2.2**。

| 编号 / 位置 | 原厂舵盘 | 打印件 | 选孔方式 | 每处传动螺栓 | 外侧沉孔 | 中心检修孔 |
|---|---|---|---|---|---|---|
| S01 底座回转 | MG996R 圆盘 | Waist | 相对两孔，14 孔距，半径 ±7 | M2×10，2 颗 | 无 | Ø7.7 |
| S02 肩关节 | MG996R 圆盘 | Arm_01 肩端 | 相对两孔，14 孔距 | M2×10，2 颗 | Ø4.8，深 1 | Ø7.7 |
| S03 肘关节 | MG996R 圆盘 | Arm_01 肘端 | 相对两孔，14 孔距 | M2×10，2 颗 | Ø4.8，深 1 | Ø7.7 |
| S04 腕旋转 | MG90S 双臂 | Arm_03 | 长臂两侧各一孔，12 孔距，半径 ±6 | M2×10，2 颗 | 无 | Ø5.2 |
| S05 腕俯仰 | MG90S 十字 | Gripper_base | **长臂**两侧各一孔，12 孔距，半径 ±6 | M2×10，2 颗 | 无 | Ø5.2 |
| S06 夹爪驱动 | MG90S 单臂 | gear2 | 同一侧距输出轴 6、11，两孔相隔 5 | M2×8，2 颗 | Ø4.8，深 1 | Ø5.0 |

S05 不再使用 RevB 的短臂 10.2 孔距：短臂位置放不下标准 M2 螺母，旧孔已填实，改用长臂两孔。请勿混用旧版试装片。

沉孔只是给垫片和螺栓头局部让位，**不是全埋头**；M2 圆柱头仍高出部分表面。装配模型已按真实头高放置。

## 3. 这套方案需要加工原厂舵盘

**不是拿到打印件后直接拧入现有小孔。** 本版使用 M2 机螺纹通栓+螺母，需要将每个舵盘选中的两个小孔扩至 Ø2.2。三种 MG90S 舵盘都保留原形，不切掉十字短臂。

先用试装片与实物比对孔距，再拆下舵盘，在稳定夹持和背垫支承下扩孔，双面去毛刺。不要把舵盘装在舵机上钻孔；不要钻花键或中心锁紧孔。若实物孔位不匹配、孔边开裂或薄壁不足，停止加工并调整接口，不能硬拉螺丝对孔。

CAD 中 MG996R 舵盘原孔约 Ø1.5、MG90S 原孔约 Ø1.8；这些是下载模型尺寸，**不等于对你的实物测量**。原始未加工舵盘仍以隐藏对象保留，当前可见的 `REVC_*_HORN_DRILL_2p2` 表示加工后的装配参考；它们不能拿去打印代替原厂舵盘。

## 4. 五金清单与夹紧厚度

本表只包括新增的 6 处舵盘传动连接，不是整台机械臂所有五金。

| 项目 | 规格 | 数量 |
|---|---|---:|
| 内六角圆柱头机螺栓 | M2×10，螺距 0.4，头径约 3.8、头高约 2，内六角 1.5 | 10 |
| 内六角圆柱头机螺栓 | M2×8，同上 | 2 |
| 普通六角螺母 | M2，对边 4，厚 1.6 | 12 |
| 小外径平垫片 | M2 / DIN 433，内径 2.2、外径 4.5、厚 0.3 | 12 |
| 中心锁紧螺丝 | 每台舵机对应的原厂短螺丝 | 6 |

螺母在图中用金色区分，颜色不是指定黄铜材质；采购常规合适强度的金属螺母即可。不要不经复核就改成加厚防松螺母、大外径垫片或更长螺丝，它们可能碰到舵机壳体或相邻结构。螺纹在模型中是标称可视化几何，不是加工用螺纹实体。

标称叠厚（打印承压面 + 舵盘 + 垫片 + 螺母）：

| 位置 | 头下夹紧叠厚 | 螺栓长度 | 超出螺母的尾长 |
|---|---:|---:|---:|
| S01 | 4 + 0.5 垫台 + 2.3 + 0.3 + 1.6 = 8.7 | 10 | 1.3 |
| S02 / S03 | 6 − 1 沉孔 + 0.2 垫台 + 2.3 + 0.3 + 1.6 = 9.4 | 10 | 0.6 |
| S04 / S05 | 5 + 2.5 + 0.3 + 1.6 = 9.4 | 10 | 0.6 |
| S06 | 4 − 1 沉孔 + 2.5 + 0.3 + 1.6 = 7.4 | 8 | 0.6 |

MG996R 中心螺丝用了你提供的 CAD 内 M3、头下长 6 的源模型，仍须以实物原厂件为准。MG90S 中心螺丝为橙色 **M2×5 占位包络，绝非采购规格**；不用这个估算值替换你照片中的原厂短螺丝。中心螺丝是否到底、是否有足够啮合，必须实物确认。

参考标称尺寸来源：[Bossard 圆柱头螺钉尺寸表](https://www.tme.eu/Document/acdf6f7d40f0fe318b4a64f0ef6b3bc4/BN612-FR.pdf)、[TR DIN 433 小垫片](https://www.trfastenings.com/products/Catalogue/Washers-Circlips-Seals-Rings/Washers/Flat-Washers/DIN433/TR00020811)、[Bossard BN 504 螺母](https://bossard.partcommunity.com/3d-cad-models/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)。最终按实际购买规格复核。

## 5. 背面避让与装配顺序

Arm_02_v3、Arm_03 原有的腕部中心开口已扩大至 Ø17.4，给螺母和螺钉尾部旋转让位，没有留下削到很薄的膜状槽底。Gripper_base 增加两条局部弧形避让槽，覆盖夹爪传动的 ±10° 几何范围；当前夹爪预览仍限制为 **±8°**。这不表示机械臂可以整圈旋转，也不表示实物舵机已校准。

1. 先确认实物花键匹配、孔距、舵盘厚度和原厂中心螺丝。舵机按所用控制器流程独立回中；不要靠强扭断电输出轴找角度。
2. 先打印对应 `PRINT_FIRST_RevC_mm` 试装片。通过后，按上述说明加工舵盘两孔。
3. **在舵盘离开舵机时**，将两颗 M2 螺栓、垫片、打印件、舵盘和背面螺母组装好。使用薄扳手或合适夹持工具止转螺母，均匀轻拧；不要压坏塑料。
4. 将预装组合件套上舵机花键，确认舵盘完全就位、螺母/尾端与壳体之间有间隙，不能用中心螺丝硬拉未对准的花键。
5. 从打印件中心检修孔放入并拧紧原厂中心螺丝。它应压住舵盘，而不是压在打印件上。
6. 完成舵机安装耳固定。照片中长尖头螺丝的实物直径、有效啮合深度仍应与对应导孔匹配，不能假设它们就是本表的 M2 机螺栓。
7. 用限流、低速、小角度方式试运行，检查整个关节、线缆和夹爪连杆，不碰撞后再逐步扩大范围。出现干涉、掉齿、开裂、发热或失步即停机。

下载模型给出的螺母角点至舵盘中心凸台的保守径向余量：MG996R 约 **0.29**，MG90S 最小约 **0.21**。这个空间较紧，实物批次差异可能消耗余量；必须离机预装，不要在狭窄间隙内强塞普通厚套筒。

## 6. 文件怎么用

- `Arduino_Replica_RevC_Connections.blend`：装配总文件。原始未加工舵盘隐藏保存；打印件、加工后舵盘、金属件分集合。六个 `EXPLODED_S01…S06` 场景可逐项查看连接。
- `connections.html`：中文图册，包含六处展开图和尺寸表。图中的打印件只显示真实接口的局部截取，不是新增的整臂零件。
- `STL_RevC_mm`：12 种整件，已按毫米导出；支脚打印 4 个、`grip_link_1` 打印 2 个，其余各 1 个。所有零件单件包围盒均小于 167 mm，不代表已经做过完整切片/支撑优化。
- `PRINT_FIRST_RevC_mm`：6 个实际接口截取试装片。只能验证舵盘孔距、检修孔和螺钉叠厚，不能替代固定支架试装和结构强度验证。S02、S03 接口相同，可以先试一个。
- `Arm_01` 沿用源文件中的两个独立实体（主臂和一个小附件），不是本轮布尔破洞。切片时保留附件，不要盲目合并或删除。
- Blender 中选择 `ARM_CONTROLS` → 对象属性 → 自定义属性，可以联动预览 5 个关节和夹爪；新增螺栓、螺母随对应零件运动。不是接触仿真、负载仿真或已标定的 PWM 控制。

打印先保持 **100% 尺寸**，选择与你实际耗材标签一致的材料预设；“P1S 默认材料”不能确认是 PLA 还是其他材料。小孔若缩孔，应根据试装结果校孔或改孔补偿，不要缩放整件。全臂打印前仍需确定壁数、填充、方向和支撑。

## 7. 已验证与尚未验证

已完成：6 处中心通道无阻挡、12 个 Ø2.4 通孔及对应沉孔的多深度径向采样；12 个整件和 6 个试装片 STL 的封闭边、退化三角形和正体积检查全部通过。新增传动五金对打印件的静态检查未发现超过 0.03 的采样穿透；与源舵机显示网格未发现三角面相交。腕部和夹爪新增五金对相邻固定支架共检查 236 个旋转网格姿态，未发现相交。

检查记录：`connection_geometry_checks.json`、`export_roundtrip_checks.json`、`transmission_fastener_collision_samples.json`、`hardware_servo_probe.json`、`fastener_rotation_checks.json`、`nut_hub_clearance.json`。

**未完成实物验证，不作“打印必然能用”的承诺。** 下载舵机/部分舵盘模型本身不是封闭实体，外观匹配不代表花键、螺纹或轴向插入深度经过测量。本轮未做整机全范围碰撞、长期载荷、夹持重量、跌落或疲劳测试。底座舵机安装耳在源 CAD 中约 0.4 的轴向垫高差也仍需实物核对；它与本轮已补齐的舵盘承压垫台不是同一处。

本轮不新增外置滚动轴承，也没有把打印圆柱冒充轴承。原结构的从动支点、轴套/轴承选型、夹爪销轴、舵机安装耳五金和整机承载仍需要在整机定型时统一核验。本包完成的是舵盘传动连接建模与接口试装交付。
