77-GGG/CyberArm/simulator/backend/cyberarm/server.py

import asyncio
from concurrent.futures import ProcessPoolExecutor
from contextlib import asynccontextmanager
import json
import secrets
import time
from typing import Literal
import uuid
import numpy as np
from fastapi import FastAPI, HTTPException, Request, WebSocket, WebSocketDisconnect
from fastapi.responses import FileResponse
from fastapi.staticfiles import StaticFiles
from pydantic import BaseModel, ConfigDict, Field, model_validator
from .model import Robot, ROOT
from .planner import plan_job, warm_worker, workspace_job
from .reachability import reachability_job, manual_job
from .commands import CommandRequest, run_command, catalogue
from .hardware import DEFAULT_BAUD, HardwareBridge, HardwareError
from .calibration import CalibrationStore
from .calibration_api import router as calibration_router

class Strict(BaseModel):
    model_config=ConfigDict(extra='forbid',allow_inf_nan=False)
class Step(Strict):
    kind:Literal['joint','cartesian','linear','wait']
    q_deg:list[float]|None=Field(default=None,min_length=6,max_length=6)
    position_mm:list[float]|None=Field(default=None,min_length=3,max_length=3)
    direction:list[float]|None=Field(default=None,min_length=3,max_length=3)
    seconds:float=Field(default=1,ge=.02,le=60)
    @model_validator(mode='after')
    def required(self):
        if self.kind=='joint' and self.q_deg is None:raise ValueError('缺少关节角度')
        if self.kind in ('cartesian','linear') and self.position_mm is None:raise ValueError('缺少目标坐标')
        return self
class PlanRequest(Strict):
    steps:list[Step]=Field(min_length=1,max_length=100)
    speed:float=Field(default=.7,ge=.05,le=1)
class Obstacle(Strict):
    name:str=Field(min_length=1,max_length=64)
    center:list[float]=Field(min_length=3,max_length=3)
    size:list[float]=Field(min_length=3,max_length=3)
    @model_validator(mode='after')
    def dimensions(self):
        if any(v<=0 or v>2 for v in self.size) or any(abs(v)>2 for v in self.center):raise ValueError('场景尺寸范围非法')
        return self
class Scene(Strict):
    obstacles:list[Obstacle]=Field(default_factory=list,max_length=20)
class Execute(Strict):
    plan_id:str
class Control(Strict):
    action:Literal['pause','stop','reset']
class Pose(Strict):
    q_deg:list[float]=Field(min_length=6,max_length=6)
class HardwareConnect(Strict):
    port:str=Field(min_length=1,max_length=128)
    baud:int=Field(default=DEFAULT_BAUD,ge=9600,le=3000000)
class HardwareCalibration(Strict):
    axis:int=Field(ge=1,le=6)
    min_us:int=Field(ge=500,le=2500)
    center_us:int=Field(ge=500,le=2500)
    max_us:int=Field(ge=500,le=2500)
    reversed:bool=False
class HardwareAxis(Strict):
    axis:int=Field(ge=1,le=6)
    confirmation:Literal['SUPPORTED']
class HardwareArm(Strict):
    confirmation:Literal['SUPPORTED']
class Reachability(Strict):
    position_mm:list[float]=Field(min_length=3,max_length=3)
    seed_deg:list[float]=Field(min_length=6,max_length=6)
    direction:list[float]|None=Field(default=None,min_length=3,max_length=3)
    refine:bool=True
    seq:int
    revision:int
    @model_validator(mode='after')
    def nonzero_direction(self):
        if self.direction is not None and np.linalg.norm(self.direction)<1e-8:raise ValueError('工具方向不能为零')
        return self
class Project(Strict):
    schema_version:Literal[1]
    model_version:str
    steps:list[Step]=Field(max_length=100)
    loops:int=Field(default=1,ge=1,le=10)
    obstacles:list[Obstacle]=Field(default_factory=list,max_length=20)
    speed:float=Field(default=.7,ge=.05,le=1)
    @model_validator(mode='after')
    def count(self):
        if len(self.steps)*self.loops>100:raise ValueError('展开动作不能超过 100 步')
        return self

class Manual(Strict):
    kind:Literal['joint','cartesian']
    q_deg:list[float]|None=Field(default=None,min_length=6,max_length=6)
    position_mm:list[float]|None=Field(default=None,min_length=3,max_length=3)
    direction:list[float]|None=Field(default=None,min_length=3,max_length=3)
    refine:bool=True
    seq:int
    revision:int
    @model_validator(mode='after')
    def target(self):
        if self.kind=='joint' and self.q_deg is None:raise ValueError('缺少关节角度')
        if self.kind=='cartesian' and self.position_mm is None:raise ValueError('缺少目标坐标')
        if self.direction is not None and np.linalg.norm(self.direction)<1e-8:raise ValueError('工具方向不能为零')
        return self

class Controller:
    def __init__(self):
        self.r=Robot();self.q=np.zeros(6);self.mode='READY';self.seq=0;self.revision=0
        self.obstacles=[];self.plans={};self.active=None;self.t=0.;self.stop_t=0.;self.stop_duration=.1
        self.pause_requested=False;self.paused=None;self.events=[];self.clients={};self.owner=None
        self.generation=0;self.busy=False;self.planning_owner=None;self.execution=None;self.last_error='';self.last_dt=.02
    def log(self,message):
        self.events.append({'time':time.strftime('%H:%M:%S'),'message':message});self.events=self.events[-60:]
    def current_segment(self):
        for segment in self.active['segments']:
            if self.t<segment['at']+segment['duration']-1e-10:return segment
        return self.active['segments'][-1]
    def evaluate(self):
        s=self.current_segment();u=self.r.curve(min(s['duration'],max(0,self.t-s['at'])),s['duration'])[0]
        self.q=np.array(s['start'])+(np.array(s['end'])-s['start'])*u
    def stop(self,pause=False):
        self.generation+=1
        self.plans.clear()
        if self.mode=='STOPPING':
            if not pause:self.pause_requested=False
            return
        if self.mode!='RUNNING':
            if not pause:self.paused=None;self.mode='READY'
            return
        self.pause_requested=pause;self.stop_t=0.;self.mode='STOPPING'
        velocities=[1.875*np.abs(np.array(s['end'])-s['start'])/s['duration'] for s in self.active['segments']]
        self.stop_duration=max(.08,float(np.max(np.max(velocities,axis=0)/(self.r.amax*.5))))
        self.log('沿已验证路径减速'+('并暂停' if pause else '停止'))
    def advance(self,dt):
        if not self.active or self.mode not in ('RUNNING','STOPPING'):return
        if self.mode=='RUNNING':self.t+=dt
        else:
            old=self.stop_t;new=min(self.stop_duration,old+dt)
            self.t+=(new-old)-(new*new-old*old)/(2*self.stop_duration);self.stop_t=new
        self.t=min(self.t,self.active['duration']);self.evaluate();self.seq+=1
        if self.t>=self.active['duration']-1e-9:
            self.execution={'plan_id':self.active.get('plan_id'),'status':'completed'}
            self.q=np.array(self.active['end']);self.mode='READY';self.active=None;self.paused=None;self.log('动作完成')
        elif self.mode=='STOPPING' and self.stop_t>=self.stop_duration:
            self.execution={'plan_id':self.active.get('plan_id'),'status':'paused' if self.pause_requested else 'stopped'}
            self.paused=self.active if self.pause_requested else None
            self.mode='PAUSED' if self.pause_requested else 'READY';self.active=None;self.log('已暂停' if self.pause_requested else '已停止')
    def snapshot(self):
        matrices,tcp=self.r.transforms(self.q)
        return {'mode':self.mode,'q_deg':np.degrees(self.q).tolist(),'matrices':matrices,'tcp':tcp,
                'seq':self.seq,'revision':self.revision,'time':self.t,'duration':self.active['duration'] if self.active else 0,
                'events':self.events[-12:],'planning':self.busy,'error':self.last_error,'obstacles':self.obstacles,'execution':self.execution,
                'hardware':hardware.snapshot() if hardware else None,'effective_limits_deg':effective_limits()}

c=None;pool=None;hardware=None;trial_busy=False;manual_busy=False;token=secrets.token_urlsafe(32)

calibration_owner=None
calibration_lock=None
calibration_store=None

def effective_limits():
    state=hardware.snapshot() if hardware else {}
    if state.get('armed') and hasattr(hardware,'effective_limits'):
        return hardware.effective_limits()
    if state.get('connected') and hasattr(hardware,'model_limits'):
        return hardware.model_limits()
    return c.r.data['limits_deg']

def guard_debug():
    state=hardware.snapshot() if hardware else {}
    if (calibration_lock and calibration_lock.locked()) or calibration_owner or state.get('mode') in ('SERVICE','ARMING'):
        raise HTTPException(409,'请先结束单轴调试或等待使能过渡完成')

def configuration_key():
    state=hardware.snapshot() if hardware else {}
    return (state.get('device_id'),state.get('wiring_hash'),state.get('armed'),
            tuple(m.get('revision') for m in state.get('mappings',[])),tuple(state.get('limits_revisions',[])))

async def pause_hardware(reason):
    state=hardware.snapshot() if hardware else {}
    if not state.get('connected') or not state.get('armed'):return
    try:await hardware.control('pause')
    except HardwareError as exc:c.log(reason+'；实机通信异常：'+str(exc))

async def ticker():
    previous=time.monotonic();accumulator=0.
    while True:
        await asyncio.sleep(.01);now=time.monotonic();dt=now-previous;previous=now
        if dt>.3:
            c.stop(True);c.log('系统时钟停顿：已冻结追赶并请求暂停');asyncio.create_task(pause_hardware('系统时钟停顿'));accumulator=0.;continue
        accumulator+=dt
        if c.mode=='RUNNING' and c.owner and now-c.clients.get(c.owner,0)>1.5:
            c.stop(True);c.log('操控端失联，自动暂停');asyncio.create_task(pause_hardware('操控端失联'))
        while accumulator>=.02:c.advance(.02);accumulator-=.02

async def hardware_heartbeat():
    global calibration_owner
    while True:
        # The calibration lease already sends a request every 300 ms. Keep a
        # slower independent heartbeat so an expired lease is still observed,
        # without making both loops contend for USB CDC at nearly the same rate.
        await asyncio.sleep(1.0 if calibration_owner else .4)
        before=hardware.snapshot()
        if not before.get('connected'):continue
        try:
            after=await hardware.heartbeat()
            if calibration_owner and not calibration_lock.locked() and not after.get('test',{}).get('active'):calibration_owner=None
            if before.get('armed') and (not after.get('armed') or after.get('mode')=='FAULT'):
                c.stop(True);c.log('固件输出状态已改变，仿真已暂停')
        except HardwareError as exc:
            if before.get('armed'):
                c.stop(True);c.log('ESP32-S3 失联，仿真已暂停；固件看门狗将保持当前位置：'+str(exc))

@asynccontextmanager
async def lifespan(app):
    global c,pool,hardware,calibration_owner,calibration_lock,calibration_store
    calibration_owner=None;calibration_lock=asyncio.Lock();calibration_store=CalibrationStore()
    c=Controller();pool=ProcessPoolExecutor(max_workers=2)
    hardware=HardwareBridge(c.r.data['model_id'],c.r.data['limits_deg'])
    c.log('RevC 模拟器就绪；实机输出默认关闭')
    # Every worker pays about a second of import and collision-archive
    # decompression on its first job. Both are cached for the life of the
    # process, so warming each worker now moves that cost into startup instead
    # of leaving it on the first preview. The pool starts its workers eagerly,
    # so two queued warm-ups land on two distinct processes.
    def report(future):
        if not future.cancelled() and future.exception():c.log('规划进程预热失败：'+repr(future.exception()))
    loop=asyncio.get_running_loop()
    for _ in range(2):loop.run_in_executor(pool,warm_worker).add_done_callback(report)
    task=asyncio.create_task(ticker());hardware_task=asyncio.create_task(hardware_heartbeat())
    yield
    task.cancel();hardware_task.cancel();await hardware.disconnect();pool.shutdown(wait=False,cancel_futures=True)

app=FastAPI(title='CyberArm Studio',lifespan=lifespan)
app.include_router(calibration_router)
@app.middleware('http')
async def session_guard(request:Request,call_next):
    if request.url.path.startswith('/api/') and request.method!='GET':
        origin=request.headers.get('origin')
        valid_origin=origin is None or origin==str(request.base_url).rstrip('/')
        if not valid_origin or request.headers.get('x-session')!=token:
            from fastapi.responses import JSONResponse
            return JSONResponse({'detail':'无效本地会话'},status_code=403)
    return await call_next(request)

@app.get('/api/bootstrap')
async def bootstrap():return {'session':token,'model':c.r.data,'version':c.r.version,'state':c.snapshot()}
@app.get('/api/state')
async def state():return c.snapshot()
@app.get('/api/hardware')
async def hardware_state():return hardware.snapshot()
@app.get('/api/hardware/ports')
async def hardware_ports():
    try:return {'ports':await hardware.list_ports()}
    except HardwareError as exc:raise HTTPException(503,str(exc))
@app.post('/api/hardware/connect')
async def hardware_connect(body:HardwareConnect):
    global calibration_owner
    if c.busy or manual_busy or c.mode in ('RUNNING','STOPPING'):raise HTTPException(409,'请先停止运动')
    calibration_owner=None;c.generation+=1;c.plans.clear()
    try:
        result=await hardware.connect(body.port,body.baud);c.log(f'ESP32-S3 已连接：{body.port}');return result
    except HardwareError as exc:raise HTTPException(502,str(exc))
@app.post('/api/hardware/disconnect')
async def hardware_disconnect():
    global calibration_owner
    calibration_owner=None
    c.generation+=1;c.plans.clear()
    if c.mode in ('RUNNING','STOPPING'):
        c.stop(True)
    result=await hardware.disconnect();c.log('ESP32-S3 已断开，实机输出关闭');return result
@app.post('/api/hardware/calibration')
async def hardware_calibration(body:HardwareCalibration):
    if c.mode in ('RUNNING','STOPPING'):raise HTTPException(409,'请先停止动作再修改实机校准')
    try:
        result=await hardware.set_calibration(body.axis,body.min_us,body.center_us,body.max_us,body.reversed)
        c.log(f'实机通道 {body.axis} 校准已保存');return result
    except HardwareError as exc:raise HTTPException(422,str(exc))
@app.post('/api/hardware/center')
async def hardware_center(body:HardwareAxis):
    if c.mode in ('RUNNING','STOPPING'):raise HTTPException(409,'请先停止动作再测试中位')
    try:
        result=await hardware.center_axis(body.axis,body.confirmation);c.log(f'实机通道 {body.axis} 正在输出中位');return result
    except HardwareError as exc:raise HTTPException(409,str(exc))
@app.post('/api/hardware/arm')
async def hardware_arm(body:HardwareArm):
    guard_debug()
    if c.busy or manual_busy:raise HTTPException(409,"请等待当前操作完成")
    if c.mode in ('RUNNING','STOPPING'):raise HTTPException(409,'运动中不能使能实机跟随')
    try:
        result=await hardware.arm(c.snapshot()['q_deg'],body.confirmation);c.log('实机跟随已使能');return result
    except HardwareError as exc:raise HTTPException(409,str(exc))
@app.post('/api/hardware/disarm')
async def hardware_disarm():
    global calibration_owner
    calibration_owner=None
    c.generation+=1;c.plans.clear()
    try:
        if c.mode in ('RUNNING','STOPPING'):c.stop(True)
        result=await hardware.disarm();c.log('实机跟随已关闭，PWM 已释放');return result
    except HardwareError as exc:raise HTTPException(502,str(exc))
@app.get('/api/commands')
async def commands():return {'protocol_version':1,'commands':catalogue()}
@app.post('/api/command')
async def command(body:CommandRequest,request:Request):return await run_command(body,request)
@app.post('/api/pose')
async def pose(body:Pose):
    q=np.radians(body.q_deg)
    limits=np.radians(effective_limits())
    if np.any(q<limits[:,0]) or np.any(q>limits[:,1]):raise HTTPException(422,'姿态超出模拟限制')
    matrices,tcp=c.r.transforms(q)
    return {'matrices':matrices,'tcp':tcp}
@app.post('/api/validate-project')
async def validate_project(body:Project):return body.model_dump(exclude_none=True)
@app.post('/api/reachability')
async def reachability(body:Reachability):
    global trial_busy
    guard_debug()
    if c.mode not in ('READY','PAUSED') or c.busy:raise HTTPException(409,'请等待当前运动或规划结束')
    if (body.seq,body.revision)!=(c.seq,c.revision):raise HTTPException(409,'执行状态或场景已改变，请重新求解')
    if trial_busy:raise HTTPException(429,'试摆求解忙，请稍后重试')
    trial_busy=True;generation=c.generation
    try:
        result=await asyncio.get_running_loop().run_in_executor(pool,reachability_job,
                    {**body.model_dump(),'limits_deg':effective_limits(),'obstacles':c.obstacles})
        if generation!=c.generation or (body.seq,body.revision)!=(c.seq,c.revision):
            raise HTTPException(409,'求解期间状态已改变，请重新求解')
        return {**result,'seq':body.seq,'revision':body.revision}
    except ValueError as exc:raise HTTPException(422,str(exc))
    finally:trial_busy=False
@app.post('/api/heartbeat')
async def heartbeat(request:Request):
    c.clients[request.headers.get('x-client','sdk')]=time.monotonic();return {'ok':True}
@app.post('/api/release')
async def release(request:Request):
    client=request.headers.get('x-client','sdk')
    if calibration_owner and calibration_owner[0]==client:await hardware_disarm()
    c.clients.pop(client,None)
    if c.owner==client or c.planning_owner==client:
        c.stop(True);await pause_hardware('控制客户端释放')
    return {'ok':True}

@app.post('/api/manual')
async def manual(body:Manual):
    global manual_busy
    guard_debug()
    if c.mode!='READY' or c.busy:raise HTTPException(409,'请先停止自动动作或等待路径检查完成')
    if manual_busy:raise HTTPException(429,'手动更新正在处理')
    if (body.seq,body.revision)!=(c.seq,c.revision):raise HTTPException(409,'当前位置或场景已改变')
    manual_busy=True;generation=c.generation;config=configuration_key()
    try:
        result=await asyncio.get_running_loop().run_in_executor(pool,manual_job,
            {**body.model_dump(),'limits_deg':effective_limits(),'seed_deg':np.degrees(c.q).tolist(),'obstacles':c.obstacles})
        if config!=configuration_key() or c.mode!='READY' or c.busy or generation!=c.generation or (body.seq,body.revision)!=(c.seq,c.revision):
            raise HTTPException(409,'更新期间状态已改变，未应用手动目标')
        if result['status']=='reachable':
            if hardware.snapshot().get('armed'):
                try:await hardware.target(result['q_deg'])
                except HardwareError as exc:raise HTTPException(502,'实机未接受手动目标：'+str(exc))
                if config!=configuration_key() or c.mode!='READY' or c.busy or generation!=c.generation or (body.seq,body.revision)!=(c.seq,c.revision):
                    raise HTTPException(409,'实机下发期间状态已改变，目标已停止')
            c.q=np.radians(result['q_deg']);c.seq+=1;c.generation+=1;c.plans.clear();c.paused=None;c.last_error=''
        return {**result,'state':c.snapshot()}
    except ValueError as exc:raise HTTPException(422,str(exc))
    finally:manual_busy=False

async def make_plan(body,client):
    guard_debug()
    if c.mode not in ('READY','PAUSED'):raise HTTPException(409,'请先停止或暂停当前动作')
    if c.busy:raise HTTPException(409,'已有规划任务；可停止取消其结果')
    c.busy=True;c.planning_owner=client;generation=c.generation;seq=c.seq;revision=c.revision;start=c.q.copy();begin=time.monotonic();config=configuration_key()
    try:
        result=await asyncio.get_running_loop().run_in_executor(pool,plan_job,{'limits_deg':effective_limits(),'start':start.tolist(),'obstacles':c.obstacles,**body.model_dump(exclude_none=True)})
        if config!=configuration_key() or (generation,seq,revision)!=(c.generation,c.seq,c.revision):raise HTTPException(409,'规划期间状态已改变，请重新预览')
        result.update(hardware_config=config,plan_id=uuid.uuid4().hex,seq=seq,revision=revision,version=c.r.version,created=time.monotonic(),owner=client)
        c.plans={result['plan_id']:result};c.last_error='';c.log(f"预览通过：{result['checks']} 个检查区间，耗时 {time.monotonic()-begin:.2f}s")
        return result
    except ValueError as e:
        c.last_error=str(e);c.log('拒绝：'+str(e));raise HTTPException(422,str(e))
    finally:c.busy=False;c.planning_owner=None

@app.post('/api/plan')
async def plan(body:PlanRequest,request:Request):return await make_plan(body,request.headers.get('x-client','sdk'))
@app.post('/api/execute')
async def execute(body:Execute,request:Request):
    guard_debug()
    client=request.headers.get('x-client','sdk');p=c.plans.get(body.plan_id)
    if not p or p.get('hardware_config')!=configuration_key() or c.mode not in ('READY','PAUSED') or (p['seq'],p['revision'],p['version'])!=(c.seq,c.revision,c.r.version) or time.monotonic()-p['created']>120 or p['owner']!=client:raise HTTPException(409,'预览已失效、来源不符或控制器忙，请重新预览')
    generation=c.generation;delay=0.
    if hardware.snapshot().get('armed'):
        c.busy=True
        try:delay=await hardware.prepare_plan(p)
        except HardwareError as exc:raise HTTPException(502,'实机轨迹下发失败：'+str(exc))
        finally:c.busy=False
        if generation!=c.generation or c.plans.get(body.plan_id) is not p:
            try:await hardware.control('stop')
            except HardwareError:pass
            raise HTTPException(409,'轨迹下发期间状态已改变，执行已取消')
        if delay:await asyncio.sleep(delay)
        if generation!=c.generation or c.plans.get(body.plan_id) is not p:
            try:await hardware.control('stop')
            except HardwareError:pass
            raise HTTPException(409,'同步启动等待期间状态已改变，执行已取消')
    c.active=p;c.plans.clear();c.paused=None;c.mode='RUNNING';c.t=0.;c.owner=client;c.clients[client]=time.monotonic();c.seq+=1
    c.execution={'plan_id':p['plan_id'],'status':'running'};c.log('开始'+('实机同步' if hardware.snapshot().get('armed') else '模拟')+'执行');return {'ok':True,'plan_id':p['plan_id']}
@app.post('/api/control')
async def control(body:Control):
    if body.action in ("pause","stop") and hardware.snapshot().get("mode")=="SERVICE":
        await hardware_disarm()
    if body.action=='reset':
        if c.mode in ('RUNNING','STOPPING'):raise HTTPException(409,'请先停止动作')
        if hardware.snapshot().get('armed'):raise HTTPException(409,'实机已使能；请先关闭实机跟随再重置仿真')
        c.q=np.zeros(6);c.seq+=1;c.generation+=1;c.plans.clear();c.paused=None;c.execution=None;c.mode='READY';c.log('重置模拟状态，非实物回零')
    else:
        hardware_error=None
        if hardware.snapshot().get('armed'):
            try:await hardware.control(body.action)
            except HardwareError as exc:hardware_error=exc
        c.stop(body.action=='pause')
        if hardware_error:raise HTTPException(502,'仿真已停止，但实机通信失败；请切断舵机电源：'+str(hardware_error))
    return c.snapshot()
@app.post('/api/resume')
async def resume(request:Request):
    if not c.paused or c.mode!='PAUSED':raise HTTPException(409,'没有待继续动作')
    remaining=[]
    for s in c.paused['segments']:
        if s['at']+s['duration']<=c.t:continue
        if np.allclose(s['start'],s['end']):remaining.append(Step(kind='wait',seconds=max(.02,s['at']+s['duration']-max(c.t,s['at']))))
        else:remaining.append(Step(kind='joint',q_deg=np.degrees(s['end']).tolist()))
    result=await make_plan(PlanRequest(steps=remaining),request.headers.get('x-client','sdk'))
    return result
@app.post('/api/scene')
async def scene(body:Scene):
    if c.mode in ('RUNNING','STOPPING'):raise HTTPException(409,'请先停止再编辑场景')
    c.obstacles=[o.model_dump() for o in body.obstacles];c.revision+=1;c.generation+=1;c.plans.clear();c.log('场景已更新，旧预览失效');return c.snapshot()
@app.post('/api/workspace')
async def workspace(body:dict):
    direction=body.get('direction')
    if direction is not None and (len(direction)!=3 or not np.isfinite(direction).all() or np.linalg.norm(direction)<1e-8):raise HTTPException(422,'方向非法')
    return await asyncio.get_running_loop().run_in_executor(pool,workspace_job,{'direction':direction,'limits_deg':effective_limits()})
@app.websocket('/ws')
async def websocket(ws:WebSocket):
    if ws.query_params.get('session')!=token:await ws.close(code=1008);return
    await ws.accept();client=ws.query_params.get('client','browser')
    try:
        while True:
            await ws.send_json(c.snapshot())
            try:
                await asyncio.wait_for(ws.receive_text(),timeout=.25)
                c.clients[client]=time.monotonic()
            except asyncio.TimeoutError:
                pass
    except (WebSocketDisconnect,RuntimeError):
        if calibration_owner and calibration_owner[0]==client:await hardware_disarm()
        c.clients.pop(client,None)
        if c.owner==client or c.planning_owner==client:
            c.stop(True);await pause_hardware('界面连接断开')

app.mount('/models',StaticFiles(directory=ROOT/'assets/revc'),name='models')
if (ROOT/'frontend/dist').exists():app.mount('/',StaticFiles(directory=ROOT/'frontend/dist',html=True),name='frontend')
