77-GGG/CyberArm/(commit log)

2026-09-04 feat: add safe PCA9685 servo control library
2026-09-06 docs: 添加 CyberArm K230D BOX 系统设计文档
    - 整理机械臂功能、软硬件架构、通信协议与验收流程
    - 明确 K230D BOX 与 ESP32-S3 的任务分工和接口
    - 忽略本地 .codex 配置目录
2026-09-08 feat(mechanical): add RevC assembly and organized print package
    [01_底座壳_打印1件__Base_RevC_mm.stl, 02_支脚_打印4件__Pata_de_Soporte_RevC_mm.stl, 03_回转盘与肩部支架_打印1件__Waist_RevC_mm.stl, 04_大臂_打印1件__Arm_01_RevC_mm.stl, 05_小臂_打印1件__Arm_02_v3_RevC_mm.stl, 06_腕部支架_打印1件__Arm_03_RevC_mm.stl, 07_夹爪底板_打印1件__Gripper_base_RevC_mm.stl, 08_从动齿轮连杆_打印1件__gear1_RevC_mm.stl]
2026-09-14 feat(上位机): 完成 RevC 机械臂本地模拟工作台
    - 新增基于 React、Three.js 和 FastAPI 的本地上位机模拟软件
    - 接入 RevC 机械臂三维模型和五轴运动链
    - 增加关节、夹爪、末端坐标、MoveJ、MoveL 和逆运动学控制
    - 增加工作空间采样、关节限位、桌面、障碍物和路径碰撞检查
    - 增加动作序列、等待、循环、暂停、继续、停止和失联保护
    - 增加项目 JSON 导入导出、Python SDK 和本地启动脚本
    - 新增 C++ 正运动学、夹爪闭链、轨迹和 BVH 碰撞核心
    - 更新系统设计、上位机架构、界面说明和技术问题记录
    验证结果：
    - C++ CTest：1/1 通过
    - Python pytes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
    [model.py, planner.py]
2026-09-14 build(发布): 新增 Windows Electron 构建目录
    - 增加 Electron 主进程和 FastAPI sidecar 启动入口\n- 增加 electron-builder NSIS 与便携版配置\n- 增加 PyInstaller 后端打包脚本和 Windows 构建说明\n- 支持打包后的模型、资源和 C++ DLL 路径\n- 补充跨平台发布、手动检查更新和自动安装方案
2026-09-15 test: verify console window and packaged workbench flows
2026-09-15 feat: mirror validated motion to ESP32-S3
2026-09-16 refactor(firmware): split ESP32-S3 control into modules
2026-09-17 feat: add single-axis calibration workbench and JSON wiring config
    Firmware 0.3.0 adds an independent single-axis test lease that expires
    after 1200 ms without renewal and cannot be extended by the transport
    heartbeat, angle mapping from 3-7 monotonic measurement points with an
    atomic NVS commit and read-back, an ARMING transition that blocks
    target/prepare, and host C++ tests that execute the real modules.
    hwcal and hwcenter are rejected: three pulse widths cannot certify a
    measured angle.
    The studio replaces the servo page with a four-step workbench: single
    channel jog by PCA9685 counts, manual reading capture, draft records,
    and save with read-back. Calibration is bound to the device, mo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
    [calibration.py, calibration_api.py, commands.py, firmware_host_test.cpp, generate_wiring.py]
2026-09-17 test: run the calibration workbench spec against packaged builds
2026-09-18 feat: restructure single-axis calibration and make model limits editable
    The workbench now walks through five steps with per-step gating: only the current task is shown, missing zero/two-sided samples/range coverage block the next step, validation records bind to the exact target and device revision, and switching axes or devices restores the matching draft.
    Model soft limits become a device parameter instead of a compiled constant. Firmware 0.4.0 stores one limits blob per axis in NVS bound to the model and wiring hash, exposes capabilities.editable_limits, model_limits_deg and limits_revisions, and serves arm/target/trajectory checks from the stored values. The host validates a candidate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
    [calibration_api.py, commands.py, firmware_host_test.cpp, hardware.py, model.py, planner.py, server.py]
2026-09-18 docs: record 0.9.0 release
    Record the five-step calibration flow, the device-stored model soft limits in firmware 0.4.0, the read-only zero-pose reference, and the published 0.9.0 installer with its verification scope and remaining hardware gaps.
2026-09-18 fix: keep the ESP32 link alive through transient serial stalls
    Firmware 0.4.2 sets the USB CDC receive queue to 4096 B before Serial.begin(). The default 256 B queue silently dropped the tail of any longer request, so save_mapping (about 320 B) reached the parser without its closing array and newline: the firmware stayed silent by design, the half line stayed in the input buffer and corrupted the following commands, and the host reported a save_mapping timeout plus a disconnect instead of a clear error. The command set, protocol version and calibration formats are unchanged.
    On the host, one delayed heartbeat is no longer enough to tear the link down. HardwareBridge retries a single transie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
    [calibration_api.py, firmware_host_test.cpp, hardware.py, server.py]
2026-09-18 docs: add CyberArm presentation materials
